bobdrzyzgula/VSM-Base/hardware/mcu-controller-rectified/netlist.txt

<+3V3> A1.L14
<+3V3> C15.1
<+3V3> C16.1
<+3V3> C5.1
<+3V3> J4.1
<+3V3> J5.1
<+3V3> J6.1
<+3V3> R14.1
<+3V3> R24.1
<+3V3> R25.1
<+3V3> R28.1
<+3V3> R9.1
<+3V3> RV2.1
<+3V3> U4.1
<+3V3> U5.1
<+3V3> U6.1
<+5V> C12.1
<+5V> C13.1
<+5V> D1.1
<+5V> D2.2
<+5V> K1.1
<+5V> PS1.3
<GND> A1.L2
<GND> A1.R4
<GND> C10.2
<GND> C11.2
<GND> C12.2
<GND> C13.2
<GND> C14.2
<GND> C15.2
<GND> C16.2
<GND> C17.2
<GND> C18.2
<GND> C19.2
<GND> C20.2
<GND> C3.2
<GND> C4.2
<GND> C5.2
<GND> C6.2
<GND> C7.2
<GND> C8.2
<GND> C9.2
<GND> J4.3
<GND> J5.3
<GND> J6.4 R18.2
<GND> PS1.4
<GND> Q2.2
<GND> R13.2
<GND> R29.2
<GND> RV2.3
<GND> SW1.2
<GND> SW2.2
<GND> U2.4
<GND> U3.2
<GND> U4.3
<GND> U5.3
<GND> U6.3
A1.L10 C8.1 R19.2
A1.L11 C7.1 R17.2
A1.L12 C6.1 R16.2
A1.L4 D2.1
A1.L8 C19.1 R27.2
A1.L9 C9.1 R20.2
A1.R12 C11.1 SW2.1
A1.R13 C14.1 R21.2
A1.R14 C10.1 SW1.1
A1.R3 C17.1 R22.1
A1.R5 C18.1 R23.1
A1.R6 R11.2
A1.R7 R12.1
A1.R8 C3.1 R9.2 U2.5
A1.R9 C4.1 R15.1
BR1.1 J1.2 J2.3 PS1.2 R8.1 RV1.2
BR1.2 T1.1
BR1.3 D3.1 J3.1
BR1.4 D3.2 J3.2
C2.1 R6.2
C2.2 Q1.2 R4.1 T1.2
C20.1 R26.2 R28.2 R29.1 T1.3
D1.2 K1.2 Q2.3
F1.1 J1.1
F1.2 F2.1 J2.2 K1.3 R7.1 RV1.1
F2.2 PS1.1
J1.3 J2.1
J4.2 R16.1
J5.2 R17.1
J5.4 J6.3 R21.1
J6.2 R18.1 R19.1
K1.4 Q1.1 R5.1 R6.1
Q1.3 R5.2 U3.4
Q2.1 R12.2 R13.1
R11.1 U3.1
R14.2 R15.2 U4.2
R20.1 RV2.2
R22.2 R24.2 U5.2
R23.2 R25.2 U6.2
R26.1 R27.1 T1.4
R4.2 U3.6
R7.2 U2.1
R8.2 U2.2
