bobdrzyzgula/VSM-Base/hardware/mcu-controller-dc/netlist.txt

<+3V3> A1.L14
<+3V3> C15.1
<+3V3> C16.1
<+3V3> C5.1
<+3V3> J4.1
<+3V3> J5.1
<+3V3> J6.1
<+3V3> R14.1
<+3V3> R24.1
<+3V3> R25.1
<+3V3> RV2.1
<+3V3> U4.1
<+3V3> U5.1
<+3V3> U6.1
<+5V> C12.1 C13.1 PS1.3
<+5V> D2.2
<GND> A1.L2
<GND> A1.R4
<GND> A2.LGND
<GND> A2.PGND
<GND> C1.2
<GND> C10.2
<GND> C11.2
<GND> C12.2
<GND> C13.2
<GND> C14.2
<GND> C15.2
<GND> C16.2
<GND> C17.2
<GND> C18.2
<GND> C2.2
<GND> C20.2
<GND> C3.2
<GND> C4.2
<GND> C5.2
<GND> C6.2
<GND> C7.2
<GND> C8.2
<GND> C9.2
<GND> D1.2
<GND> J1.2
<GND> J4.3
<GND> J5.3
<GND> J6.4 R18.2
<GND> PS1.2
<GND> Q1.2
<GND> R11.2
<GND> R2.2
<GND> R4.2
<GND> R6.1
<GND> R8.2
<GND> RV2.3
<GND> SW1.2
<GND> SW2.2
<GND> U4.3
<GND> U5.3
<GND> U6.3
A1.L10 C8.1 R19.2
A1.L11 C7.1 R17.2
A1.L12 C6.1 R16.2
A1.L4 D2.1
A1.L5 C20.1 R1.2 R2.1
A1.L6 R7.2 R8.1
A1.L7 R5.1 R6.2
A1.L8 R3.2
A1.L9 C9.1 R20.2
A1.R12 C11.1 SW2.1
A1.R13 C14.1 R21.2
A1.R14 C10.1 SW1.1
A1.R15 A2.FLT
A1.R2 R10.1
A1.R3 C17.1 R22.1
A1.R5 C18.1 R23.1
A1.R6 A2.PWM
A1.R7 A2.DIR
A1.R8 A2.SLP
A1.R9 C4.1 R15.1
A2.CS R3.1
A2.OUTA C19.1 M1.1 R5.2
A2.OUTB C19.2 M1.2 R7.1
A2.VIN C1.1 C2.1 C3.1 D1.1 F1.2 PS1.1 R9.1
A2.VM R1.1
A2.VREF R4.1
F1.1 J1.1
J4.2 R16.1
J5.2 R17.1
J5.4 J6.3 R21.1
J6.2 R18.1 R19.1
Q1.1 R10.2 R11.1
Q1.3 R9.2
R14.2 R15.2 U4.2
R20.1 RV2.2
R22.2 R24.2 U5.2
R23.2 R25.2 U6.2
