bobdrzyzgula/VSM-Base/docs/motor-control/12-sources.md

# Sources

1. [Universal motor](https://en.wikipedia.org/wiki/Universal_motor), Wikipedia.
2. G. V. Fay, [*Direction and Speed Control for Series, Universal and Shunt Motors*](https://ftp.mirrorservice.org/sites/www.bitsavers.org/components/motorola/_appNotes/AN-0443_Direction_And_Speed_Control_For_Series_Universal_And_Shunt_Motors.pdf), Motorola AN-443.
3. [Resistance, carbon stack](https://physicsmuseum.uq.edu.au/resistance-carbon-stack), University of Queensland Physics Museum.
4. K. Hayashi, [*Carbon Pile for Automatic Voltage Regulators, Part 2*](https://www.jstage.jst.go.jp/article/tanso1949/3/2/3_2_56/_article), Tanso 3(2):56–59, 1953.
5. [Old Kenmore sewing machine foot control repair](https://softsolder.com/2009/03/10/old-kenmore-sewing-machine-foot-control-repair/), softsolder.com, March 2009.
6. [Help understanding a sewing machine pedal](https://www.eevblog.com/forum/beginners/help-understanding-a-sewing-machine-pedal/), EEVblog forum.
7. I. Skalka, [*Low-Cost Universal Motor Phase Angle Drive System*](https://nxp.com/docs/en/application-note/AN1662.pdf), Freescale AN1662.
8. [Speed Controller for Universal Motors](https://www.siliconchip.com.au/Issue/2002/October/Speed+Controller+For+Universal+Motors), Silicon Chip, October 2002.
9. [Autotransformer](https://en.wikipedia.org/wiki/Autotransformer), Wikipedia.
10. [TDA1085C universal motor speed controller](https://onsemi.com/download/data-sheet/pdf/tda1085c-d.pdf), onsemi data sheet, Rev. 10, July 2007.
11. [KBIC variable speed DC motor control](https://forums.parallax.com/uploads/attachments/41167/71583.pdf), KB Electronics data sheet D-210, 1998.
12. [KBMM variable speed DC motor control](https://motorsandcontrol.com/media/document/file/datasheets/9449.pdf), KB Electronics data sheet D-215.
13. [KBWC solid-state speed controls](https://moen.nidec.com/drives/-/media/Project/Nidec/KB/documents/triad-fan-controls/data-sheets/kbwc-data-sheet-031919.ashx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), KB Electronics / Nidec data sheet.
14. [KBSI-240D signal isolator](https://motorsandcontrol.com/kb-electronics-9431-kbsi-240d-signal-isolator-stand-alone), Motors & Control product page.

The base's own parts, used in §11: Bourns 91–99 series panel control datasheet;
Omron SS subminiature basic switch, Cat. No. B032-E1-14; Schurter KE IEC inlet
datasheet; WAGO 221-413. Links are in the User's Guide's knee-controller
chapter.
