bobdrzyzgula/VSM-Base/docs/images/photos/99k-front.jpg

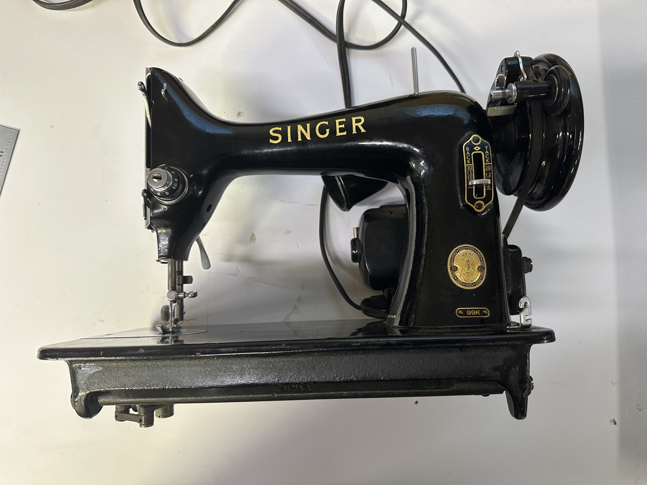
docs/images/photos/99k-front.jpg
