bobdrzyzgula/VSM-Base/docs/images/photos/99k-rear-corner-underside.jpg

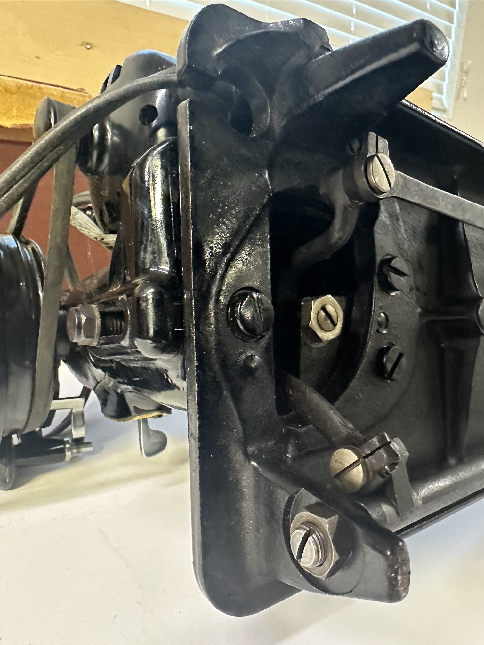
docs/images/photos/99k-rear-corner-underside.jpg
