bobdrzyzgula/VSM-Base/docs/images/renders/base-none.png

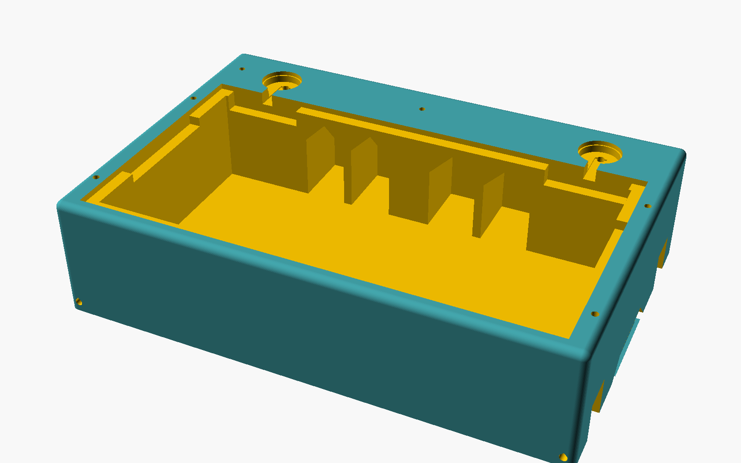
docs/images/renders/base-none.png
