bobdrzyzgula/VSM-Base/docs/images/renders/base-top.png

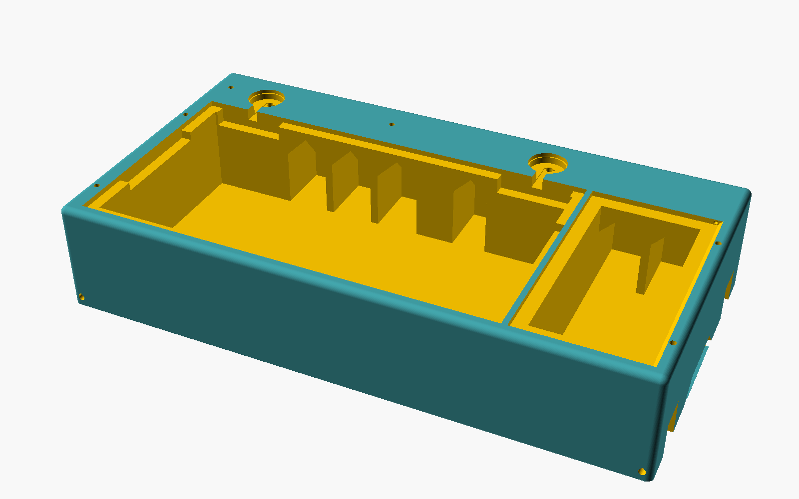
docs/images/renders/base-top.png
