bobdrzyzgula/VSM-Base/docs/images/renders/end-underside.png

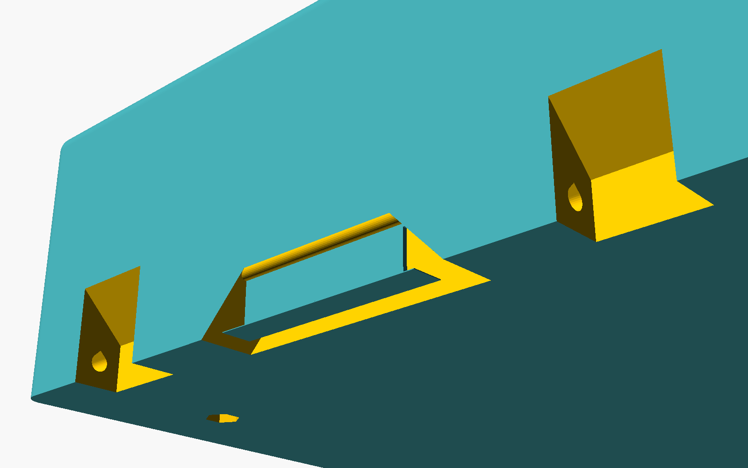
docs/images/renders/end-underside.png
