bobdrzyzgula/VSM-Base/docs/images/renders/exploded.png

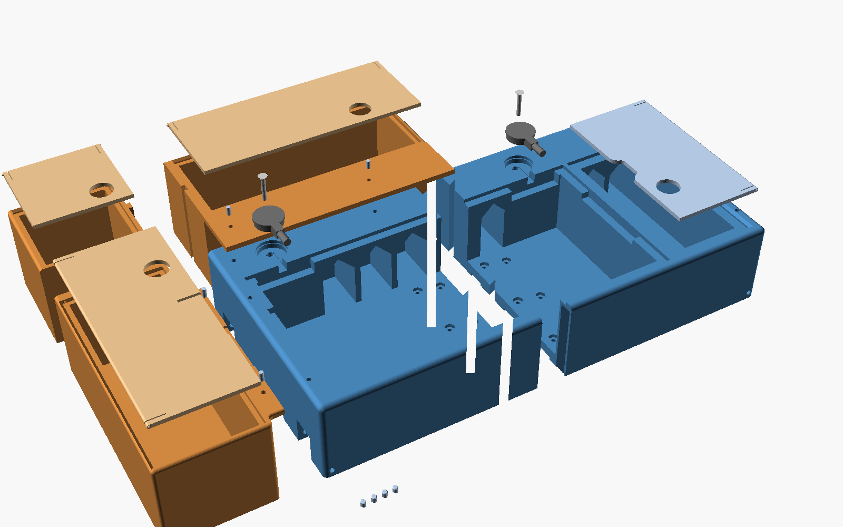
docs/images/renders/exploded.png
