bobdrzyzgula/VSM-Base/docs/images/renders/split.png

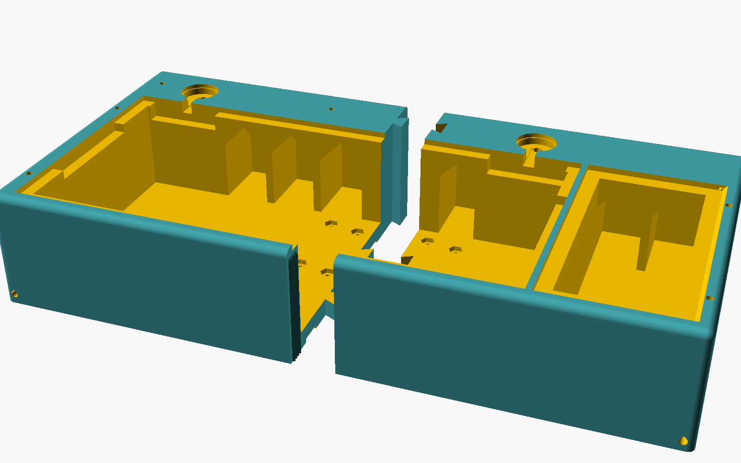
docs/images/renders/split.png
