bobdrzyzgula/VSM-Base/scad/vsm_base.scad

// SPDX-License-Identifier: MIT
// VSM Base, version 74
// Copyright (c) 2026 Robert Drzyzgula
// All dimensions in mm unless noted.
//
// Coordinate system: the base's outer front-left-bottom corner is at the
// origin. +X runs left to right (balance wheel / small compartment at +X),
// +Y runs front to back (hinges at the back), +Z is up.
//
// The bed seat, machine cavity, and hinge positions are derived from the
// measured Singer 99 bed casting rather than from an old wooden base.
//
// v5: flat split with placed dovetail keys, joined by steel mending plates
// (McMaster 1394A34)
// recessed into the underside, with nut traps on the cavity floor;
// nut traps under the hinge screws; gabled lightening tunnels in the
// back wall between the hinges.
//
// v6: tunnel and cord-hole floors flush with the cavity floor; a tunnel
// behind the small compartment; compartment_option "none" (base fitted
// to the bed alone); hinge_type selects the hinge, and the hinge's
// footprint drives the back rim, hinge position and keep-outs.
//
// v7: removable extensions that sit on the table and reach over the base
// rim with a lip whose top is level with the machine bed: a back
// compartment / outfeed support, a left compartment / extension, and a
// left-rear corner compartment that dovetails to both. Each has a lid set
// in a frame, optional bobbin-plate trenches, and pegs that drop into
// holes in the base rim. `part` selects what to render.
//
// v8: hinge moved 2 mm back (pin square no longer enters the seat);
// reliefs cut below the bed ledge where the casting is thickened, from a
// list; back-wall tunnels skip the reliefs.
//
// v9: part "all" (exploded layout, base split); bobbin-plate trenches
// measured from the bed edges, with the 99's left trench on by default;
// snap-in dimple hinges on every lid, including a new lid for the base's
// small compartment.
//
// v10: split dovetails set by flare angle (default 30 degrees) with less
// clearance, cutting pull-apart play from about 1 mm to about 0.3 mm.
//
// v11: left lip starts at the bed's front edge, with a rounded top edge
// and a filleted inside corner where it meets the extension body; the
// body's front-right edge is rounded. Lids are turned over for printing
// by rotation (v9-v10 mirrored them). New part "test_parts".
//
// v12: end walls 7/8" thick with handholds under each end, after the old
// wooden base; notches either side of each handhold with 3/16" steel rods
// across them for a carrying harness; sacrificial membrane over the plate
// screw holes; extension top slices in test_parts print upright.
//
// v13: handholds open to the end face, with a rounded lip and a ceiling
// climbing 45 degrees into the wall, printed over a thin knock-out wall;
// rod-notch ceilings climb 45 degrees toward the face (no support needed);
// the test_parts center slice is floor plus full-height wall stubs at the
// joint.
//
// v14: a small breakaway tab ties each knock-out wall to the end of its
// pocket, so the wall stays with its part when a slicer splits objects.
// Peg holes in the right rim too, for future right-side extensions.
//
// v15: machine profiles. Pick the machine from a list; the casting
// measurements, reliefs and bobbin trenches come from the profile table.
// Choose "Custom" to use the settings in the "Custom machine" section
// instead. A one-layer brim around the foot of each knock-out wall.
//
// v16: vertical V-serrations across the front wall's joint faces, hidden
// inside the wall, so the front faces register flush (the right half is
// lowered onto the left). Harness rods stop short of the face and printed
// plugs close the holes (part "rod_plugs"). The console ends with a
// hardware list for the configuration, with screw lengths rounded up to
// stock sizes.
//
// v17: the "outlet" compartment. The outlet stands on the compartment
// floor against the right end wall, face to the left, held by a #8 screw
// into a heat-set insert in the wall and located by low curbs on the
// floor; the plugs point straight at the cord pass-through. Its lid hinges
// on the left and has two cord slots, each on a chosen edge. Wider
// default pass-through.
//
// v18: lid type per lid (hinged, lift-out or none) and lid style (solid or
// perforated); a `compartments` list giving each accessory bay's usable
// interior, for organizer inserts that include this file; console output
// only when something is rendered (`report`); the outlet can be held by a
// through screw from the end face instead of a heat-set insert; part
// "hinge_coupon", a hinge recess block that doubles as a hinge insert for
// a wooden base.
//
// v19: freestanding extension boxes (parts back_box, left_box, corner_box);
// a wider ledge on a hinged extension lid's hinge side, so an open lid
// stays clear of the bay, with the corner bay kept square; a thumb-tab lid
// grip as an alternative to the finger hole; a notch in the base lid's left
// edge to clear the motor boss, from the machine profile.
//
// v20: lid hinges hold better: less end float at the hinge ends, a closer
// recess, steeper bump flanks, and stiffer flex tabs and deeper engagement
// by default (from print tests in PLA and PETG); part "lid_hinge_test" to
// tune them quickly. ext_top_adjust trims the extensions' top plane to the
// real bed. Extension pegs can be separate, replaceable parts (printed
// lying down, or cut from 3/16" rod) instead of molded into the lip.
//
// v21: optional turn button on the front rim, after the wooden bases: a
// smooth raised pad level with the bed, a printed button on a #8 screw
// with click detents at closed (over the bed edge) and open, and a nut
// slot reached from inside the machine cavity (part turn_button).
//
// v22: part "all" is now every part of the build, flat on the bed in print
// orientation and grouped into printer-sized plates; part "exploded" is
// the old exploded view; print_plate picks one plate. Plates keep parts of
// one kind together, put supported parts together only when their support
// interface is on the same layer, and leave room for a purge tower. A
// printer edge margin; the outlet is held by a through screw by default;
// fractional Customizer steps where they matter.
//
// v23: no mending-plate pockets on an unsplit base; optional knock-out
// walls closing both ends of the cord pass-through (an outlet base can be
// used for storage until they are tapped out), and a removable
// pass-through cover (part passthrough_cover).
//
// v24: organizer inserts: bobbin trays for the corner bay (a second stack
// goes in the freestanding corner box); notion trays for the back or left
// bay in 30-10 mm and custom heights, plain or compartmented; a spool tray.
//
// v25: the back lip runs on past a short back extension to reach the last
// back peg hole, its free end rounded and filleted into the body; LIGHT and
// MOTOR recessed into the outlet compartment floor by their receptacles;
// part split_test, the front of the split joint (serrations and first
// dovetail) for a quick fit test.
//
// v26: knee controller (compartment_option "knee"): a knee bar turns a
// shaft in the right bay; a gear sector turns a pot that replaces the donor
// speed-control board's slide pot, a snap switch cuts the motor at rest,
// and hard stops on the front face take the knee's force. Bulkhead, board
// posts, cover, cord clamp; parts knee_sector, knee_pinion, knee_hub,
// knee_cover, knee_cord_clamp, and a knee_assembly cutaway view. (v29
// reworks the mechanism; see below.)
//
// v27: knee controller power options (knee_power): the standard pedal
// cordset's molded entry with its steel clip, or a fused IEC C14 inlet
// with a Wago lever-connector junction under the bed, or a bare cord and
// clamp. Board posts fixed (handedness) and measured; the board turned end
// for end, with room for its spade connectors; earth contact for the
// shaft; cover vents for motors over 1 A; pot set at the hard stop; part
// knee_entry_test.
//
// v28: knee return spring chosen (McMaster 9271K585 / 9271K651) with its
// torque in the console; the switch's actuating point from Omron's
// drawing (5.3 mm from the lever's free end).
//
// v29: knee controller reworked to a new feel: about 1 lb at rest rising
// 1.5 lb/in, an inch of dead travel before the motor starts, full speed at
// 2" and a hard stop at 2.25". The return spring is now a compression
// spring in a housing on the front face, pushed by a crank on the knee hub,
// with steel screw stops for rest and full travel, so the knee's force never
// reaches the shaft, its set screws or the gears. Two-stage gearing (about
// 11.75:1) through an idler on a stub pin; the switch lies under the shaft,
// worked by a cam on the sector. Parts knee_idler, knee_spring_housing and
// knee_spring_cap; the stop pin is gone.
//
// v30: organizer trays from the first prints: compartment trays default to
// a 2" target cell (2 x 4 in the back or left bay); small gussets at the
// foot of the long walls of every notion tray and the spool tray's curbs,
// where a thin wall meets the floor at a single layer line; the spool
// tray's curb is 14 mm tall (was 10), to stiffen its floor along its length.
//
// v31: the small compartment can be an attached bay (compartment_mount):
// a separate part screwed to the base's right end, for beds too long to
// print with a built-in compartment. Four M5 screws from inside the machine
// cavity into heat-set inserts in the bay's inner wall, and two rod_d
// dowels, hold it; its top is flush with the base, and it has its own
// handhold and harness rods so the whole carries as one. The base keeps a
// handhold, rods and right-rim peg holes of its own. Storage only for now;
// its lid defaults to none. Parts right_bay and attach_test.
//
// v32: part hinge_nut_tool, a rod with a tapered tip that holds a nut in
// its trap from below while the hinge screw is started from above.
//
// v33: hinge_type "none", a base for a machine without hinges: no hinge
// recesses, nut traps, checks or hardware; the back-wall tunnels run the
// whole back wall. The back rim stays as wide as with hinges unless
// back_rim_width is set, so extensions are shared.
//
// v34: hinge_type "printed", a hinge to print for machines without usable
// hinges: a printed arm carries a steel pin into the bed's hinge hole and
// turns on a steel pivot rod held in a printed block, which sits in a
// recess in the back rim on the hinge screw and nut trap. The pin is set at
// the bed hole's height whatever the machine. A stop face on the block
// holds the machine at ph_stop_angle when tilted back. Parts
// printed_hinges (two arms and two blocks) and printed_hinge_test (rod
// fits); the back extension's lip is notched around the hinges.
//
// v35: printed hinge: the stop is a tail on the arm behind the pivot,
// landing in a pocket in the block, and the block is held by a screw from
// below into a nut pressed into its underside; the arm and cheeks are cut
// flush with the rim where ph_min_cover allows. Pin diameter and depth
// come from the profile. Machines set flush (bed_flush) or standing on
// their feet (foot_height_mm, which sets the floor); seat depth no longer
// tied to the lid rabbet. Lips recessed into the rim when the bed stands
// less than lip_min_t above it, with trims (back_trim, left_trim) for use
// without extensions; cord_slot through the back rim, with cord_slot_trim.
// Kenmore 158-14001 profile (measured by Bob Drzyzgula).
//
// v40: Kenmore profile named 158-14001: the Customizer reads a number
// such as 158.14001 in a menu entry as a number and shortens it, so
// profile names use a dash. Profiles are still found by the start of the
// name.
//
// v42: Customizer presets "<profile> (as Custom)" in vsm_base.json, built
// by tools/make_presets.py from the profiles; the console prints profile
// values to 8 decimals for them.
//
// v43: in the "all" view, each plate is as wide as the bed or its widest
// part, so a base printed whole no longer runs into the next plate. The
// header's version number tracks again.
//
// v44: part "tools": the things printed to help build or measure rather
// than parts of the base: the hinge nut tool, the printed hinge's rod-fit
// test and the foot-locating rig's two halves. test_parts stays for pieces
// of the base for trying fits.
//
// v45: no model changes; the guide's title page gives this version number
// for development builds ("Development Build v45").
//
// v46: printed hinge: the block's nut slides into a slot from its front
// face, with plastic under it, so the screw from below clamps the block
// (the nut in an open pocket underneath was drawn out of it, clamping
// nothing); the recess's front wall closes the slot. From Bob's review.
//
// v47: rod-fit test: a plus, not a dash, over the sixth (running-fit) hole,
// and the step between holes is ph_test_step (0.1; finer for a second bar).
//
// v48: an arrow engraved in the printed hinge arm's bottom face, pointing
// to the pin, since the arm isn't symmetrical top to bottom.
//
// v49: printed hinge's stop at 100 degrees, where a lollipop hinge's
// knuckle stops a 99K (measured by Bob), so the machine tips back far
// enough to service; the stop's load is bounded by the base tipping up.
//
// v50: part tilt_prop (also in tools): a stand behind the base whose
// cradle catches the machine's arm tipped back to 90 degrees; profile key
// tilt_prop_mm (99K: arm 6" above the table, 1" cradle radius, from Bob).
//
// v51: the tilt prop's post is opened up into two legs, front and back.
//
// v52: tilt prop with a flat, level top for machines without a round arm:
// a profile cradle radius of 0, or tilt_prop_top = "flat".
//
// v53: outlet compartment: the cords can leave through slots in the walls
// (outlet_cord_exit): the power cord out the back and the controller cord
// out the front, or both out the back, the controller cord round a
// 180-degree bend into a channel in the floor, with retention lips; trims
// (part outlet_trims) fill the slots above the cords, with eased openings.
// The tunnel behind the compartment stops short of the slots.
//
// v54: the outlet's cords leave its ends 4.7 mm in from its back (the
// end-wall side), per Bob; slots beside the end wall sit flush with it.
//
// v55: printed hinge rods from stock: ph_pin_len (the pin goes into the
// bed's hole by what's left past the arm) and ph_pivot_len (the block's
// cheeks follow); the profile's hinge_hole_depth_mm (22 on both) bounds
// the pin, and the console gives the lengths that fit.
//
// v56: part compartment_test: the base's right end, from just left of the
// divider (both ends of the pass-through) to the end wall with its
// handhold and rods, to build and try the compartment by itself.
//
// v57: printed hinge: ph_pin_press, the arm's pin-hole fit, separate from
// ph_press (now the block's pivot holes only); the fit-test bar's pin
// holes step around it. The nut slot's ceiling is raised 0.4 mm and
// chamfered at 45 degrees up to what room the block has, shortening the
// sagging bridge, and its mouth is eased.
//
// v58: printed hinge: the screw's way up from under the base is a round
// counterbore for a pan or socket head (ph_head_d, 9.5 mm for #8), not a
// hex trap, since the nut is now in the block; in the hinge coupon too.
// The lollipop hinge keeps its nut trap.
//
// v59: Singer 99K profile: hinge holes 22 mm deep (measured).
//
// v60: corner piece bins. Extensions are at least 100 mm (left width,
// back depth). The corner's bobbin bin stays the bay a 100 x 100 corner
// gives, in the inner corner; the corner's extra width or depth becomes
// open bins to its left and behind it (corner_layout: 2x2, long left,
// long back), with ext_divider walls under the one lid, and strips under
// ext_bin_min left solid. corner_bay_square is retired: the bobbin bin is
// always square.
//
// v61: bins in all three pieces. The left and back extensions keep the
// bay a 100 mm piece gives, against the base, and their extra width or
// depth becomes an outer bin (1+1) or two (1+2, split along the length;
// left_ext_layout, back_ext_layout). left_ext_double / back_ext_double
// size the width or depth for an outer bin matching the inner one, in the
// corner and its neighbour alike, the larger need winning and the other
// piece's bin walled to the same size. Dividers under a single lid get a
// finger notch at the middle (ext_divider_notch).
//
// v62: per-bay lids (back_lids, left_lids, corner_lids = "per bay"): each
// bay its own rabbet, the bays spaced for a ledge on either side of an
// ext_frame rib, the dividers tapered at 45 degrees under the ledges to
// ext_divider at the floor. The inner bay's lid keeps the piece's lid
// settings; the outer bins' lids share bin_lid_type and bin_lid_hinge. A
// bin under bin_lid_min inside gets no lid; a hinged bin lid too small to
// hinge becomes lift-out. New part bin_lids.
//
// v63: view part extensions_view: the three extension pieces in place,
// with their lids lifted by `explode` (for the documentation).
//
// v64: the exploded view shows the printed hinges taken apart over their
// recesses: block lifted, arm above it, pin drawn out of the arm's front,
// pivot rod drawn out to the side.
//
// v65: standard sizes. base_depth: the base's front-to-back size comes in
// classes of 200, 230 and 250 mm (auto: the smallest that fits), the
// spare going into the back rim, so bases of a class share a left
// extension's length. With no hinges the back rim is back_rim_thin (12 mm)
// before rounding up to the class. Extensions stand at a standard height
// (ext_height, the 99K's bed top, 88.225 mm) with the same bays: a lower
// bed raises the base by thickening its floor (base_raise); a higher one
// stands each extension on a podium (parts back_podium, left_podium,
// corner_podium) at least podium_min thick, raising the base if need be.
// back_ext_length other than 240 mm gets a note.
//
// v66: the console suggests a stock 3/16" dowel pin for the harness rods
// (the longest stock length that fits, 2 5/8" on the 99K) ahead of cut
// rod, and 7/16" pins for the podiums.
//
// v67: the split line moves left by half the dovetail keys' depth
// (split_balance), so the two halves, keys included, are the same length
// and the longer one is 4 mm shorter (the Kenmore's fits a 256 mm bed).
//
// v68: Singer 99K profile: hinge holes 9/32" (7.14 mm), measured on the
// machine (the 1/4" came from cabinet hinges). The printed hinge's pin and
// arm follow.
//
// v69: hinge_type "barrel": the vintage portable-case barrel hinge (a
// 15.2 mm steel barrel standing in a round hole, an arm pivoting in its
// slotted top on a cross pin), measured by Bob Drzyzgula. The barrel is set
// so the arm's pin meets the bed's hole, which on the 99K leaves its top
// 1.7 mm above the rim and 3.8 mm below the bed top; the arm's swing is
// relieved, the back lip notched round it, and the screw comes up from
// under the base into the barrel's tapped bottom.
//
// v70: barrel hinge: tapped depth 6 mm and washer 13.7 mm, measured.
//
// v71: a ruler on the front face (Danielle's idea, after the rulers on many
// machines' beds): one to three scales stacked from near the bottom (inch,
// centimeter or custom; inch below cm by default), each with its own
// divisions and a longer tick every so many, across the whole flat face
// between the corner round-overs, on the base and a built-in compartment
// only. Two SVG logos can go in the face's upper corners. Raised (and
// color-tagged, for a two-color 3MF) or engraved.
//
// v72: the ruler and logos can also be inlaid: engraved and filled flush
// with a separate part. Raised and inlaid marks are color-tagged with
// random colors, the ruler, each logo and the base each its own (as on the
// standalone bobbin box), and kept as separate objects, split with the base,
// so a 3MF export carries each as its own colored part. face_relief_color
// gives way to face_color_seed.
//
// v73: four more places for SVG logos, for a maker's name, model, serial
// number or date: the back face's lower corners and the bottom, centered on
// each half of the base (split or not). The back's follow face_relief; the
// bottom's are engraved or inlaid (bottom_relief). Each is color-tagged when
// raised or inlaid; eight colors in all.
//
// v74: the assembly and exploded views show lollipop hinges, as a simple
// stand-in sized from the recess settings and the profile's pin (the model
// doesn't make them), and the exploded view lifts barrel hinges out too.

include <BOSL2/std.scad>
include <BOSL2/screws.scad>

/* [Part] */
// What to render
part = "assembly"; // [assembly, exploded, all, test_parts, tools, tilt_prop, base, right_bay, base_lid, back_ext, back_lid, left_ext, left_lid, corner_ext, corner_lid, bin_lids, back_podium, left_podium, corner_podium, extensions_view, rod_plugs, outlet_cap, hinge_coupon, compartment_test, outlet_trims, foot_rig, foot_rig_left, foot_rig_right, printed_hinges, printed_hinge_test, printed_hinge_view, back_trim, left_trim, cord_slot_trim, back_box, left_box, corner_box, ext_pegs, lid_hinge_test, turn_button, passthrough_cover, split_test, attach_test, hinge_nut_tool, knee_assembly, knee_sector, knee_idler, knee_pinion, knee_hub, knee_spring_housing, knee_spring_cap, knee_cover, knee_cord_clamp, knee_entry_test, bobbin_assembly, bobbin_trays, bobbin_bottom, bobbin_upper, bobbin_test, notion_assembly, notion_set, notion_30, notion_25, notion_20, notion_15, notion_10, notion_custom, spool_tray, spool_assembly, notion_test]
// Spacing between parts in the "exploded" layout
explode = 40;
// Test parts: height of the top slices
test_top_h = 12.7;
// Test parts: height of the base bottom slice above the cavity floor
test_floor_extra = 3;
// Test parts: width of the dovetail coupon (X)
test_coupon_w = 40;
// Test parts: width of the center slice (X); covers the plates at 112
test_slice_w = 112;
// Test parts: full-height wall stubs either side of the joint in the center slice
test_stub_w = 20;
// Test parts: size of the hinge block (X), centered on the left hinge
test_hinge_w = 40;
// Gap between the two halves of split test parts
test_split_gap = 10;
// Split test (part split_test): height of the front-wall stubs; 0 = full height
split_test_h = 30; // [0 : 1 : 100]
// Split test: width either side of the split line
split_test_w = 25; // [10 : 1 : 60]
// Printer build volume, for the size check and the print plates
printer_size = [256, 256, 256];
// Keep parts this far inside the bed's edges (room for supports, brims and skirts)
printer_margin = 8; // [0 : 1 : 30]
// Print plates (part all): 0 = every plate, laid out side by side; N = plate N only
print_plate = 0; // [0 : 1 : 30]
// Purge tower kept clear on plates with supported parts (square, mm); 0 = none
purge_tower_size = 40; // [0 : 5 : 80]
// Space between parts on a plate
plate_gap = 8; // [2 : 1 : 30]

/* [Options] */
// Small-compartment option ("none" = base fitted to the bed alone)
compartment_option = "storage"; // [none, storage, outlet, knee, jack]
// How the small compartment joins the base: built-in (one body with the base), or attached (a separate bay screwed to the base's right end, for beds too long to print with a built-in compartment; storage only, for now)
compartment_mount = "built-in"; // [built-in, attached]
// Hinge type
hinge_type = "lollipop"; // [lollipop, printed, barrel, none]
// Split into two dovetailed halves for printing
split = true;

/* [Machine] */
// Your machine. A listed machine supplies every setting in the "Custom machine" section; choose Custom to use those settings instead.
machine = "Singer 99K"; // [Singer 99K, Kenmore 158-14001, Custom]
// Bed cushion thickness, compressed, in inches (1/16"); for a machine standing on its feet, the pads under the feet
bed_cushion_in = 0.0625;

/* [Custom machine: IGNORED unless machine = Custom] */
// IGNORED unless machine = Custom. Bed length, inches (99K: 12 3/16")
custom_bed_length_in = 12.1875;
// IGNORED unless machine = Custom. Bed width, inches (99K: 6 9/16")
custom_bed_width_in = 6.5625;
// IGNORED unless machine = Custom. Thickness of the flat bed plate, inches (99K: 5/16")
custom_bed_plate_thickness_in = 0.3125;
// IGNORED unless machine = Custom. Hinge hole center from each end of the bed, inches (99K: 1 7/16")
custom_hinge_hole_inset_in = 1.4375;
// IGNORED unless machine = Custom. Hinge hole center below the bed top surface, inches (99K: 3/8")
custom_hinge_hole_drop_in = 0.375;
// IGNORED unless machine = Custom. Hinge hole diameter, mm: the printed hinge's pin (99K: 9/32")
custom_hinge_pin_d_mm = 7.14375;
// IGNORED unless machine = Custom. How far the printed hinge's pin goes into the hinge hole, mm (no more than the hole's depth)
custom_hinge_pin_engage_mm = 12;
// IGNORED unless machine = Custom. Depth of the shallower hinge hole, mm (0 = not measured): it limits how long a printed hinge's pin may be
custom_hinge_hole_depth_mm = 22;
// IGNORED unless machine = Custom. Bed top flush with the base's rim (true) or standing above it by the plate less rabbit_depth (false, as for the 99K)
custom_bed_flush = false;
// IGNORED unless machine = Custom. A machine that stands on its own feet: from the plate's underside to the feet's bottoms, mm (0 = the bed rests on the ledge instead)
custom_foot_height_mm = 0;
// IGNORED unless machine = Custom. Slot through the back rim for cords leaving the casting, mm: [center from the bed's left end, width, slot bottom below the bed's top, height of the cords' channel left under the slot's trim]; all zeros = none
custom_cord_slot = [0, 0, 0, 0];
// IGNORED unless machine = Custom. Tilt prop, mm: [height above the table of what rests on it (the arm's underside) with the machine tipped back to 90 degrees, cradle radius for a round arm (0 = a flat, level top)]; height 0 = not measured
custom_tilt_prop_mm = [152.4, 25.4];
// IGNORED unless machine = Custom. Back bobbin trench, mm: [center from the bed's left end, width, length back from the bed edge, depth]; all zeros = none
custom_back_trench = [0, 0, 0, 0];
// IGNORED unless machine = Custom. Left bobbin trench, mm: [center from the bed's front edge, width, length left from the bed edge, depth]; all zeros = none
custom_left_trench = [83.34, 57.6, 40, 2.5];
// IGNORED unless machine = Custom. Notch in the base lid's left edge clearing the motor boss as the lid opens, mm: [depth, width]; [0, 0] = none
custom_base_lid_notch = [8, 23];
// IGNORED unless machine = Custom. Casting relief 1: which edge of the bed the thickened area is on (none = not used)
custom_relief_1_edge = "left"; // [none, left, right, back, front]
// IGNORED unless machine = Custom. Casting relief 1, mm: [center, length, thickness]. Center is along the edge from the bed's left end (back/front edges) or front edge (left/right edges); thickness is measured down from the bed top
custom_relief_1 = [83.34, 76.2, 15];
// IGNORED unless machine = Custom. Casting relief 2: edge
custom_relief_2_edge = "right"; // [none, left, right, back, front]
// IGNORED unless machine = Custom. Casting relief 2, mm: [center, length, thickness]
custom_relief_2 = [83.34, 76.2, 15];
// IGNORED unless machine = Custom. Casting relief 3: edge
custom_relief_3_edge = "back"; // [none, left, right, back, front]
// IGNORED unless machine = Custom. Casting relief 3, mm: [center, length, thickness]
custom_relief_3 = [36.51, 50.8, 20];
// IGNORED unless machine = Custom. Casting relief 4: edge
custom_relief_4_edge = "back"; // [none, left, right, back, front]
// IGNORED unless machine = Custom. Casting relief 4, mm: [center, length, thickness]
custom_relief_4 = [273.05, 50.8, 20];
// IGNORED unless machine = Custom. Casting relief 5: edge
custom_relief_5_edge = "none"; // [none, left, right, back, front]
// IGNORED unless machine = Custom. Casting relief 5, mm: [center, length, thickness]
custom_relief_5 = [0, 0, 0];
// IGNORED unless machine = Custom. Casting relief 6: edge
custom_relief_6_edge = "none"; // [none, left, right, back, front]
// IGNORED unless machine = Custom. Casting relief 6, mm: [center, length, thickness]
custom_relief_6 = [0, 0, 0];

/* [Bed seat] */
// Clearance between bed and seat wall, per side
bed_clearance = 0.75;
// How far the bed rests on the ledge around the machine cavity
bed_ledge = 8; // [3 : 0.5 : 15]
// Depth of the bed seat and lid rabbet below the top surface
rabbit_depth = 4; // [2 : 0.1 : 8]
/* [Body] */
// Top rim: outer face to seat/rabbet edge, front, left and right
rim_width = 9; // [5 : 0.5 : 20]
// End wall thickness at the bottom, left and right (7/8" = 22.225)
end_wall = 22.225;
// Base depth front to back: a standard class, so bases of a class share extensions; auto = the smallest that fits
base_depth = 0; // [0:Auto, 200:200 mm, 230:230 mm, 250:250 mm]
// Top rim: back of the bed seat to outer back face (0 = from the hinge and base_depth; set it to override the class)
back_rim_width = 0;
// With no hinges: the back rim before rounding up to the depth class
back_rim_thin = 12; // [8 : 0.5 : 40]
// With automatic back rim: solid behind the hinge's rear edge
hinge_back_skin = 5; // [2 : 0.5 : 15]
// Bottom thickness (the base may be raised above this to bring the bed to ext_height)
bottom_thickness = 12.7;
// Cavity depth below the top surface
inner_depth = 70;
// Solid web at the top between the bed seat and the lid rabbet
divider_web = 4; // [2 : 0.5 : 10]
// Outer edge rounding (top and vertical edges)
outer_rounding = 5; // [0 : 0.5 : 10]
/* [Small compartment] */
// Inner length of the small compartment (X)
storage_inner_length = 70;
// Lid ledge width around the small compartment
lid_ledge = 10; // [5 : 0.5 : 20]
/* [Attached bay] */
// Attached bay's lid: none (the default, since cords from the machine may lie over the bay's edge), hinged (on the edge set by base_lid_hinge), or lift-out
attached_lid_type = "none"; // [none, hinged, lift-out]
// Joint screws: socket-head cap screws through the base's right end wall, from inside the machine cavity, into heat-set inserts in the bay's inner wall
attach_screw_spec = "M5";
// Joint screw clearance hole
attach_screw_hole = 5.5; // [3 : 0.1 : 8]
// Joint screw head counterbore, in the base's end wall from the cavity side
attach_head_d = 9.5; // [5 : 0.1 : 14]
// Wall left under each screw head
attach_head_seat = 8; // [4 : 0.5 : 15]
// Heat-set insert hole in the bay's inner wall (M5)
attach_insert_d = 6.4; // [3 : 0.05 : 9]
// Heat-set insert hole depth
attach_insert_depth = 10; // [5 : 0.5 : 14]
// Joint screws: distance in from the machine cavity's front and back walls
attach_screw_inset = 12; // [6 : 0.5 : 40]
// Dowels (rod_d rod, two): depth into each part
attach_dowel_depth = 10; // [5 : 0.5 : 13]
// Dowel hole in the base: press fit (diameter under rod_d)
attach_dowel_press = 0.1; // [0 : 0.05 : 0.5]
// Dowel hole in the bay: slip fit (diameter over rod_d)
attach_dowel_slip = 0.2; // [0 : 0.05 : 0.6]
// Bay's top web between the joint and its lid rabbet
attach_web = 4; // [2 : 0.5 : 10]

/* [Cord pass-through] */
// Cord pass-through width (wide enough for both plugs' cords side by side)
cord_hole_width = 46;
// Cord pass-through height (without gable)
cord_hole_height = 36;
// Close both ends of the pass-through with knock-out walls (tap them out with a punch when you fit the outlet)
passthrough_knockouts = false;
// Knock-out wall thickness
passthrough_knockout_t = 1.6; // [0.8 : 0.1 : 3]
// Score groove around each knock-out wall's edge, on its tunnel side: depth (deeper = easier to knock out)
passthrough_score_depth = 0.6; // [0.2 : 0.1 : 1.5]
// Score groove width
passthrough_score_w = 0.8; // [0.4 : 0.1 : 2]
// Make a removable cover for the pass-through (part passthrough_cover), pushed into its compartment end
passthrough_cover = false;
// Cover: depth of the plug into the tunnel
passthrough_cover_depth = 6; // [3 : 0.5 : 15]

/* [Outlet compartment] */
// Outlet body, mm: [length, width, thickness]. Modern: 76 x 40 x 22; early Bakelite: 83 x 45 x 22
outlet_size = [76, 40, 22];
// Receptacle spacing, center to center (modern 34, Bakelite 38)
outlet_receptacle_spacing = 34; // [20 : 0.5 : 60]
// Clearance around the outlet inside its curbs, per side
outlet_clearance = 1.5;
// Outlet center, front-to-back offset from the middle of the compartment
outlet_y_offset = 0; // [-50 : 0.5 : 50]
// Height of the curbs on the floor around the outlet
outlet_curb_h = 3; // [1 : 0.5 : 8]
// Width of the curbs
outlet_curb_w = 3; // [1 : 0.5 : 8]
// How the outlet is held: a heat-set insert in the end wall (needs a soldering iron), or a flat-head screw through the end wall from outside, with a nut on the outlet's face
outlet_mount = "through"; // [through, insert]
// Screw through the outlet's center hole (drill out the membrane)
outlet_screw_spec = "#8-32";
// Through mount: clearance hole for the screw
outlet_screw_hole_d = 4.6;
// Through mount: flat-head diameter (#8: 8.4)
outlet_screw_head_d = 8.4;
// Through mount: recess the head under a printed cap (part outlet_cap)
outlet_screw_cap = true;
// Through mount: cap diameter
outlet_cap_d = 12; // [9 : 0.5 : 20]
// Through mount: cap thickness
outlet_cap_t = 2; // [1 : 0.1 : 4]
// Hole for the heat-set insert in the right end wall (use the insert maker's recommended diameter)
outlet_insert_d = 5.6;
// Depth of the insert hole into the wall
outlet_insert_depth = 12; // [4 : 0.5 : 20]
// Recess the receptacle names into the floor in front of the outlet
outlet_labels = true;
// Receptacle wired always on (the light); the other is the controlled motor output
outlet_light_side = "back"; // [back, front]
// Name for the always-on receptacle
outlet_light_label = "LIGHT";
// Name for the controlled receptacle
outlet_motor_label = "MOTOR";
// Letter height
outlet_label_size = 7; // [3 : 0.5 : 12]
// Recess depth
outlet_label_depth = 0.6; // [0.2 : 0.1 : 2]
// Edge the outlet-compartment lid hinges on
outlet_lid_hinge = "left"; // [left, right, front, back]
// Cord slot 1: lid edge it opens from
outlet_slot_1_side = "front"; // [none, front, right, back]
// Cord slot 2: lid edge it opens from
outlet_slot_2_side = "back"; // [none, front, right, back]
// Slot 1 position along its edge, mm from the lid's left end (front/back edges) or front end (right edge); 0 = automatic
outlet_slot_1_pos = 0;
// Slot 2 position along its edge; 0 = automatic
outlet_slot_2_pos = 0;
// Cord slot width
outlet_slot_w = 9; // [4 : 0.5 : 20]
// Cord slot depth in from the lid edge
outlet_slot_depth = 25;
// Chamfer on the slot's top edges, easing a cord pulled over them
outlet_slot_chamfer = 1.5;
// Where the outlet's two cords leave the compartment: through the lid's slots (lid); through slots in the walls, the power cord (from the outlet's back end) out the back and the controller cord (from its front end) out the front (front_rear); or both out the back, the controller cord running back in a channel in the floor (rear). The wall slots take trims (part outlet_trims) that leave an eased opening for the cord
outlet_cord_exit = "lid"; // [lid, front_rear, rear]
// Where the cords leave the outlet's ends: height above the floor (0 = half the outlet's height), and the cord's centre from the outlet's back, against the end wall (0 = 4.7: a cordset outlet's cords leave its ends at the center, 1/8" up from its back)
outlet_cord_z = 0; // [0 : 0.5 : 60]
outlet_cord_x = 0; // [0 : 0.1 : 40]
// Wall slots: width, and the opening left under the trim for the cord
outlet_wall_slot_w = 9; // [5 : 0.5 : 16]
outlet_cord_gap = 7; // [4 : 0.5 : 14]
// Floor channel for the controller cord (rear): width and depth, for two-wire lamp cord standing on edge (about 3 x 6 mm)
outlet_channel_w = 3.8; // [2.5 : 0.1 : 8]
outlet_channel_depth = 7; // [4 : 0.5 : 10]
// Retention lips along the channel, alternate sides: overhang, and spacing along the path
outlet_clip = 0.7; // [0.3 : 0.1 : 1.5]
outlet_clip_pitch = 25; // [10 : 1 : 60]

/* [Knee controller] */
// The knee controller (compartment_option = "knee"): a knee bar turns a shaft running front to back in the right bay. A crank on the bar's hub, outside the front face, pushes a compression spring in a housing beside it; steel screws in the housing set the rest and the hard stop, so the knee's force stays out of the shaft and gears. Inside, two gear stages turn a pot standing in for the donor board's slide pot, and a cam on the sector works a switch that cuts the motor for the first part of the travel. See the User's Guide before building: the board is live at mains voltage.
// Which way the knee pushes the bar
knee_push = "right"; // [right, left]
// Bar: drop from the shaft to where the knee meets it (12.5" = 317.5 mm)
knee_bar_drop = 317.5; // [150 : 0.5 : 450]
// Knee travel at that point where the switch closes and the motor starts; the travel before it is dead (1" = 25.4 mm)
knee_travel_on = 25.4; // [0 : 0.5 : 60]
// Knee travel at that point for full speed (2" = 50.8 mm)
knee_travel = 50.8; // [20 : 0.5 : 100]
// Knee travel at the hard stop (2.25" = 57.15 mm)
knee_travel_max = 57.15; // [20 : 0.5 : 120]
// Knee force at rest (the spring's preload), N (1 lb = 4.45 N)
knee_force_rest = 4.45; // [0.5 : 0.05 : 20]
// Knee force rise, N per mm of knee travel (1.5 lb/in = 0.263)
knee_force_rate = 0.263; // [0.05 : 0.001 : 1]
// Bar's square end (3/8" = 9.525 mm)
knee_bar_square = 9.525; // [5 : 0.025 : 16]
// Clearance on the bar's square end, per side
knee_bar_clearance = 0.15; // [0 : 0.05 : 0.5]
// Shaft diameter
knee_shaft_d = 8; // [6 : 0.5 : 12]
// Shaft axis: distance from the divider
knee_shaft_x = 17; // [10 : 0.5 : 40]
// Shaft axis: height above the bay floor; 0 = middle of the bay
knee_shaft_z = 0; // [0 : 0.5 : 60]
// Flanged bushings (2, front wall and bulkhead): [bore, outside diameter, length]
knee_bushing = [8, 12, 10];
// Bushing flange: [diameter, thickness]
knee_bushing_flange = [16, 2];
// Hole for a bushing's sleeve (press fit; FDM holes print a little small)
knee_bushing_hole = 12.1; // [8 : 0.05 : 20]
// Bulkhead (carries the rear bushing, the idler pin, the pot and the switch): distance behind the front wall's inside face
knee_bulkhead_pos = 36; // [25 : 0.5 : 80]
// Bulkhead thickness where the pot mounts (the pot's bushing must reach through it and take the nut)
knee_bulkhead_t = 3; // [2 : 0.1 : 5]
// Bulkhead height above the shaft axis
knee_bulkhead_above = 15; // [5 : 0.5 : 30]
// Gears: module (mm per tooth)
knee_gear_module = 1; // [0.5 : 0.05 : 2]
// First stage: idler pinion teeth (driven by the sector on the knee shaft)
knee_pinion_teeth = 16; // [12 : 1 : 30]
// First stage ratio, sector to idler pinion (the sector is cut from a gear with ratio x pinion teeth)
knee_ratio = 4; // [2 : 1 : 8]
// Second stage: idler gear teeth (a sector on the idler, driving the pot's pinion)
knee_gear2_teeth = 47; // [20 : 1 : 80]
// Second stage: pot pinion teeth
knee_pinion2_teeth = 16; // [12 : 1 : 30]
// Gear face width
knee_gear_face = 5; // [3 : 0.5 : 10]
// Tooth thinning per gear for backlash, at the pitch circle
knee_gear_backlash = 0.15; // [0 : 0.05 : 0.5]
// Extra center distance between the gears
knee_gear_cd_extra = 0.1; // [0 : 0.05 : 0.5]
// Direction from the shaft to the idler, degrees (0 = straight right, negative = down)
knee_idler_angle = 10; // [-60 : 1 : 60]
// Direction from the idler to the pot, degrees (-90 = straight down)
knee_pot_angle = -120; // [-180 : 1 : 0]
// Pot (Bourns 91, 5/8" square): body size
knee_pot_body = 15.88; // [10 : 0.01 : 25]
// Pot body depth behind the panel, with room for the pins and wires
knee_pot_depth = 22; // [10 : 0.5 : 40]
// Pot bushing (3/8-32 UNEF): panel hole
knee_pot_hole = 9.9; // [6 : 0.05 : 14]
// Pot bushing length
knee_pot_bushing_len = 9.53; // [5 : 0.01 : 15]
// Pot shaft diameter (1/4")
knee_pot_shaft_d = 6.35; // [3 : 0.05 : 8]
// Pot shaft length from the mounting face (B28: 7/8")
knee_pot_shaft_len = 22.23; // [12 : 0.01 : 30]
// Pot anti-rotation lug: radius from the shaft (0.305")
knee_pot_lug_r = 7.75; // [5 : 0.05 : 12]
// Pot anti-rotation lug: direction from the shaft, degrees (90 = up); turn the pot to suit
knee_pot_lug_angle = 90; // [-180 : 1 : 180]
// Pot anti-rotation lug: hole diameter
knee_pot_lug_hole = 2.6; // [1.5 : 0.1 : 4]
// Pot: total resistance, kOhm
knee_pot_r = 1000; // [10 : 10 : 5000]
// Pot: electrical travel, degrees
knee_pot_travel = 240; // [180 : 1 : 300]
// Pot: mechanical rotation, degrees (the end zones beyond the electrical travel take the overtravel to the stop)
knee_pot_mech = 300; // [180 : 1 : 330]
// Resistance span the board wants over the speed range (knee_travel_on to knee_travel), kOhm; a linear placeholder until the board is measured
knee_r_span = 220; // [10 : 5 : 2000]
// Off switch (Omron SS-5GL), lying under the shaft, lever up: body [length, height, thickness]
knee_switch_body = [19.8, 10.2, 6.4];
// Switch mounting holes: pitch, and height above the bottom (terminal) edge
knee_switch_holes = [9.5, 2.9];
// Switch operating position, from the mounting-hole line (8.8 +/- 0.8)
knee_switch_op = 8.8; // [5 : 0.1 : 15]
// Switch movement differential (release beyond the operating position)
knee_switch_md = 0.8; // [0.1 : 0.05 : 2]
// How far past the operating position the cam holds the lever at rest
knee_switch_press = 0.3; // [0 : 0.05 : 1.5]
// Actuating point: distance from the lever's free end (Omron's drawing: 14.5 mm from the lever's pivot end, so 5.3 from its free end)
knee_switch_act = 5.3; // [0 : 0.1 : 19]
// Switch body's bottom (terminal) edge above the bay floor, with room for the terminals and wires
knee_switch_floor = 5; // [2 : 0.5 : 15]
// Adjusting slots for the switch: travel up and down
knee_switch_adjust = 1.5; // [0 : 0.1 : 4]
// Switch screw clearance (M2 or #2-56)
knee_switch_screw = 2.4; // [1.8 : 0.05 : 3]
// Return spring (compression, standing in the housing beside the hub): [outside diameter, wire diameter, free length] (McMaster 9001T46: 0.6" OD, 0.072" wire, 1.25" long)
knee_spring = [15.24, 1.83, 31.75];
// Return spring: rate, N per mm (9001T46: 45 lb/in = 7.88)
knee_spring_rate = 7.88; // [1 : 0.01 : 50]
// Return spring: its maximum deflection, mm (9001T46: 26 lb at 0.668" long, 14.8 mm down)
knee_spring_max = 14.78; // [3 : 0.01 : 40]
// Crank radius, shaft to the crank pin; 0 = set from the spring rate to give knee_force_rate
knee_crank_r = 0; // [0 : 0.5 : 90]
// Board (75 x 35 mm donor board): [length, width]
knee_board = [75, 35];
// Board screw: [along from the board's notched end, across from the long edge nearer the screw]; the peg and rest post follow from it
knee_board_screw = [49.6, 12.5];
// Board orientation: 180 = notched end toward the back of the bay, spade tabs on the right; 0 = notched end forward, tabs on the left
knee_board_turn = 180; // [0, 180]
// Spade tabs, on the long edge away from the screw: positions along from the notched end
knee_board_tabs = [58, 70];
// Room beside the board for the spade connectors and their wires
knee_board_tab_room = 16; // [8 : 0.5 : 30]
// Mirror the board's posts across the board (for a board laid out the other way round)
knee_board_mirror = false;
// Board underside above the floor
knee_board_h = 8; // [4 : 0.5 : 20]
// Tallest part above the board underside
knee_board_parts_h = 13.6; // [5 : 0.1 : 40]
// Heat-set insert hole, M3
knee_insert_d = 4.6; // [3 : 0.05 : 6]
// How the controller is wired in: cordset = the standard pedal cordset's molded entry and clip (the control loop out to the cordset's junction); iec = fused IEC C14 inlet, with the motor and light wired at a junction under the bed; bare = a bare cord through a slot, held by a printed clamp
knee_power = "cordset"; // [cordset, iec, bare]
// Motor current (for the triac heating note and the cover vents)
knee_motor_amps = 1.0; // [0.2 : 0.1 : 3]
// Earth contact for the shaft: a post behind the shaft's end for a spring strip and the earth lead (iec)
knee_earth = true;
// Cordset entry: hole [width, height] (long side horizontal)
knee_entry_hole = [13.9, 8.5];
// Cordset entry: wall thickness at the hole
knee_entry_wall = 4.4; // [3 : 0.05 : 6]
// Cordset entry: dimple for the clip's bump, at the top of the hole [width, height, depth from the inside]
knee_entry_dimple = [3.4, 2.4, 2.8];
// Cordset entry: steel clip [width, height]
knee_entry_clip = [21.4, 9.5];
// Cordset entry: hole center above the bay floor (its pocket must clear the right handhold's ceiling)
knee_entry_z = 20; // [6 : 0.5 : 45]
// Cordset entry or IEC inlet: position from the bay's back wall; 0 = beside the board's spade tabs
knee_entry_pos = 0; // [0 : 0.5 : 140]
// Cordset: lead length inside, from the molded face to the connector tips
knee_entry_lead = 78; // [30 : 1 : 200]
// IEC inlet (Schurter KE snap-in, mounted on its side): panel cutout [along the wall, height]
knee_iec_cutout = [52.5, 27.5];
// IEC inlet: cutout corner radius
knee_iec_radius = 3; // [0 : 0.5 : 5]
// IEC inlet: panel thickness (KE: 1.5, 2 or 2.5 mm versions)
knee_iec_panel = 2; // [1.5 : 0.5 : 2.5]
// IEC inlet: depth behind the panel, with its connectors (check your inlet)
knee_iec_depth = 40; // [20 : 0.5 : 70]
// Junction: Wago 221-413 lever connector [width, depth, height]
knee_wago = [18.8, 18.8, 8.6];
// Junction: number of connectors (line, neutral, switched motor)
knee_wago_n = 3; // [1 : 1 : 6]
// Bare cord: [width, thickness] (flat SPT-2 about 7.5 x 4.5)
knee_cord = [7.5, 4.5];
// Bare cord: position along the right end wall, from the bay's back wall
knee_cord_pos = 14; // [8 : 0.5 : 120]
// Part knee_assembly: how far the knee is pushed, 0 (rest) to 1 (hard stop)
knee_view = 0; // [0 : 0.05 : 1]

/* [Lollipop hinge] */
// Hinge flange diameter
hinge_flange_diameter = 29; // [15 : 0.1 : 50]
// Hinge flange thickness
hinge_flange_thickness = 3; // [1 : 0.1 : 8]
// Hinge body depth below the top surface
hinge_thickness = 8; // [3 : 0.1 : 20]
// Hinge body diameter
hinge_inner_diameter = 27; // [10 : 0.1 : 50]
// Hinge pin thickness (X)
hinge_pin_thickness = 8; // [3 : 0.1 : 15]
// Hinge pin height (Z)
hinge_pin_height = 8; // [3 : 0.1 : 15]
// Hinge pin extension
hinge_pin_extension = 25; // [5 : 0.5 : 60]
// Hinge pin square projection
hinge_pin_square_projection = 10; // [2 : 0.5 : 30]
// Hinge pin allowed square projection into the bed seat
hinge_pin_allowed_projection = 2; // [0 : 0.1 : 6]
// Hinge pin internal length
hinge_pin_internal_length = 15; // [5 : 0.5 : 40]
// Extra depth below the pin for its corner to sweep through
hinge_pin_sweep_depth = 1; // [0 : 0.1 : 4]
// Hinge mounting hole diameter
hinge_mounting_hole_diameter = 5; // [2 : 0.1 : 10]
// Mounting hole center, inward from the flange's back edge
hinge_mounting_hole_offset = 9.5;

/* [Printed hinge] */
// Steel pin into the bed's hinge hole: diameter, just under the hole's; 0 = from the machine profile (9/32" for the 99K, 6 mm for the Kenmore 158-14001)
ph_pin_d = 0; // [0 : 0.01 : 12]
// How far the pin enters the bed's hole; 0 = from the machine profile. Ignored when ph_pin_len is set
ph_pin_engage = 0; // [0 : 0.5 : 30]
// Stock length of the pins, for a bought dowel pin (0 = cut to the length the console gives): the pin goes into the bed's hole by whatever is left past the arm; the console gives the lengths that fit the hole's depth
ph_pin_len = 0; // [0 : 0.5 : 80]
// Stock length of the pivot rods, for a bought dowel pin (0 = the block's width, set by ph_cheek): the block's cheeks are widened or narrowed to suit
ph_pivot_len = 0; // [0 : 0.025 : 60]
// Length of the pin pressed into the arm
ph_pin_embed = 16; // [8 : 0.5 : 30]
// Steel pivot rod, running along the back through the block and the arm: diameter
ph_pivot_d = 6.35; // [3 : 0.01 : 12]
// Pivot rod's press fit in the block: printed hole diameter minus rod diameter (try part printed_hinge_test)
ph_press = 0; // [-0.4 : 0.05 : 0.4]
// Pin's press fit in the arm: printed hole diameter minus pin diameter (try part printed_hinge_test)
ph_pin_press = 0; // [-0.4 : 0.05 : 0.4]
// Running fit: the arm's pivot hole is this much larger than the rod
ph_slip = 0.3; // [0 : 0.05 : 1]
// Plastic around the rods in the arm
ph_wall = 4; // [2.5 : 0.5 : 8]
// Arm width (X)
ph_arm_w = 14; // [8 : 0.5 : 30]
// Block cheeks either side of the arm (X)
ph_cheek = 6; // [3 : 0.5 : 15]
// Clearance between the moving arm and the block
ph_clear = 0.4; // [0.2 : 0.05 : 1.5]
// Base web left between the bed seat and the hinge recess
ph_web = 4; // [2 : 0.5 : 10]
// Screw head counterbore from under the base, for a pan or socket head (#8 pan: 8.2 mm)
ph_head_d = 9.5; // [5 : 0.1 : 16]
// Block floor under the arm
ph_floor = 3; // [2 : 0.5 : 8]
// Fit of the block in its recess, each side
ph_recess_clear = 0.2; // [0 : 0.05 : 0.6]
// Tilt-back stop: a tail on the arm, behind the pivot, comes to rest in the block at about this angle (0 = no stop, 45 to 110). 100 matches a Singer lollipop hinge's knuckle; the machine passes its balance point (about 55 degrees on a 99K) well before, and past about 75 degrees the base itself starts to tip up unless the machine is held or braced
ph_stop_angle = 100; // [0 : 1 : 110]
// Tail length behind the pivot (longer: less force on the stop, deeper block)
ph_tail = 12; // [6 : 0.5 : 25]
// Least plastic over the rods where the arm and cheeks are cut down to the rim
ph_min_cover = 2.5; // [1.5 : 0.25 : 5]
// Rod-fit test (part printed_hinge_test): the step between its five holes, around ph_pin_press and ph_press (0.05 for a finer second bar)
ph_test_step = 0.1; // [0.02 : 0.01 : 0.2]

/* [Foot-locating rig] */
// Parts foot_rig_left and foot_rig_right: a thin box that fits round the bed, to stand the machine on paper and print its inked feet. Wall height
rig_height = 80; // [30 : 1 : 150]
// Wall thickness
rig_wall = 2.4; // [1.2 : 0.2 : 5]
// Floor rim, inward from the wall (it lies under the bed's edge)
rig_rim = 10; // [5 : 0.5 : 25]
// Floor rim thickness
rig_floor = 2; // [1 : 0.2 : 5]
// Overlap of the splice tabs past the split, each way
rig_lap = 15; // [8 : 1 : 30]
// Splice bolt holes (M3)
rig_bolt_d = 3.4; // [2 : 0.1 : 5]
// Screw holes through the floor rim, to fix the rig to a board
rig_screw_d = 3.5; // [2 : 0.1 : 6]
// Marking holes in the floor rim, this far in from the bed's edges at each corner and at the split, for a pencil or awl
rig_mark_in = 5; // [3 : 0.5 : 9]
rig_mark_d = 1.6; // [0.8 : 0.1 : 3]
// Floor bars across the rig, this far in from each end of the bed (mm), to keep each half square; set them where no foot can land (0 = none)
rig_bar_in = 100; // [0 : 1 : 250]
// Floor bar width, and the height of the stiffening rib along it
rig_bar_w = 10; // [5 : 0.5 : 20]
rig_bar_rib = 5; // [0 : 0.5 : 15]
// A floor bar across the split as well (it covers the paper there)
rig_crossbar = false;
// Breakaway tie across each half's open end at the split, holding the walls while printing; snap it off at its thin necks before bolting the halves together
rig_tie = true;
rig_tie_w = 6; // [3 : 0.5 : 12]
// Mouse ears: thin discs at each half's corners, to hold them down while printing; cut off after. Off by default: a slicer's own mouse-ear brim (Bambu Studio's brim type "Mouse ear") does the same without brims round the discs
rig_ears = false;
rig_ear_d = 16; // [8 : 1 : 30]
rig_ear_h = 0.4; // [0.2 : 0.1 : 1]

/* [Tilt prop] */
// Part tilt_prop: a stand on the table behind the base that catches the machine's arm when it is tipped back to about 90 degrees, for hands-free servicing. Height of the arm's underside above the table there, mm; 0 = from the machine profile (99K: 6")
tilt_prop_h = 0; // [0 : 1 : 300]
// Top: from the profile, a cradle (for a round arm), or flat and level (for anything else)
tilt_prop_top = "profile"; // [profile, cradle, flat]
// Cradle radius (the arm's radius plus a little), mm; 0 = from the profile (99K: 1")
tilt_prop_r = 0; // [0 : 0.5 : 60]
// Flat top: depth front to back, mm
tilt_prop_flat = 50; // [20 : 1 : 120]
// Cradle width, along the arm (1.5")
tilt_prop_w = 38.1; // [20 : 0.5 : 80]
// Foot: width along the arm, and depth front to back
tilt_prop_foot = [80, 110]; // [40 : 1 : 200]

/* [Barrel hinge] */
// Barrel hinge (hinge_type = "barrel", from vintage portable cases): barrel diameter
barrel_d = 15.2; // [8 : 0.05 : 30]
// Barrel height (its top was flush with the case)
barrel_h = 17.5; // [8 : 0.05 : 40]
// Arm's pin axis above the barrel's bottom, arm level
barrel_pin_z = 11.8; // [3 : 0.05 : 30]
// Cross pin (the arm's pivot) above the barrel's bottom
barrel_pivot_z = 14.3; // [3 : 0.05 : 30]
// Cross pin in front of the barrel's axis, toward the bed
barrel_pivot_dy = 4.5; // [0 : 0.05 : 10]
// Barrel axis to the pin's tip, arm level
barrel_reach = 30; // [15 : 0.1 : 60]
// Arm's block: length (along the arm), height, width
barrel_block = [16.4, 9.3, 7.1];
// Arm's pin: diameter, and length from the block to the tip
barrel_pin = [6.85, 18.8];
// How far the arm tips back
barrel_tilt = 65; // [30 : 1 : 110]
// Clearance round the barrel and the arm's swing
barrel_clear = 0.3; // [0.1 : 0.05 : 1]
// Screw: length overall, head height, head diameter, thread diameter
barrel_screw = [35.4, 4.78, 11, 7];
// Washer under the screw head: thickness and outside diameter
barrel_washer = [1.5, 13.7];
// Depth of the barrel's tapped hole the screw may use
barrel_tap_depth = 6; // [3 : 0.5 : 12]

/* [Hinge coupon] */
// Solid margin around the hinge flange (room for the corner screws)
hinge_coupon_margin = 12;
// Floor left under the deepest hinge cut
hinge_coupon_floor = 4; // [2 : 0.5 : 10]
// Corner holes for #8 flat-head wood screws: clearance hole
hinge_coupon_screw_d = 4.6;
// Corner holes: countersink diameter at the top face
hinge_coupon_head_d = 8.4;

/* [Hinge nut traps] */
// Nut for the hinge screws (BOSL2 spec, e.g. "#8-32", "M4")
hinge_nut_spec = "#8-32";
// Nut width across flats; 0 = from the spec
hinge_nut_width = 0; // [0 : 0.05 : 20]
// Depth of the nut's upper face below the top surface
hinge_nut_depth = 21; // [8 : 0.5 : 60]
// Sacrificial bridge over the nut trap (0 = none; drill through after printing)
hinge_nut_bridge = 0.2;
// Nut tool (part hinge_nut_tool): tip diameter, to fit the nut's bore (a nylon-insert locknut's insert: 1/8")
hinge_nut_tool_tip = 3.0; // [1.5 : 0.05 : 6]

/* [Mending plates] */
// Number of plates across the split (0 = none)
plate_count = 3;
// Plate length (McMaster 1394A34: 4")
plate_length = 101.6;
// Plate width (5/8")
plate_width = 15.875;
// Plate thickness (0.070")
plate_thickness = 1.778;
// Hole centers [along, across] from the plate center (0.889" pitch, staggered 0.094")
plate_holes = [[-33.866, 2.375], [-11.289, -2.375],
               [11.289, 2.375], [33.866, -2.375]];
// Sacrificial layer over each screw hole at the pocket ceiling (0 = none); drill through
plate_hole_bridge = 0.3;
// Clearance around the plate in its pocket, per side
plate_pocket_clearance = 0.5;
// How far the plate sits up inside its pocket, so screw heads stay off the table
plate_standoff = 1.0;
// Screw clearance hole diameter (#8)
plate_screw_clearance = 4.6;
// Nut for the plate screws (BOSL2 spec)
plate_nut_spec = "#8-32";
// Nut width across flats; 0 = from the spec
plate_nut_width = 0; // [0 : 0.05 : 20]
// Nut trap depth into the cavity floor
plate_nut_trap_depth = 3.5;
// Minimum distance from the cavity walls to the plate edge
plate_wall_margin = 8; // [2 : 0.5 : 20]
/* [Nut fit] */
// Extra clearance added to nut width (applied to each side)
nut_clearance = 0.15;

/* [Casting reliefs] */
// Clearance below the casting in a relief (the reliefs themselves come from the machine profile)
relief_clearance = 1; // [0 : 0.1 : 4]
// Extra length added at each end of a relief
relief_margin = 2; // [0 : 0.5 : 10]
/* [Back wall lightening] */
// Hollow the back wall between the hinges
lighten_back_wall = true;
// Back wall thickness left behind the tunnels
back_skin = 17; // [6 : 0.5 : 40]
// Solid material above the tunnel peaks
back_top_skin = 6; // [2 : 0.5 : 20]
// Target tunnel width
tunnel_width = 30;
// Web between tunnels
tunnel_web = 6;
// Extra solid kept beyond each side of the hinge footprint
hinge_tunnel_margin = 7.5;
// Solid zone kept on either side of the split, from the cut line
split_keepout = 15;

/* [Split] */
// Which part to render when split
split_part = "both"; // [both, left, right]
// Separation between the two halves when both are shown
split_spread = 30;
// Put the split where the two halves, the left one's dovetail keys included, come out the same length (else at the middle)
split_balance = true;
// Clearance in the joint, per face
split_clearance = 0.1;
// Dovetail key width at the cut line (neck)
key_neck = 8; // [4 : 0.5 : 16]
// Dovetail flare, per side, in degrees; steeper = less pull-apart play
key_flare_angle = 30;
// Dovetail key length, past the cut line into the right half
key_depth = 8; // [4 : 0.5 : 16]
// Key positions in Y; empty = automatic (floor keys between plate rows,
// one centered in the back wall)
key_ys = [];
// Vertical V-serrations across the front wall's joint faces
serrations = true;
// Serration pitch (ridge to ridge)
serration_pitch = 3; // [2 : 0.1 : 6]
// Serration height (ridge tip beyond the cut line); pitch / 2 gives a 90-degree V
serration_height = 1.5;
// Solid wall kept between the serrations and each face of the front wall (outer skin and cavity side)
serration_setback = 2.5;
// Serrations stop this far below the bed ledge
serration_top_gap = 3; // [1 : 0.5 : 10]
// Extra clearance at the top of each groove, so the ridges never bottom out
serration_top_clear = 0.5;

/* [Extensions] */
// Include the back extension (outfeed support / compartment)
back_ext = true;
// Include the left extension
left_ext = true;
// Include the left-rear corner piece (needs both of the above)
corner_ext = true;
// Back extension length (X), from the base's left face
back_ext_length = 240;
// Back extension body depth (Y), behind the base
back_ext_depth = 100; // [100 : 0.5 : 300]
// Left extension body width (X), left of the base
left_ext_width = 100; // [100 : 0.5 : 300]
// Left extension and corner: make the width for an outer bin matching the inner one (overrides left_ext_width)
left_ext_double = false;
// Back extension and corner: make the depth for an outer bin matching the inner one (overrides back_ext_depth)
back_ext_double = false;
// Left extension past 100 mm: its outer bin whole (1+1), or split in two along its length (1+2)
left_ext_layout = "1+1"; // [1+1, 1+2]
// Back extension past 100 mm: its outer bin whole (1+1), or split in two along its length (1+2)
back_ext_layout = "1+1"; // [1+1, 1+2]
// Corner piece past 100 mm: the bobbin bin stays in the inner corner, and the rest becomes open bins left of it and behind it; with both, the far corner gets its own bin (2x2), or the left or back bin runs the full length
corner_layout = "2x2"; // [2x2, long left, long back]
// Divider wall between bins
ext_divider = 2.5; // [1.2 : 0.1 : 6]
// Least bin width inside; a narrower strip is left solid
ext_bin_min = 10; // [5 : 0.5 : 30]
// Lids: one over each piece, or one per bay (on rabbets in the dividers' tops)
back_lids = "one"; // [one, per bay]
left_lids = "one"; // [one, per bay]
corner_lids = "one"; // [one, per bay]
// Per-bay lids on the outer bins: type (the inner bay's lid keeps its piece's settings)
bin_lid_type = "lift-out"; // [lift-out, hinged, none]
// Per-bay lids on the outer bins: hinge edge
bin_lid_hinge = "back"; // [left, right, front, back]
// Least lid: a bin narrower than this inside gets no lid of its own
bin_lid_min = 15; // [10 : 1 : 40]
// Finger notch at the middle of each divider, for reaching into narrow bins (one lid only)
ext_divider_notch = true;
// Finger notch width and depth
ext_notch_w = 30; // [10 : 1 : 60]
ext_notch_d = 20; // [5 : 1 : 60]
// Gap between an extension body and the base or another extension
ext_gap = 0.3;
// Clearance between the lip and the base top
lip_clearance = 0.2;
// Least lip thickness: where the bed stands less than this above the rim (a bed set flush, say), the rim is cut down under the lips so they keep it, and trim strips (parts back_trim, left_trim) fill the cuts when the extensions are off
lip_min_t = 5.4; // [3 : 0.1 : 10]
// Clearance around the recessed lips and the trims, per side
lip_cut_clearance = 0.25; // [0.1 : 0.05 : 0.6]
// Trim to the extensions' top plane (lids, lips, trenches) against the real bed, mm; negative lowers it
ext_top_adjust = 0; // [-3 : 0.1 : 3]
// Extension floor thickness
ext_floor = 3; // [1.5 : 0.1 : 8]
// Standard extension height: every extension's top at ext_height above the table, with the same bays (the base is raised, or the extensions stand on podiums, to match the bed)
ext_standard = true;
// Standard extension height: the 99K's bed top
ext_height = 88.225; // [60 : 0.005 : 140]
// Least podium under an extension, when the bed stands above ext_height
podium_min = 5; // [3 : 0.5 : 20]
// Podium wall (it is a frame, open below)
podium_wall = 6; // [3 : 0.5 : 15]
// Frame width around each lid, at the top
ext_frame = 4; // [2 : 0.1 : 10]
// Ledge the lid rests on, inside the frame
ext_ledge = 4; // [2 : 0.1 : 10]
// Lid thickness (= depth of the lid rabbet)
ext_lid_thickness = 4; // [2 : 0.1 : 8]
// Clearance around the lid in its rabbet, per side
ext_lid_clearance = 0.3;
// Hinged lids: the ledge on the hinge side is widened so the open lid stays this far clear of the bay
ext_hinge_margin = 0.5;
// Finger hole in each lid
ext_finger_hole = 22;
// Rounding of the extensions' exposed edges
ext_rounding = 3; // [0 : 0.5 : 8]
/* [Turn button] */
// Turn button on the front rim that holds the bed's front edge down (off by default)
turn_button = false;
// Position along the front rim (X); 0 = automatic, between the split and the compartment
turn_button_x = 0;
// How far the button reaches over the bed's front edge
turn_button_overlap = 4; // [1 : 0.5 : 10]
// Button width
turn_button_w = 9; // [6 : 0.5 : 16]
// Button thickness
turn_button_t = 4; // [2 : 0.5 : 8]
// Gap between the button and the bed top
turn_button_gap = 0.3;
// Easing: how far the pad's smooth slopes run out along the rim, each side
turn_button_ease = 10;
// How far the pad swells out of the front face, enclosing the nut
turn_button_swell = 3; // [0 : 0.5 : 8]
// Below the nut, the swelling blends back into the front face over this height
turn_button_swell_taper = 10;
// Nut for the button screw (BOSL2 spec)
turn_button_nut_spec = "#8-32";

/* [Freestanding boxes] */
// Also make a freestanding version of the back extension (part back_box): same bay and lid, no lip, pegs or dovetails
make_back_box = false;
// Also make a freestanding left box (part left_box)
make_left_box = false;
// Also make a freestanding corner box (part corner_box)
make_corner_box = false;

/* [Extension pegs] */
// Holes in the base rim for the extension pegs
ext_peg_holes = true;
// Pegs: insert (separate printed pegs, part ext_pegs, printed lying down), pin (cut from rod_d rod), or molded into the lip (as before v20)
ext_peg_style = "insert"; // [insert, pin, molded]
// Peg diameter (printed pegs)
peg_d = 4; // [3 : 0.1 : 8]
// Peg length below the lip
peg_len = 3; // [1.5 : 0.1 : 6]
// Hole diameter in the base (for printed pegs; pins use rod_d + 0.2)
peg_hole_d = 4.4;
// Peg hole in the lip, over the peg diameter (the peg's crush ribs make the press fit)
peg_lip_clearance = 0.2;
// Metal pins: press fit in the lip, hole under the rod diameter
pin_lip_interference = 0.1;
// Hole depth in the base
peg_hole_depth = 3.5;
// Back-rim peg positions (X), from the base's left face: standard for every machine, so back extensions fit any base of their class; keep clear of the hinges and the split
back_peg_xs = [16, 160];
// Left-rim peg positions (Y)
left_peg_ys = [35, 150];
// Right-rim peg positions (Y), for future right-side extensions; [] for none
right_peg_ys = [35, 150];

/* [Corner dovetails] */
// Dovetail width at the mating face
ext_dt_neck = 6; // [3 : 0.5 : 12]
// Dovetail width at its head
ext_dt_head = 9; // [4 : 0.5 : 16]
// Dovetail depth into the mating wall
ext_dt_depth = 4; // [2 : 0.5 : 10]
// Dovetail clearance per face
ext_dt_clearance = 0.2;

/* [Handholds] */
// Handholds under each end
handholds = true;
// Handhold length along the end, at the bottom face (3")
handhold_bottom_len = 76.2;
// Handhold length at its top (2")
handhold_top_len = 50.8;
// Handhold height above the bottom face (1/2")
handhold_height = 12.7;
// Handhold depth into the end wall (5/8")
handhold_depth = 15.875;
// Flat underside of the lip at the face, before the ceiling climbs
handhold_lip_flat = 4; // [0 : 0.5 : 10]
// Radius rounding the lip's outer edge
handhold_lip_round = 2; // [0 : 0.5 : 6]
// Knock-out wall under the lip, removed after printing
handhold_knockout = true;
// Knock-out wall thickness
knockout_t = 1.2;
// Gap between the knock-out wall and the lip
knockout_gap = 0.2;
// Breakaway tab tying one end of the knock-out wall to the pocket end
knockout_tab = true;
// Tab height (the tab sits just under the lip gap)
knockout_tab_h = 0.8;
// Brim around the foot of each knock-out wall, so it stands until the tab joins it
knockout_brim = true;
// Brim width each side of the wall
knockout_brim_w = 5;
// Brim height (about one first layer)
knockout_brim_h = 0.2;

/* [Harness rods] */
// Rod notches and rods either side of each handhold
harness_rods = true;
// Rod diameter (3/16")
rod_d = 4.7625;
// Rod hole diameter (printed as a teardrop, point up)
rod_hole_d = 4.95;
// Rod center in from the end face
rod_x = 7; // [3 : 0.1 : 15]
// Rod center above the bottom face
rod_z = 7; // [3 : 0.1 : 15]
// Notch length along the rod
notch_len = 25;
// Clear space around the rod in the notch, behind and above it
notch_clear = 4; // [1 : 0.5 : 10]
// Distance from each outer face (front, back) to its notch
notch_inset = 25;
// Material left between a rod's blind end and the handhold
rod_stop = 5;
// Printed plug closing the open end of each rod hole (0 = no plugs; rods run to the face)
rod_plug_len = 5; // [0 : 0.5 : 10]
// Plug clearance in the hole, per side (the crush ribs make the press fit)
rod_plug_clearance = 0.1;
// Crush rib interference, beyond the hole wall
rod_plug_rib = 0.15;

/* [Left lip] */
// Radius of the rounded top edge along the lip front (also the free edges of an extended back lip)
lip_edge_round = 2; // [0 : 0.5 : 5]
// Radius of the inside corner where the lip front meets the body (also an extended back lip's corners)
lip_fillet = 5; // [0 : 0.5 : 15]

/* [Back lip] */
// Run the back lip on past a short back extension, over the base's back rim, to reach the last back peg hole
back_lip_extend = true;
// How far the lip runs past the last peg's center
back_lip_peg_margin = 10; // [6 : 0.5 : 30]
/* [Lid hinges] */
// Lid edge each lid hinges on
base_lid_hinge = "right"; // [left, right, front, back]
back_lid_hinge = "back"; // [left, right, front, back]
left_lid_hinge = "left"; // [left, right, front, back]
corner_lid_hinge = "back"; // [left, right, front, back]
// Base compartment lid: hinged (snap-in dimple hinge), lift-out (plain lid resting on the ledge), or none (rabbet left for a lid later)
base_lid_type = "hinged"; // [hinged, lift-out, none]
// Back extension lid type
back_lid_type = "hinged"; // [hinged, lift-out, none]
// Left extension lid type
left_lid_type = "hinged"; // [hinged, lift-out, none]
// Corner piece lid type
corner_lid_type = "hinged"; // [hinged, lift-out, none]
// Base compartment lid style: solid, or perforated for ventilation
base_lid_style = "solid"; // [solid, perforated]
// Back extension lid style
back_lid_style = "solid"; // [solid, perforated]
// Left extension lid style
left_lid_style = "solid"; // [solid, perforated]
// Corner piece lid style
corner_lid_style = "solid"; // [solid, perforated]
// Base compartment lid grip: finger hole, or a thumb tab reaching over a notch in the wall
base_lid_grip = "finger hole"; // [finger hole, tab]
// Base lid tab edge (front only is practical, on a lift-out lid)
base_lid_tab_edge = "front"; // [front, back, left, right]
// Back extension lid grip
back_lid_grip = "finger hole"; // [finger hole, tab]
// Back lid tab edge (back or right)
back_lid_tab_edge = "right"; // [front, back, left, right]
// Left extension lid grip
left_lid_grip = "finger hole"; // [finger hole, tab]
// Left lid tab edge (front or left)
left_lid_tab_edge = "front"; // [front, back, left, right]
// Corner piece lid grip
corner_lid_grip = "finger hole"; // [finger hole, tab]
// Corner lid tab edge (left or back)
corner_lid_tab_edge = "left"; // [front, back, left, right]
// Thumb tab width
grip_tab_w = 25;
// Thumb tab overhang past the outer face
grip_tab_over = 1.5;
// Thumb tab corner radius
grip_tab_r = 2; // [0 : 0.5 : 5]
// Thumb scoop below the tab: depth into the outer face
grip_scoop_d = 2.5;
// Thumb scoop height below the lid
grip_scoop_h = 6; // [2 : 0.5 : 12]
// Base lid motor-boss notch (size from the machine profile): inner corner radius
base_lid_notch_r = 4; // [0 : 0.5 : 10]
// Notch: radius blending it into the lid edge
base_lid_notch_flare = 10;
// Notch: front-to-back offset from the middle of the lid
base_lid_notch_offset = 0; // [-50 : 0.5 : 50]
// Perforation hole diameter
lid_perf_d = 5; // [2 : 0.5 : 12]
// Perforation pitch (hex grid)
lid_perf_pitch = 8; // [4 : 0.5 : 20]
// Solid margin kept around the lid's edges, finger hole and hinge
lid_perf_margin = 6; // [2 : 0.5 : 20]
// Hinge bump diameter at its base
lid_bump_d = 3; // [1.5 : 0.1 : 6]
// How far each bump engages the wall
lid_bump_engage = 1.0;
// Flex tab carrying each bump: length along the end
lid_tab_len = 15;
// Flex tab width
lid_tab_w = 4; // [1.5 : 0.1 : 8]
// Slot that frees the flex tab
lid_slot_w = 1; // [0.5 : 0.1 : 3]
// Bump flank angle from its axis: smaller is steeper and holds better (45 = the v19 cone)
lid_bump_angle = 35; // [15 : 1 : 60]
// Clearance at the lid's two hinge ends (less end float keeps both bumps engaged)
lid_hinge_end_clearance = 0.15;
// Clearance between bump and recess, per side
lid_recess_clearance = 0.075;
// Cut a chamfer behind the hinge so an open lid leans back and stays up
lid_open_stop = true;

/* [Inserts] */
// Spacing between parts in the insert print layouts
ins_spacing = 10; // [0 : 1 : 50]
// Bobbin diameter (class 15 and 66: 13/16"), for the bobbin trays and the spool tray
bobbin_d = 20.6375;
// Bobbin thickness (class 15 and 66: 7/16")
bobbin_t = 11.1125;

/* [Bobbin trays (corner bay)] */
// Number of trays, bottom included; 0 = as many as fit under the lid
bb_trays = 0; // [0 : 1 : 10]
// Post diameter (class 15 and 66 bores are a little over 6 mm)
bb_post_d = 5; // [3 : 0.1 : 10]
// Post grid [columns (X), rows (Y)]; cells that would crowd the center column are left empty
bb_grid = [3, 3];
// Tray floor thickness
bb_floor = 3; // [1.2 : 0.1 : 6]
// Clearance between a bobbin's top and the tray above
bb_bobbin_clear = 1; // [0 : 0.1 : 4]
// Clearance between the trays and the bay walls, per side
bb_wall_clear = 0.75; // [0.2 : 0.05 : 3]
// Tray corner radius
bb_corner_r = 2; // [0 : 0.5 : 10]
// Clearance between the top of the knob and the lid
bb_top_clear = 1; // [0 : 0.1 : 5]
// Lightening holes where four cells meet
bb_lighten = true;
// Lightening hole diameter
bb_lighten_d = 12; // [4 : 0.5 : 20]
// Pin on each post tip: diameter
bb_pin_d = 3; // [1.5 : 0.1 : 6]
// Pin height above the post shoulder
bb_pin_h = 2; // [0.5 : 0.1 : 5]
// Socket clearance around the pin, per side
bb_socket_clear = 0.2; // [0 : 0.05 : 1]
// Socket depth beyond the pin
bb_socket_extra = 0.4; // [0 : 0.1 : 2]
// Chamfer at the socket mouth (also absorbs elephant's foot)
bb_socket_chamfer = 0.6; // [0 : 0.1 : 2]
// Handle column diameter
bb_column_d = 12; // [6 : 0.5 : 20]
// Flare radius at the column's foot
bb_column_flare = 2; // [0 : 0.5 : 5]
// Knob diameter
bb_knob_d = 18; // [8 : 0.5 : 30]
// Knob height
bb_knob_h = 8; // [3 : 0.5 : 20]
// Clearance between the knob and the upper trays' center holes, per side
bb_hole_clear = 0.5; // [0.1 : 0.05 : 2]

/* [Notion trays (back or left bay)] */
// Bay the notion and spool trays go in
ot_bay = "back"; // [back, left]
// Custom tray height
ot_custom_h = 12; // [5 : 0.5 : 80]
// Tray heights shown stacked in part notion_assembly
ot_show = [25, 20, 15, 10];
// Clearance between the trays and the bay walls, per side
ot_wall_clear = 1; // [0.2 : 0.05 : 3]
// Wall thickness
ot_wall = 1.2; // [0.8 : 0.1 : 4]
// Floor thickness
ot_floor = 1.6; // [0.8 : 0.1 : 4]
// Outer corner radius
ot_corner_r = 2; // [0 : 0.5 : 10]
// Corner boss size (square, from the outer corner)
ot_boss = 9; // [5 : 0.5 : 20]
// Pin diameter
ot_pin_d = 3; // [1.5 : 0.1 : 6]
// Pin height above the wall tops
ot_pin_h = 2; // [0.5 : 0.1 : 5]
// Socket clearance around the pin, per side
ot_socket_clear = 0.2; // [0 : 0.05 : 1]
// Socket depth beyond the pin
ot_socket_extra = 0.4; // [0 : 0.1 : 2]
// Chamfer at the socket mouth (also absorbs elephant's foot)
ot_socket_chamfer = 0.5; // [0 : 0.1 : 2]
// Finger-hold lip length along each end wall
ot_grip_w = 40; // [10 : 1 : 120]
// How far the lip reaches in from the wall
ot_grip_reach = 5; // [0 : 0.5 : 15]
// Thickness of the lip at its top, above the 45-degree underside
ot_grip_t = 1.5; // [0.8 : 0.1 : 4]
// Clearance between the top tray's pins and the lid
ot_top_clear = 1; // [0 : 0.1 : 5]

/* [Notion tray compartments] */
// Divide the plain notion trays (not the spool tray) into compartments
ot_compartments = false;
// Target compartment size; the grid divides the tray evenly to come closest to it (2" gives 2 x 4 in the back or left bay; 1" gives 3 x 8)
ot_cell = 50.8; // [10 : 0.1 : 100]
// Compartments along the tray's length (0 = from ot_cell)
ot_cols = 0; // [0 : 1 : 20]
// Compartments across the tray's width (0 = from ot_cell)
ot_rows = 0; // [0 : 1 : 20]
// Divider height, as a fraction of the tray height
ot_divider_frac = 0.8; // [0.2 : 0.05 : 1]
// Divider thickness
ot_divider_t = 1.2; // [0.8 : 0.1 : 4]

/* [Spool tray] */
// Spool diameter
ot_spool_d = 38; // [20 : 0.5 : 80]
// Spool height
ot_spool_h = 44; // [20 : 0.5 : 100]
// Post diameter at the top, through the bobbin
ot_spool_post_d = 5; // [3 : 0.1 : 15]
// Post diameter at the floor; the post tapers to the top diameter at the spool top
ot_spool_post_base_d = 7; // [3 : 0.1 : 20]
// Smallest spool bore you expect (for the console check)
ot_spool_bore = 7.5; // [3 : 0.1 : 20]
// Space between neighboring spools
ot_spool_gap = 1.5; // [0 : 0.1 : 10]
// Space between the spools and the tray walls and corner bosses
ot_spool_wall_gap = 0.5; // [0 : 0.1 : 5]
// Clearance between the bobbin tops and the tray above
ot_spool_top_clear = 1; // [0 : 0.1 : 5]
// Cut the long side walls down to a curb between the corner bosses, so the spools can be grasped from the side
ot_spool_open_sides = true;
// Curb height left along the long sides (it stiffens the floor when the tray is lifted by its ends)
ot_spool_curb = 14; // [3 : 0.5 : 40]
// Radius at the bottom corners of the cutaway
ot_spool_cut_r = 5; // [0 : 0.5 : 20]

/* [Tray gussets] */
// Small triangular ribs at the foot of the trays' long walls, where a thin wall meets the floor at one layer line
ot_gussets = true;
// Gusset thickness (on the spool tray it must fit between neighboring spools)
ot_gusset_t = 1; // [0.6 : 0.1 : 3]
// Gusset reach along the floor, from the wall
ot_gusset_d = 5; // [1 : 0.5 : 15]
// Gusset height up the wall (less on low trays)
ot_gusset_h = 8; // [1 : 0.5 : 20]
// Spacing to aim for between gussets on plain trays
ot_gusset_pitch = 40; // [15 : 1 : 120]

/* [Ruler and logos (front, back and bottom)] */
// A ruler across the base's front face, from where the left corner's round-over ends to where the right one's begins (on the base and a built-in compartment; not on an attached bay or the extensions)
ruler = false;
// Scales, from the bottom up: inch, centimeter, custom, or none
ruler_scale_1 = "inch"; // [inch, cm, custom, none]
ruler_scale_2 = "cm"; // [inch, cm, custom, none]
ruler_scale_3 = "none"; // [inch, cm, custom, none]
// The ruler's bottom edge above the bottom of the base
ruler_bottom = 5; // [0 : 0.5 : 40]
// Height of each scale
ruler_scale_h = 8; // [5 : 0.5 : 15]
// Inch scale: divisions per inch, and a longer tick every so many (8 and 2: eighths, longer at the quarters; 10 and 5: tenths, longer at the half)
ruler_inch_div = 8; // [1 : 1 : 32]
ruler_inch_mid = 2; // [1 : 1 : 16]
// Centimeter scale: divisions per cm, and a longer tick every so many
ruler_cm_div = 10; // [1 : 1 : 20]
ruler_cm_mid = 5; // [1 : 1 : 10]
// Custom scale: the numbered unit in mm, its divisions, a longer tick every so many, and its name (blank for none)
ruler_custom_unit = 10; // [1 : 0.01 : 100]
ruler_custom_div = 10; // [1 : 1 : 32]
ruler_custom_mid = 5; // [1 : 1 : 16]
ruler_custom_name = "";
// Number every this many units (1 = every inch, every cm)
ruler_number_every = 1; // [1 : 1 : 10]
// Lettering size
ruler_text_size = 3.5; // [2 : 0.1 : 6]
// Narrowest line in the ruler, ticks and lettering alike (keep it at or over your nozzle's width)
ruler_line_w = 0.6; // [0.3 : 0.05 : 1.2]
// Logo files (SVG: clean outlines, no self-crossing paths) for the face's upper left and upper right corners, relative to this file's folder or a full path; blank for none
logo_left = "";
logo_right = "";
// Each logo is stretched to this box, width and height (set it to the logo's own proportions)
logo_size = [25, 15];
// Logos' distance in from the face's flat ends and down from where the top's round-over ends
logo_inset = 6; // [0 : 0.5 : 40]
// Back face: SVGs near its lower left and lower right corners, as you look at the back (so the left one is at the base's right end); for a maker's name, model, serial number, date. Blank for none
back_logo_left = "";
back_logo_right = "";
// Each back logo is stretched to this box, width and height
back_logo_size = [40, 15];
// Back logos' distance in from the face's flat ends (clear of the harness rods' holes) and up from the bottom
back_logo_inset = 6; // [0 : 0.5 : 40]
// Bottom: SVGs centered on the left and right halves of the base (where it splits, whether or not it is split), as you look at the bottom with the base tipped back onto its back edge. Blank for none
bottom_logo_left = "";
bottom_logo_right = "";
// Each bottom logo is stretched to this box, width and height
bottom_logo_size = [80, 40];
// Ruler and logos on the front and back: raised from the face, engraved into it, or inlaid (engraved and filled flush). Raised and inlaid marks are color-tagged for another filament: each mark and the base its own random color (export 3MF to keep them; needs an OpenSCAD with the Manifold backend)
face_relief = "raised"; // [raised, engraved, inlaid]
// The bottom's logos: engraved, or inlaid (color-tagged). Not raised: the base prints standing on its bottom
bottom_relief = "engraved"; // [engraved, inlaid]
// How far they stand out or cut in
face_relief_depth = 0.6; // [0.3 : 0.1 : 2]
// Change it for another set of random colors
face_color_seed = 7; // [0 : 1 : 999]

/* [Hidden] */
// Overlap so cutters break cleanly through faces
overlap = 0.5;
$fa = 2;
$fs = 0.4;

in = 25.4;

// Console report (dimensions, checks, hardware) only when something is
// rendered; a file that includes this one with part = "none" stays quiet.
report = part != "none";
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
