bobdrzyzgula/VSM-Base/(list of files, cad)

Other CAD files:
standalone/shaft-fit-collars/shaft_fit_collars.scad
