bobdrzyzgula/VSM-Base/docs/guide/90-parameters.md

# Parameter reference

This chapter is generated from the comments in `scad/vsm_base.scad` by `tools/extract_params.py`. Do not edit it by hand; change the comment in the model and rebuild.

There are 553 parameters; 551 of them appear in the Customizer. The rest are lists the Customizer cannot show, and are marked *edit in the file*.

## Part

| Parameter | Default | Description |
|---|----|---|
| `part` | `"assembly"` | What to render *Choices: assembly, exploded, all, test_parts, tools, tilt_prop, base, right_bay, base_lid, back_ext, back_lid, left_ext, left_lid, corner_ext, corner_lid, bin_lids, back_podium, left_podium, corner_podium, extensions_view, rod_plugs, outlet_cap, hinge_coupon, compartment_test, outlet_trims, foot_rig, foot_rig_left, foot_rig_right, printed_hinges, printed_hinge_test, printed_hinge_view, back_trim, left_trim, cord_slot_trim, back_box, left_box, corner_box, ext_pegs, lid_hinge_test, turn_button, passthrough_cover, split_test, attach_test, hinge_nut_tool, knee_assembly, knee_sector, knee_idler, knee_pinion, knee_hub, knee_spring_housing, knee_spring_cap, knee_cover, knee_cord_clamp, knee_entry_test, bobbin_assembly, bobbin_trays, bobbin_bottom, bobbin_upper, bobbin_test, notion_assembly, notion_set, notion_30, notion_25, notion_20, notion_15, notion_10, notion_custom, spool_tray, spool_assembly, notion_test.* |
| `explode` | `40` | Spacing between parts in the "exploded" layout |
| `test_top_h` | `12.7` | Test parts: height of the top slices |
| `test_floor_extra` | `3` | Test parts: height of the base bottom slice above the cavity floor |
| `test_coupon_w` | `40` | Test parts: width of the dovetail coupon (X) |
| `test_slice_w` | `112` | Test parts: width of the center slice (X); covers the plates at 112 |
| `test_stub_w` | `20` | Test parts: full-height wall stubs either side of the joint in the center slice |
| `test_hinge_w` | `40` | Test parts: size of the hinge block (X), centered on the left hinge |
| `test_split_gap` | `10` | Gap between the two halves of split test parts |
| `split_test_h` | `30` | Split test (part split_test): height of the front-wall stubs; 0 = full height *Range 0 to 100, step 1.* |
| `split_test_w` | `25` | Split test: width either side of the split line *Range 10 to 60, step 1.* |
| `printer_size` | `[256, 256, 256]` | Printer build volume, for the size check and the print plates |
| `printer_margin` | `8` | Keep parts this far inside the bed's edges (room for supports, brims and skirts) *Range 0 to 30, step 1.* |
| `print_plate` | `0` | Print plates (part all): 0 = every plate, laid out side by side; N = plate N only *Range 0 to 30, step 1.* |
| `purge_tower_size` | `40` | Purge tower kept clear on plates with supported parts (square, mm); 0 = none *Range 0 to 80, step 5.* |
| `plate_gap` | `8` | Space between parts on a plate *Range 2 to 30, step 1.* |

## Options

| Parameter | Default | Description |
|---|----|---|
| `compartment_option` | `"storage"` | Small-compartment option ("none" = base fitted to the bed alone) *Choices: none, storage, outlet, knee, jack.* |
| `compartment_mount` | `"built-in"` | How the small compartment joins the base: built-in (one body with the base), or attached (a separate bay screwed to the base's right end, for beds too long to print with a built-in compartment; storage only, for now) *Choices: built-in, attached.* |
| `hinge_type` | `"lollipop"` | Hinge type *Choices: lollipop, printed, barrel, none.* |
| `split` | `true` | Split into two dovetailed halves for printing |

## Machine

| Parameter | Default | Description |
|---|----|---|
| `machine` | `"Singer 99K"` | Your machine. A listed machine supplies every setting in the "Custom machine" section; choose Custom to use those settings instead. *Choices: Singer 99K, Kenmore 158-14001, Custom.* |
| `bed_cushion_in` | `0.0625` | Bed cushion thickness, compressed, in inches (1/16"); for a machine standing on its feet, the pads under the feet |

## Custom machine: IGNORED unless machine = Custom

| Parameter | Default | Description |
|---|----|---|
| `custom_bed_length_in` | `12.1875` | IGNORED unless machine = Custom. Bed length, inches (99K: 12 3/16") |
| `custom_bed_width_in` | `6.5625` | IGNORED unless machine = Custom. Bed width, inches (99K: 6 9/16") |
| `custom_bed_plate_thickness_in` | `0.3125` | IGNORED unless machine = Custom. Thickness of the flat bed plate, inches (99K: 5/16") |
| `custom_hinge_hole_inset_in` | `1.4375` | IGNORED unless machine = Custom. Hinge hole center from each end of the bed, inches (99K: 1 7/16") |
| `custom_hinge_hole_drop_in` | `0.375` | IGNORED unless machine = Custom. Hinge hole center below the bed top surface, inches (99K: 3/8") |
| `custom_hinge_pin_d_mm` | `7.14375` | IGNORED unless machine = Custom. Hinge hole diameter, mm: the printed hinge's pin (99K: 9/32") |
| `custom_hinge_pin_engage_mm` | `12` | IGNORED unless machine = Custom. How far the printed hinge's pin goes into the hinge hole, mm (no more than the hole's depth) |
| `custom_hinge_hole_depth_mm` | `22` | IGNORED unless machine = Custom. Depth of the shallower hinge hole, mm (0 = not measured): it limits how long a printed hinge's pin may be |
| `custom_bed_flush` | `false` | IGNORED unless machine = Custom. Bed top flush with the base's rim (true) or standing above it by the plate less rabbit_depth (false, as for the 99K) |
| `custom_foot_height_mm` | `0` | IGNORED unless machine = Custom. A machine that stands on its own feet: from the plate's underside to the feet's bottoms, mm (0 = the bed rests on the ledge instead) |
| `custom_cord_slot` | `[0, 0, 0, 0]` | IGNORED unless machine = Custom. Slot through the back rim for cords leaving the casting, mm: [center from the bed's left end, width, slot bottom below the bed's top, height of the cords' channel left under the slot's trim]; all zeros = none |
| `custom_tilt_prop_mm` | `[152.4, 25.4]` | IGNORED unless machine = Custom. Tilt prop, mm: [height above the table of what rests on it (the arm's underside) with the machine tipped back to 90 degrees, cradle radius for a round arm (0 = a flat, level top)]; height 0 = not measured |
| `custom_back_trench` | `[0, 0, 0, 0]` | IGNORED unless machine = Custom. Back bobbin trench, mm: [center from the bed's left end, width, length back from the bed edge, depth]; all zeros = none |
| `custom_left_trench` | `[83.34, 57.6, 40, 2.5]` | IGNORED unless machine = Custom. Left bobbin trench, mm: [center from the bed's front edge, width, length left from the bed edge, depth]; all zeros = none |
| `custom_base_lid_notch` | `[8, 23]` | IGNORED unless machine = Custom. Notch in the base lid's left edge clearing the motor boss as the lid opens, mm: [depth, width]; [0, 0] = none |
| `custom_relief_1_edge` | `"left"` | IGNORED unless machine = Custom. Casting relief 1: which edge of the bed the thickened area is on (none = not used) *Choices: none, left, right, back, front.* |
| `custom_relief_1` | `[83.34, 76.2, 15]` | IGNORED unless machine = Custom. Casting relief 1, mm: [center, length, thickness]. Center is along the edge from the bed's left end (back/front edges) or front edge (left/right edges); thickness is measured down from the bed top |
| `custom_relief_2_edge` | `"right"` | IGNORED unless machine = Custom. Casting relief 2: edge *Choices: none, left, right, back, front.* |
| `custom_relief_2` | `[83.34, 76.2, 15]` | IGNORED unless machine = Custom. Casting relief 2, mm: [center, length, thickness] |
| `custom_relief_3_edge` | `"back"` | IGNORED unless machine = Custom. Casting relief 3: edge *Choices: none, left, right, back, front.* |
| `custom_relief_3` | `[36.51, 50.8, 20]` | IGNORED unless machine = Custom. Casting relief 3, mm: [center, length, thickness] |
| `custom_relief_4_edge` | `"back"` | IGNORED unless machine = Custom. Casting relief 4: edge *Choices: none, left, right, back, front.* |
| `custom_relief_4` | `[273.05, 50.8, 20]` | IGNORED unless machine = Custom. Casting relief 4, mm: [center, length, thickness] |
| `custom_relief_5_edge` | `"none"` | IGNORED unless machine = Custom. Casting relief 5: edge *Choices: none, left, right, back, front.* |
| `custom_relief_5` | `[0, 0, 0]` | IGNORED unless machine = Custom. Casting relief 5, mm: [center, length, thickness] |
| `custom_relief_6_edge` | `"none"` | IGNORED unless machine = Custom. Casting relief 6: edge *Choices: none, left, right, back, front.* |
| `custom_relief_6` | `[0, 0, 0]` | IGNORED unless machine = Custom. Casting relief 6, mm: [center, length, thickness] |

## Bed seat

| Parameter | Default | Description |
|---|----|---|
| `bed_clearance` | `0.75` | Clearance between bed and seat wall, per side |
| `bed_ledge` | `8` | How far the bed rests on the ledge around the machine cavity *Range 3 to 15, step 0.5.* |
| `rabbit_depth` | `4` | Depth of the bed seat and lid rabbet below the top surface *Range 2 to 8, step 0.1.* |

## Body

| Parameter | Default | Description |
|---|----|---|
| `rim_width` | `9` | Top rim: outer face to seat/rabbet edge, front, left and right *Range 5 to 20, step 0.5.* |
| `end_wall` | `22.225` | End wall thickness at the bottom, left and right (7/8" = 22.225) |
| `base_depth` | `0` | Base depth front to back: a standard class, so bases of a class share extensions; auto = the smallest that fits *Choices: 0:Auto, 200:200 mm, 230:230 mm, 250:250 mm.* |
| `back_rim_width` | `0` | Top rim: back of the bed seat to outer back face (0 = from the hinge and base_depth; set it to override the class) |
| `back_rim_thin` | `12` | With no hinges: the back rim before rounding up to the depth class *Range 8 to 40, step 0.5.* |
| `hinge_back_skin` | `5` | With automatic back rim: solid behind the hinge's rear edge *Range 2 to 15, step 0.5.* |
| `bottom_thickness` | `12.7` | Bottom thickness (the base may be raised above this to bring the bed to ext_height) |
| `inner_depth` | `70` | Cavity depth below the top surface |
| `divider_web` | `4` | Solid web at the top between the bed seat and the lid rabbet *Range 2 to 10, step 0.5.* |
| `outer_rounding` | `5` | Outer edge rounding (top and vertical edges) *Range 0 to 10, step 0.5.* |

## Small compartment

| Parameter | Default | Description |
|---|----|---|
| `storage_inner_length` | `70` | Inner length of the small compartment (X) |
| `lid_ledge` | `10` | Lid ledge width around the small compartment *Range 5 to 20, step 0.5.* |

## Attached bay

| Parameter | Default | Description |
|---|----|---|
| `attached_lid_type` | `"none"` | Attached bay's lid: none (the default, since cords from the machine may lie over the bay's edge), hinged (on the edge set by base_lid_hinge), or lift-out *Choices: none, hinged, lift-out.* |
| `attach_screw_spec` | `"M5"` | Joint screws: socket-head cap screws through the base's right end wall, from inside the machine cavity, into heat-set inserts in the bay's inner wall |
| `attach_screw_hole` | `5.5` | Joint screw clearance hole *Range 3 to 8, step 0.1.* |
| `attach_head_d` | `9.5` | Joint screw head counterbore, in the base's end wall from the cavity side *Range 5 to 14, step 0.1.* |
| `attach_head_seat` | `8` | Wall left under each screw head *Range 4 to 15, step 0.5.* |
| `attach_insert_d` | `6.4` | Heat-set insert hole in the bay's inner wall (M5) *Range 3 to 9, step 0.05.* |
| `attach_insert_depth` | `10` | Heat-set insert hole depth *Range 5 to 14, step 0.5.* |
| `attach_screw_inset` | `12` | Joint screws: distance in from the machine cavity's front and back walls *Range 6 to 40, step 0.5.* |
| `attach_dowel_depth` | `10` | Dowels (rod_d rod, two): depth into each part *Range 5 to 13, step 0.5.* |
| `attach_dowel_press` | `0.1` | Dowel hole in the base: press fit (diameter under rod_d) *Range 0 to 0.5, step 0.05.* |
| `attach_dowel_slip` | `0.2` | Dowel hole in the bay: slip fit (diameter over rod_d) *Range 0 to 0.6, step 0.05.* |
| `attach_web` | `4` | Bay's top web between the joint and its lid rabbet *Range 2 to 10, step 0.5.* |

## Cord pass-through

| Parameter | Default | Description |
|---|----|---|
| `cord_hole_width` | `46` | Cord pass-through width (wide enough for both plugs' cords side by side) |
| `cord_hole_height` | `36` | Cord pass-through height (without gable) |
| `passthrough_knockouts` | `false` | Close both ends of the pass-through with knock-out walls (tap them out with a punch when you fit the outlet) |
| `passthrough_knockout_t` | `1.6` | Knock-out wall thickness *Range 0.8 to 3, step 0.1.* |
| `passthrough_score_depth` | `0.6` | Score groove around each knock-out wall's edge, on its tunnel side: depth (deeper = easier to knock out) *Range 0.2 to 1.5, step 0.1.* |
| `passthrough_score_w` | `0.8` | Score groove width *Range 0.4 to 2, step 0.1.* |
| `passthrough_cover` | `false` | Make a removable cover for the pass-through (part passthrough_cover), pushed into its compartment end |
| `passthrough_cover_depth` | `6` | Cover: depth of the plug into the tunnel *Range 3 to 15, step 0.5.* |

## Outlet compartment

| Parameter | Default | Description |
|---|----|---|
| `outlet_size` | `[76, 40, 22]` | Outlet body, mm: [length, width, thickness]. Modern: 76 x 40 x 22; early Bakelite: 83 x 45 x 22 |
| `outlet_receptacle_spacing` | `34` | Receptacle spacing, center to center (modern 34, Bakelite 38) *Range 20 to 60, step 0.5.* |
| `outlet_clearance` | `1.5` | Clearance around the outlet inside its curbs, per side |
| `outlet_y_offset` | `0` | Outlet center, front-to-back offset from the middle of the compartment *Range -50 to 50, step 0.5.* |
| `outlet_curb_h` | `3` | Height of the curbs on the floor around the outlet *Range 1 to 8, step 0.5.* |
| `outlet_curb_w` | `3` | Width of the curbs *Range 1 to 8, step 0.5.* |
| `outlet_mount` | `"through"` | How the outlet is held: a heat-set insert in the end wall (needs a soldering iron), or a flat-head screw through the end wall from outside, with a nut on the outlet's face *Choices: through, insert.* |
| `outlet_screw_spec` | `"#8-32"` | Screw through the outlet's center hole (drill out the membrane) |
| `outlet_screw_hole_d` | `4.6` | Through mount: clearance hole for the screw |
| `outlet_screw_head_d` | `8.4` | Through mount: flat-head diameter (#8: 8.4) |
| `outlet_screw_cap` | `true` | Through mount: recess the head under a printed cap (part outlet_cap) |
| `outlet_cap_d` | `12` | Through mount: cap diameter *Range 9 to 20, step 0.5.* |
| `outlet_cap_t` | `2` | Through mount: cap thickness *Range 1 to 4, step 0.1.* |
| `outlet_insert_d` | `5.6` | Hole for the heat-set insert in the right end wall (use the insert maker's recommended diameter) |
| `outlet_insert_depth` | `12` | Depth of the insert hole into the wall *Range 4 to 20, step 0.5.* |
| `outlet_labels` | `true` | Recess the receptacle names into the floor in front of the outlet |
| `outlet_light_side` | `"back"` | Receptacle wired always on (the light); the other is the controlled motor output *Choices: back, front.* |
| `outlet_light_label` | `"LIGHT"` | Name for the always-on receptacle |
| `outlet_motor_label` | `"MOTOR"` | Name for the controlled receptacle |
| `outlet_label_size` | `7` | Letter height *Range 3 to 12, step 0.5.* |
| `outlet_label_depth` | `0.6` | Recess depth *Range 0.2 to 2, step 0.1.* |
| `outlet_lid_hinge` | `"left"` | Edge the outlet-compartment lid hinges on *Choices: left, right, front, back.* |
| `outlet_slot_1_side` | `"front"` | Cord slot 1: lid edge it opens from *Choices: none, front, right, back.* |
| `outlet_slot_2_side` | `"back"` | Cord slot 2: lid edge it opens from *Choices: none, front, right, back.* |
| `outlet_slot_1_pos` | `0` | Slot 1 position along its edge, mm from the lid's left end (front/back edges) or front end (right edge); 0 = automatic |
| `outlet_slot_2_pos` | `0` | Slot 2 position along its edge; 0 = automatic |
| `outlet_slot_w` | `9` | Cord slot width *Range 4 to 20, step 0.5.* |
| `outlet_slot_depth` | `25` | Cord slot depth in from the lid edge |
| `outlet_slot_chamfer` | `1.5` | Chamfer on the slot's top edges, easing a cord pulled over them |
| `outlet_cord_exit` | `"lid"` | Where the outlet's two cords leave the compartment: through the lid's slots (lid); through slots in the walls, the power cord (from the outlet's back end) out the back and the controller cord (from its front end) out the front (front_rear); or both out the back, the controller cord running back in a channel in the floor (rear). The wall slots take trims (part outlet_trims) that leave an eased opening for the cord *Choices: lid, front_rear, rear.* |
| `outlet_cord_z` | `0` | Where the cords leave the outlet's ends: height above the floor (0 = half the outlet's height), and the cord's centre from the outlet's back, against the end wall (0 = 4.7: a cordset outlet's cords leave its ends at the center, 1/8" up from its back) *Range 0 to 60, step 0.5.* |
| `outlet_cord_x` | `0` |  *Range 0 to 40, step 0.1.* |
| `outlet_wall_slot_w` | `9` | Wall slots: width, and the opening left under the trim for the cord *Range 5 to 16, step 0.5.* |
| `outlet_cord_gap` | `7` |  *Range 4 to 14, step 0.5.* |
| `outlet_channel_w` | `3.8` | Floor channel for the controller cord (rear): width and depth, for two-wire lamp cord standing on edge (about 3 x 6 mm) *Range 2.5 to 8, step 0.1.* |
| `outlet_channel_depth` | `7` |  *Range 4 to 10, step 0.5.* |
| `outlet_clip` | `0.7` | Retention lips along the channel, alternate sides: overhang, and spacing along the path *Range 0.3 to 1.5, step 0.1.* |
| `outlet_clip_pitch` | `25` |  *Range 10 to 60, step 1.* |

## Knee controller

| Parameter | Default | Description |
|---|----|---|
| `knee_push` | `"right"` | The knee controller (compartment_option = "knee"): a knee bar turns a shaft running front to back in the right bay. A crank on the bar's hub, outside the front face, pushes a compression spring in a housing beside it; steel screws in the housing set the rest and the hard stop, so the knee's force stays out of the shaft and gears. Inside, two gear stages turn a pot standing in for the donor board's slide pot, and a cam on the sector works a switch that cuts the motor for the first part of the travel. See the User's Guide before building: the board is live at mains voltage. Which way the knee pushes the bar *Choices: right, left.* |
| `knee_bar_drop` | `317.5` | Bar: drop from the shaft to where the knee meets it (12.5" = 317.5 mm) *Range 150 to 450, step 0.5.* |
| `knee_travel_on` | `25.4` | Knee travel at that point where the switch closes and the motor starts; the travel before it is dead (1" = 25.4 mm) *Range 0 to 60, step 0.5.* |
| `knee_travel` | `50.8` | Knee travel at that point for full speed (2" = 50.8 mm) *Range 20 to 100, step 0.5.* |
| `knee_travel_max` | `57.15` | Knee travel at the hard stop (2.25" = 57.15 mm) *Range 20 to 120, step 0.5.* |
| `knee_force_rest` | `4.45` | Knee force at rest (the spring's preload), N (1 lb = 4.45 N) *Range 0.5 to 20, step 0.05.* |
| `knee_force_rate` | `0.263` | Knee force rise, N per mm of knee travel (1.5 lb/in = 0.263) *Range 0.05 to 1, step 0.001.* |
| `knee_bar_square` | `9.525` | Bar's square end (3/8" = 9.525 mm) *Range 5 to 16, step 0.025.* |
| `knee_bar_clearance` | `0.15` | Clearance on the bar's square end, per side *Range 0 to 0.5, step 0.05.* |
| `knee_shaft_d` | `8` | Shaft diameter *Range 6 to 12, step 0.5.* |
| `knee_shaft_x` | `17` | Shaft axis: distance from the divider *Range 10 to 40, step 0.5.* |
| `knee_shaft_z` | `0` | Shaft axis: height above the bay floor; 0 = middle of the bay *Range 0 to 60, step 0.5.* |
| `knee_bushing` | `[8, 12, 10]` | Flanged bushings (2, front wall and bulkhead): [bore, outside diameter, length] |
| `knee_bushing_flange` | `[16, 2]` | Bushing flange: [diameter, thickness] |
| `knee_bushing_hole` | `12.1` | Hole for a bushing's sleeve (press fit; FDM holes print a little small) *Range 8 to 20, step 0.05.* |
| `knee_bulkhead_pos` | `36` | Bulkhead (carries the rear bushing, the idler pin, the pot and the switch): distance behind the front wall's inside face *Range 25 to 80, step 0.5.* |
| `knee_bulkhead_t` | `3` | Bulkhead thickness where the pot mounts (the pot's bushing must reach through it and take the nut) *Range 2 to 5, step 0.1.* |
| `knee_bulkhead_above` | `15` | Bulkhead height above the shaft axis *Range 5 to 30, step 0.5.* |
| `knee_gear_module` | `1` | Gears: module (mm per tooth) *Range 0.5 to 2, step 0.05.* |
| `knee_pinion_teeth` | `16` | First stage: idler pinion teeth (driven by the sector on the knee shaft) *Range 12 to 30, step 1.* |
| `knee_ratio` | `4` | First stage ratio, sector to idler pinion (the sector is cut from a gear with ratio x pinion teeth) *Range 2 to 8, step 1.* |
| `knee_gear2_teeth` | `47` | Second stage: idler gear teeth (a sector on the idler, driving the pot's pinion) *Range 20 to 80, step 1.* |
| `knee_pinion2_teeth` | `16` | Second stage: pot pinion teeth *Range 12 to 30, step 1.* |
| `knee_gear_face` | `5` | Gear face width *Range 3 to 10, step 0.5.* |
| `knee_gear_backlash` | `0.15` | Tooth thinning per gear for backlash, at the pitch circle *Range 0 to 0.5, step 0.05.* |
| `knee_gear_cd_extra` | `0.1` | Extra center distance between the gears *Range 0 to 0.5, step 0.05.* |
| `knee_idler_angle` | `10` | Direction from the shaft to the idler, degrees (0 = straight right, negative = down) *Range -60 to 60, step 1.* |
| `knee_pot_angle` | `-120` | Direction from the idler to the pot, degrees (-90 = straight down) *Range -180 to 0, step 1.* |
| `knee_pot_body` | `15.88` | Pot (Bourns 91, 5/8" square): body size *Range 10 to 25, step 0.01.* |
| `knee_pot_depth` | `22` | Pot body depth behind the panel, with room for the pins and wires *Range 10 to 40, step 0.5.* |
| `knee_pot_hole` | `9.9` | Pot bushing (3/8-32 UNEF): panel hole *Range 6 to 14, step 0.05.* |
| `knee_pot_bushing_len` | `9.53` | Pot bushing length *Range 5 to 15, step 0.01.* |
| `knee_pot_shaft_d` | `6.35` | Pot shaft diameter (1/4") *Range 3 to 8, step 0.05.* |
| `knee_pot_shaft_len` | `22.23` | Pot shaft length from the mounting face (B28: 7/8") *Range 12 to 30, step 0.01.* |
| `knee_pot_lug_r` | `7.75` | Pot anti-rotation lug: radius from the shaft (0.305") *Range 5 to 12, step 0.05.* |
| `knee_pot_lug_angle` | `90` | Pot anti-rotation lug: direction from the shaft, degrees (90 = up); turn the pot to suit *Range -180 to 180, step 1.* |
| `knee_pot_lug_hole` | `2.6` | Pot anti-rotation lug: hole diameter *Range 1.5 to 4, step 0.1.* |
| `knee_pot_r` | `1000` | Pot: total resistance, kOhm *Range 10 to 5000, step 10.* |
| `knee_pot_travel` | `240` | Pot: electrical travel, degrees *Range 180 to 300, step 1.* |
| `knee_pot_mech` | `300` | Pot: mechanical rotation, degrees (the end zones beyond the electrical travel take the overtravel to the stop) *Range 180 to 330, step 1.* |
| `knee_r_span` | `220` | Resistance span the board wants over the speed range (knee_travel_on to knee_travel), kOhm; a linear placeholder until the board is measured *Range 10 to 2000, step 5.* |
| `knee_switch_body` | `[19.8, 10.2, 6.4]` | Off switch (Omron SS-5GL), lying under the shaft, lever up: body [length, height, thickness] |
| `knee_switch_holes` | `[9.5, 2.9]` | Switch mounting holes: pitch, and height above the bottom (terminal) edge |
| `knee_switch_op` | `8.8` | Switch operating position, from the mounting-hole line (8.8 +/- 0.8) *Range 5 to 15, step 0.1.* |
| `knee_switch_md` | `0.8` | Switch movement differential (release beyond the operating position) *Range 0.1 to 2, step 0.05.* |
| `knee_switch_press` | `0.3` | How far past the operating position the cam holds the lever at rest *Range 0 to 1.5, step 0.05.* |
| `knee_switch_act` | `5.3` | Actuating point: distance from the lever's free end (Omron's drawing: 14.5 mm from the lever's pivot end, so 5.3 from its free end) *Range 0 to 19, step 0.1.* |
| `knee_switch_floor` | `5` | Switch body's bottom (terminal) edge above the bay floor, with room for the terminals and wires *Range 2 to 15, step 0.5.* |
| `knee_switch_adjust` | `1.5` | Adjusting slots for the switch: travel up and down *Range 0 to 4, step 0.1.* |
| `knee_switch_screw` | `2.4` | Switch screw clearance (M2 or #2-56) *Range 1.8 to 3, step 0.05.* |
| `knee_spring` | `[15.24, 1.83, 31.75]` | Return spring (compression, standing in the housing beside the hub): [outside diameter, wire diameter, free length] (McMaster 9001T46: 0.6" OD, 0.072" wire, 1.25" long) |
| `knee_spring_rate` | `7.88` | Return spring: rate, N per mm (9001T46: 45 lb/in = 7.88) *Range 1 to 50, step 0.01.* |
| `knee_spring_max` | `14.78` | Return spring: its maximum deflection, mm (9001T46: 26 lb at 0.668" long, 14.8 mm down) *Range 3 to 40, step 0.01.* |
| `knee_crank_r` | `0` | Crank radius, shaft to the crank pin; 0 = set from the spring rate to give knee_force_rate *Range 0 to 90, step 0.5.* |
| `knee_board` | `[75, 35]` | Board (75 x 35 mm donor board): [length, width] |
| `knee_board_screw` | `[49.6, 12.5]` | Board screw: [along from the board's notched end, across from the long edge nearer the screw]; the peg and rest post follow from it |
| `knee_board_turn` | `180` | Board orientation: 180 = notched end toward the back of the bay, spade tabs on the right; 0 = notched end forward, tabs on the left *Choices: 0, 180.* |
| `knee_board_tabs` | `[58, 70]` | Spade tabs, on the long edge away from the screw: positions along from the notched end |
| `knee_board_tab_room` | `16` | Room beside the board for the spade connectors and their wires *Range 8 to 30, step 0.5.* |
| `knee_board_mirror` | `false` | Mirror the board's posts across the board (for a board laid out the other way round) |
| `knee_board_h` | `8` | Board underside above the floor *Range 4 to 20, step 0.5.* |
| `knee_board_parts_h` | `13.6` | Tallest part above the board underside *Range 5 to 40, step 0.1.* |
| `knee_insert_d` | `4.6` | Heat-set insert hole, M3 *Range 3 to 6, step 0.05.* |
| `knee_power` | `"cordset"` | How the controller is wired in: cordset = the standard pedal cordset's molded entry and clip (the control loop out to the cordset's junction); iec = fused IEC C14 inlet, with the motor and light wired at a junction under the bed; bare = a bare cord through a slot, held by a printed clamp *Choices: cordset, iec, bare.* |
| `knee_motor_amps` | `1.0` | Motor current (for the triac heating note and the cover vents) *Range 0.2 to 3, step 0.1.* |
| `knee_earth` | `true` | Earth contact for the shaft: a post behind the shaft's end for a spring strip and the earth lead (iec) |
| `knee_entry_hole` | `[13.9, 8.5]` | Cordset entry: hole [width, height] (long side horizontal) |
| `knee_entry_wall` | `4.4` | Cordset entry: wall thickness at the hole *Range 3 to 6, step 0.05.* |
| `knee_entry_dimple` | `[3.4, 2.4, 2.8]` | Cordset entry: dimple for the clip's bump, at the top of the hole [width, height, depth from the inside] |
| `knee_entry_clip` | `[21.4, 9.5]` | Cordset entry: steel clip [width, height] |
| `knee_entry_z` | `20` | Cordset entry: hole center above the bay floor (its pocket must clear the right handhold's ceiling) *Range 6 to 45, step 0.5.* |
| `knee_entry_pos` | `0` | Cordset entry or IEC inlet: position from the bay's back wall; 0 = beside the board's spade tabs *Range 0 to 140, step 0.5.* |
| `knee_entry_lead` | `78` | Cordset: lead length inside, from the molded face to the connector tips *Range 30 to 200, step 1.* |
| `knee_iec_cutout` | `[52.5, 27.5]` | IEC inlet (Schurter KE snap-in, mounted on its side): panel cutout [along the wall, height] |
| `knee_iec_radius` | `3` | IEC inlet: cutout corner radius *Range 0 to 5, step 0.5.* |
| `knee_iec_panel` | `2` | IEC inlet: panel thickness (KE: 1.5, 2 or 2.5 mm versions) *Range 1.5 to 2.5, step 0.5.* |
| `knee_iec_depth` | `40` | IEC inlet: depth behind the panel, with its connectors (check your inlet) *Range 20 to 70, step 0.5.* |
| `knee_wago` | `[18.8, 18.8, 8.6]` | Junction: Wago 221-413 lever connector [width, depth, height] |
| `knee_wago_n` | `3` | Junction: number of connectors (line, neutral, switched motor) *Range 1 to 6, step 1.* |
| `knee_cord` | `[7.5, 4.5]` | Bare cord: [width, thickness] (flat SPT-2 about 7.5 x 4.5) |
| `knee_cord_pos` | `14` | Bare cord: position along the right end wall, from the bay's back wall *Range 8 to 120, step 0.5.* |
| `knee_view` | `0` | Part knee_assembly: how far the knee is pushed, 0 (rest) to 1 (hard stop) *Range 0 to 1, step 0.05.* |

## Lollipop hinge

| Parameter | Default | Description |
|---|----|---|
| `hinge_flange_diameter` | `29` | Hinge flange diameter *Range 15 to 50, step 0.1.* |
| `hinge_flange_thickness` | `3` | Hinge flange thickness *Range 1 to 8, step 0.1.* |
| `hinge_thickness` | `8` | Hinge body depth below the top surface *Range 3 to 20, step 0.1.* |
| `hinge_inner_diameter` | `27` | Hinge body diameter *Range 10 to 50, step 0.1.* |
| `hinge_pin_thickness` | `8` | Hinge pin thickness (X) *Range 3 to 15, step 0.1.* |
| `hinge_pin_height` | `8` | Hinge pin height (Z) *Range 3 to 15, step 0.1.* |
| `hinge_pin_extension` | `25` | Hinge pin extension *Range 5 to 60, step 0.5.* |
| `hinge_pin_square_projection` | `10` | Hinge pin square projection *Range 2 to 30, step 0.5.* |
| `hinge_pin_allowed_projection` | `2` | Hinge pin allowed square projection into the bed seat *Range 0 to 6, step 0.1.* |
| `hinge_pin_internal_length` | `15` | Hinge pin internal length *Range 5 to 40, step 0.5.* |
| `hinge_pin_sweep_depth` | `1` | Extra depth below the pin for its corner to sweep through *Range 0 to 4, step 0.1.* |
| `hinge_mounting_hole_diameter` | `5` | Hinge mounting hole diameter *Range 2 to 10, step 0.1.* |
| `hinge_mounting_hole_offset` | `9.5` | Mounting hole center, inward from the flange's back edge |

## Printed hinge

| Parameter | Default | Description |
|---|----|---|
| `ph_pin_d` | `0` | Steel pin into the bed's hinge hole: diameter, just under the hole's; 0 = from the machine profile (9/32" for the 99K, 6 mm for the Kenmore 158-14001) *Range 0 to 12, step 0.01.* |
| `ph_pin_engage` | `0` | How far the pin enters the bed's hole; 0 = from the machine profile. Ignored when ph_pin_len is set *Range 0 to 30, step 0.5.* |
| `ph_pin_len` | `0` | Stock length of the pins, for a bought dowel pin (0 = cut to the length the console gives): the pin goes into the bed's hole by whatever is left past the arm; the console gives the lengths that fit the hole's depth *Range 0 to 80, step 0.5.* |
| `ph_pivot_len` | `0` | Stock length of the pivot rods, for a bought dowel pin (0 = the block's width, set by ph_cheek): the block's cheeks are widened or narrowed to suit *Range 0 to 60, step 0.025.* |
| `ph_pin_embed` | `16` | Length of the pin pressed into the arm *Range 8 to 30, step 0.5.* |
| `ph_pivot_d` | `6.35` | Steel pivot rod, running along the back through the block and the arm: diameter *Range 3 to 12, step 0.01.* |
| `ph_press` | `0` | Pivot rod's press fit in the block: printed hole diameter minus rod diameter (try part printed_hinge_test) *Range -0.4 to 0.4, step 0.05.* |
| `ph_pin_press` | `0` | Pin's press fit in the arm: printed hole diameter minus pin diameter (try part printed_hinge_test) *Range -0.4 to 0.4, step 0.05.* |
| `ph_slip` | `0.3` | Running fit: the arm's pivot hole is this much larger than the rod *Range 0 to 1, step 0.05.* |
| `ph_wall` | `4` | Plastic around the rods in the arm *Range 2.5 to 8, step 0.5.* |
| `ph_arm_w` | `14` | Arm width (X) *Range 8 to 30, step 0.5.* |
| `ph_cheek` | `6` | Block cheeks either side of the arm (X) *Range 3 to 15, step 0.5.* |
| `ph_clear` | `0.4` | Clearance between the moving arm and the block *Range 0.2 to 1.5, step 0.05.* |
| `ph_web` | `4` | Base web left between the bed seat and the hinge recess *Range 2 to 10, step 0.5.* |
| `ph_head_d` | `9.5` | Screw head counterbore from under the base, for a pan or socket head (#8 pan: 8.2 mm) *Range 5 to 16, step 0.1.* |
| `ph_floor` | `3` | Block floor under the arm *Range 2 to 8, step 0.5.* |
| `ph_recess_clear` | `0.2` | Fit of the block in its recess, each side *Range 0 to 0.6, step 0.05.* |
| `ph_stop_angle` | `100` | Tilt-back stop: a tail on the arm, behind the pivot, comes to rest in the block at about this angle (0 = no stop, 45 to 110). 100 matches a Singer lollipop hinge's knuckle; the machine passes its balance point (about 55 degrees on a 99K) well before, and past about 75 degrees the base itself starts to tip up unless the machine is held or braced *Range 0 to 110, step 1.* |
| `ph_tail` | `12` | Tail length behind the pivot (longer: less force on the stop, deeper block) *Range 6 to 25, step 0.5.* |
| `ph_min_cover` | `2.5` | Least plastic over the rods where the arm and cheeks are cut down to the rim *Range 1.5 to 5, step 0.25.* |
| `ph_test_step` | `0.1` | Rod-fit test (part printed_hinge_test): the step between its five holes, around ph_pin_press and ph_press (0.05 for a finer second bar) *Range 0.02 to 0.2, step 0.01.* |

## Foot-locating rig

| Parameter | Default | Description |
|---|----|---|
| `rig_height` | `80` | Parts foot_rig_left and foot_rig_right: a thin box that fits round the bed, to stand the machine on paper and print its inked feet. Wall height *Range 30 to 150, step 1.* |
| `rig_wall` | `2.4` | Wall thickness *Range 1.2 to 5, step 0.2.* |
| `rig_rim` | `10` | Floor rim, inward from the wall (it lies under the bed's edge) *Range 5 to 25, step 0.5.* |
| `rig_floor` | `2` | Floor rim thickness *Range 1 to 5, step 0.2.* |
| `rig_lap` | `15` | Overlap of the splice tabs past the split, each way *Range 8 to 30, step 1.* |
| `rig_bolt_d` | `3.4` | Splice bolt holes (M3) *Range 2 to 5, step 0.1.* |
| `rig_screw_d` | `3.5` | Screw holes through the floor rim, to fix the rig to a board *Range 2 to 6, step 0.1.* |
| `rig_mark_in` | `5` | Marking holes in the floor rim, this far in from the bed's edges at each corner and at the split, for a pencil or awl *Range 3 to 9, step 0.5.* |
| `rig_mark_d` | `1.6` |  *Range 0.8 to 3, step 0.1.* |
| `rig_bar_in` | `100` | Floor bars across the rig, this far in from each end of the bed (mm), to keep each half square; set them where no foot can land (0 = none) *Range 0 to 250, step 1.* |
| `rig_bar_w` | `10` | Floor bar width, and the height of the stiffening rib along it *Range 5 to 20, step 0.5.* |
| `rig_bar_rib` | `5` |  *Range 0 to 15, step 0.5.* |
| `rig_crossbar` | `false` | A floor bar across the split as well (it covers the paper there) |
| `rig_tie` | `true` | Breakaway tie across each half's open end at the split, holding the walls while printing; snap it off at its thin necks before bolting the halves together |
| `rig_tie_w` | `6` |  *Range 3 to 12, step 0.5.* |
| `rig_ears` | `false` | Mouse ears: thin discs at each half's corners, to hold them down while printing; cut off after. Off by default: a slicer's own mouse-ear brim (Bambu Studio's brim type "Mouse ear") does the same without brims round the discs |
| `rig_ear_d` | `16` |  *Range 8 to 30, step 1.* |
| `rig_ear_h` | `0.4` |  *Range 0.2 to 1, step 0.1.* |

## Tilt prop

| Parameter | Default | Description |
|---|----|---|
| `tilt_prop_h` | `0` | Part tilt_prop: a stand on the table behind the base that catches the machine's arm when it is tipped back to about 90 degrees, for hands-free servicing. Height of the arm's underside above the table there, mm; 0 = from the machine profile (99K: 6") *Range 0 to 300, step 1.* |
| `tilt_prop_top` | `"profile"` | Top: from the profile, a cradle (for a round arm), or flat and level (for anything else) *Choices: profile, cradle, flat.* |
| `tilt_prop_r` | `0` | Cradle radius (the arm's radius plus a little), mm; 0 = from the profile (99K: 1") *Range 0 to 60, step 0.5.* |
| `tilt_prop_flat` | `50` | Flat top: depth front to back, mm *Range 20 to 120, step 1.* |
| `tilt_prop_w` | `38.1` | Cradle width, along the arm (1.5") *Range 20 to 80, step 0.5.* |
| `tilt_prop_foot` | `[80, 110]` | Foot: width along the arm, and depth front to back *Range 40 to 200, step 1.* |

## Barrel hinge

| Parameter | Default | Description |
|---|----|---|
| `barrel_d` | `15.2` | Barrel hinge (hinge_type = "barrel", from vintage portable cases): barrel diameter *Range 8 to 30, step 0.05.* |
| `barrel_h` | `17.5` | Barrel height (its top was flush with the case) *Range 8 to 40, step 0.05.* |
| `barrel_pin_z` | `11.8` | Arm's pin axis above the barrel's bottom, arm level *Range 3 to 30, step 0.05.* |
| `barrel_pivot_z` | `14.3` | Cross pin (the arm's pivot) above the barrel's bottom *Range 3 to 30, step 0.05.* |
| `barrel_pivot_dy` | `4.5` | Cross pin in front of the barrel's axis, toward the bed *Range 0 to 10, step 0.05.* |
| `barrel_reach` | `30` | Barrel axis to the pin's tip, arm level *Range 15 to 60, step 0.1.* |
| `barrel_block` | `[16.4, 9.3, 7.1]` | Arm's block: length (along the arm), height, width |
| `barrel_pin` | `[6.85, 18.8]` | Arm's pin: diameter, and length from the block to the tip |
| `barrel_tilt` | `65` | How far the arm tips back *Range 30 to 110, step 1.* |
| `barrel_clear` | `0.3` | Clearance round the barrel and the arm's swing *Range 0.1 to 1, step 0.05.* |
| `barrel_screw` | `[35.4, 4.78, 11, 7]` | Screw: length overall, head height, head diameter, thread diameter |
| `barrel_washer` | `[1.5, 13.7]` | Washer under the screw head: thickness and outside diameter |
| `barrel_tap_depth` | `6` | Depth of the barrel's tapped hole the screw may use *Range 3 to 12, step 0.5.* |

## Hinge coupon

| Parameter | Default | Description |
|---|----|---|
| `hinge_coupon_margin` | `12` | Solid margin around the hinge flange (room for the corner screws) |
| `hinge_coupon_floor` | `4` | Floor left under the deepest hinge cut *Range 2 to 10, step 0.5.* |
| `hinge_coupon_screw_d` | `4.6` | Corner holes for #8 flat-head wood screws: clearance hole |
| `hinge_coupon_head_d` | `8.4` | Corner holes: countersink diameter at the top face |

## Hinge nut traps

| Parameter | Default | Description |
|---|----|---|
| `hinge_nut_spec` | `"#8-32"` | Nut for the hinge screws (BOSL2 spec, e.g. "#8-32", "M4") |
| `hinge_nut_width` | `0` | Nut width across flats; 0 = from the spec *Range 0 to 20, step 0.05.* |
| `hinge_nut_depth` | `21` | Depth of the nut's upper face below the top surface *Range 8 to 60, step 0.5.* |
| `hinge_nut_bridge` | `0.2` | Sacrificial bridge over the nut trap (0 = none; drill through after printing) |
| `hinge_nut_tool_tip` | `3.0` | Nut tool (part hinge_nut_tool): tip diameter, to fit the nut's bore (a nylon-insert locknut's insert: 1/8") *Range 1.5 to 6, step 0.05.* |

## Mending plates

| Parameter | Default | Description |
|---|----|---|
| `plate_count` | `3` | Number of plates across the split (0 = none) |
| `plate_length` | `101.6` | Plate length (McMaster 1394A34: 4") |
| `plate_width` | `15.875` | Plate width (5/8") |
| `plate_thickness` | `1.778` | Plate thickness (0.070") |
| `plate_holes` | `[[-33.866, 2.375], [-11.289, -2.375], [11.289, 2.375], [33.866, -2.375]]` | Hole centers [along, across] from the plate center (0.889" pitch, staggered 0.094") *Edit in the file; not shown in the Customizer.* |
| `plate_hole_bridge` | `0.3` | Sacrificial layer over each screw hole at the pocket ceiling (0 = none); drill through |
| `plate_pocket_clearance` | `0.5` | Clearance around the plate in its pocket, per side |
| `plate_standoff` | `1.0` | How far the plate sits up inside its pocket, so screw heads stay off the table |
| `plate_screw_clearance` | `4.6` | Screw clearance hole diameter (#8) |
| `plate_nut_spec` | `"#8-32"` | Nut for the plate screws (BOSL2 spec) |
| `plate_nut_width` | `0` | Nut width across flats; 0 = from the spec *Range 0 to 20, step 0.05.* |
| `plate_nut_trap_depth` | `3.5` | Nut trap depth into the cavity floor |
| `plate_wall_margin` | `8` | Minimum distance from the cavity walls to the plate edge *Range 2 to 20, step 0.5.* |

## Nut fit

| Parameter | Default | Description |
|---|----|---|
| `nut_clearance` | `0.15` | Extra clearance added to nut width (applied to each side) |

## Casting reliefs

| Parameter | Default | Description |
|---|----|---|
| `relief_clearance` | `1` | Clearance below the casting in a relief (the reliefs themselves come from the machine profile) *Range 0 to 4, step 0.1.* |
| `relief_margin` | `2` | Extra length added at each end of a relief *Range 0 to 10, step 0.5.* |

## Back wall lightening

| Parameter | Default | Description |
|---|----|---|
| `lighten_back_wall` | `true` | Hollow the back wall between the hinges |
| `back_skin` | `17` | Back wall thickness left behind the tunnels *Range 6 to 40, step 0.5.* |
| `back_top_skin` | `6` | Solid material above the tunnel peaks *Range 2 to 20, step 0.5.* |
| `tunnel_width` | `30` | Target tunnel width |
| `tunnel_web` | `6` | Web between tunnels |
| `hinge_tunnel_margin` | `7.5` | Extra solid kept beyond each side of the hinge footprint |
| `split_keepout` | `15` | Solid zone kept on either side of the split, from the cut line |

## Split

| Parameter | Default | Description |
|---|----|---|
| `split_part` | `"both"` | Which part to render when split *Choices: both, left, right.* |
| `split_spread` | `30` | Separation between the two halves when both are shown |
| `split_balance` | `true` | Put the split where the two halves, the left one's dovetail keys included, come out the same length (else at the middle) |
| `split_clearance` | `0.1` | Clearance in the joint, per face |
| `key_neck` | `8` | Dovetail key width at the cut line (neck) *Range 4 to 16, step 0.5.* |
| `key_flare_angle` | `30` | Dovetail flare, per side, in degrees; steeper = less pull-apart play |
| `key_depth` | `8` | Dovetail key length, past the cut line into the right half *Range 4 to 16, step 0.5.* |
| `key_ys` | `[]` | Key positions in Y; empty = automatic (floor keys between plate rows, one centered in the back wall) *Edit in the file; not shown in the Customizer.* |
| `serrations` | `true` | Vertical V-serrations across the front wall's joint faces |
| `serration_pitch` | `3` | Serration pitch (ridge to ridge) *Range 2 to 6, step 0.1.* |
| `serration_height` | `1.5` | Serration height (ridge tip beyond the cut line); pitch / 2 gives a 90-degree V |
| `serration_setback` | `2.5` | Solid wall kept between the serrations and each face of the front wall (outer skin and cavity side) |
| `serration_top_gap` | `3` | Serrations stop this far below the bed ledge *Range 1 to 10, step 0.5.* |
| `serration_top_clear` | `0.5` | Extra clearance at the top of each groove, so the ridges never bottom out |

## Extensions

| Parameter | Default | Description |
|---|----|---|
| `back_ext` | `true` | Include the back extension (outfeed support / compartment) |
| `left_ext` | `true` | Include the left extension |
| `corner_ext` | `true` | Include the left-rear corner piece (needs both of the above) |
| `back_ext_length` | `240` | Back extension length (X), from the base's left face |
| `back_ext_depth` | `100` | Back extension body depth (Y), behind the base *Range 100 to 300, step 0.5.* |
| `left_ext_width` | `100` | Left extension body width (X), left of the base *Range 100 to 300, step 0.5.* |
| `left_ext_double` | `false` | Left extension and corner: make the width for an outer bin matching the inner one (overrides left_ext_width) |
| `back_ext_double` | `false` | Back extension and corner: make the depth for an outer bin matching the inner one (overrides back_ext_depth) |
| `left_ext_layout` | `"1+1"` | Left extension past 100 mm: its outer bin whole (1+1), or split in two along its length (1+2) *Choices: 1+1, 1+2.* |
| `back_ext_layout` | `"1+1"` | Back extension past 100 mm: its outer bin whole (1+1), or split in two along its length (1+2) *Choices: 1+1, 1+2.* |
| `corner_layout` | `"2x2"` | Corner piece past 100 mm: the bobbin bin stays in the inner corner, and the rest becomes open bins left of it and behind it; with both, the far corner gets its own bin (2x2), or the left or back bin runs the full length *Choices: 2x2, long left, long back.* |
| `ext_divider` | `2.5` | Divider wall between bins *Range 1.2 to 6, step 0.1.* |
| `ext_bin_min` | `10` | Least bin width inside; a narrower strip is left solid *Range 5 to 30, step 0.5.* |
| `back_lids` | `"one"` | Lids: one over each piece, or one per bay (on rabbets in the dividers' tops) *Choices: one, per bay.* |
| `left_lids` | `"one"` |  *Choices: one, per bay.* |
| `corner_lids` | `"one"` |  *Choices: one, per bay.* |
| `bin_lid_type` | `"lift-out"` | Per-bay lids on the outer bins: type (the inner bay's lid keeps its piece's settings) *Choices: lift-out, hinged, none.* |
| `bin_lid_hinge` | `"back"` | Per-bay lids on the outer bins: hinge edge *Choices: left, right, front, back.* |
| `bin_lid_min` | `15` | Least lid: a bin narrower than this inside gets no lid of its own *Range 10 to 40, step 1.* |
| `ext_divider_notch` | `true` | Finger notch at the middle of each divider, for reaching into narrow bins (one lid only) |
| `ext_notch_w` | `30` | Finger notch width and depth *Range 10 to 60, step 1.* |
| `ext_notch_d` | `20` |  *Range 5 to 60, step 1.* |
| `ext_gap` | `0.3` | Gap between an extension body and the base or another extension |
| `lip_clearance` | `0.2` | Clearance between the lip and the base top |
| `lip_min_t` | `5.4` | Least lip thickness: where the bed stands less than this above the rim (a bed set flush, say), the rim is cut down under the lips so they keep it, and trim strips (parts back_trim, left_trim) fill the cuts when the extensions are off *Range 3 to 10, step 0.1.* |
| `lip_cut_clearance` | `0.25` | Clearance around the recessed lips and the trims, per side *Range 0.1 to 0.6, step 0.05.* |
| `ext_top_adjust` | `0` | Trim to the extensions' top plane (lids, lips, trenches) against the real bed, mm; negative lowers it *Range -3 to 3, step 0.1.* |
| `ext_floor` | `3` | Extension floor thickness *Range 1.5 to 8, step 0.1.* |
| `ext_standard` | `true` | Standard extension height: every extension's top at ext_height above the table, with the same bays (the base is raised, or the extensions stand on podiums, to match the bed) |
| `ext_height` | `88.225` | Standard extension height: the 99K's bed top *Range 60 to 140, step 0.005.* |
| `podium_min` | `5` | Least podium under an extension, when the bed stands above ext_height *Range 3 to 20, step 0.5.* |
| `podium_wall` | `6` | Podium wall (it is a frame, open below) *Range 3 to 15, step 0.5.* |
| `ext_frame` | `4` | Frame width around each lid, at the top *Range 2 to 10, step 0.1.* |
| `ext_ledge` | `4` | Ledge the lid rests on, inside the frame *Range 2 to 10, step 0.1.* |
| `ext_lid_thickness` | `4` | Lid thickness (= depth of the lid rabbet) *Range 2 to 8, step 0.1.* |
| `ext_lid_clearance` | `0.3` | Clearance around the lid in its rabbet, per side |
| `ext_hinge_margin` | `0.5` | Hinged lids: the ledge on the hinge side is widened so the open lid stays this far clear of the bay |
| `ext_finger_hole` | `22` | Finger hole in each lid |
| `ext_rounding` | `3` | Rounding of the extensions' exposed edges *Range 0 to 8, step 0.5.* |

## Turn button

| Parameter | Default | Description |
|---|----|---|
| `turn_button` | `false` | Turn button on the front rim that holds the bed's front edge down (off by default) |
| `turn_button_x` | `0` | Position along the front rim (X); 0 = automatic, between the split and the compartment |
| `turn_button_overlap` | `4` | How far the button reaches over the bed's front edge *Range 1 to 10, step 0.5.* |
| `turn_button_w` | `9` | Button width *Range 6 to 16, step 0.5.* |
| `turn_button_t` | `4` | Button thickness *Range 2 to 8, step 0.5.* |
| `turn_button_gap` | `0.3` | Gap between the button and the bed top |
| `turn_button_ease` | `10` | Easing: how far the pad's smooth slopes run out along the rim, each side |
| `turn_button_swell` | `3` | How far the pad swells out of the front face, enclosing the nut *Range 0 to 8, step 0.5.* |
| `turn_button_swell_taper` | `10` | Below the nut, the swelling blends back into the front face over this height |
| `turn_button_nut_spec` | `"#8-32"` | Nut for the button screw (BOSL2 spec) |

## Freestanding boxes

| Parameter | Default | Description |
|---|----|---|
| `make_back_box` | `false` | Also make a freestanding version of the back extension (part back_box): same bay and lid, no lip, pegs or dovetails |
| `make_left_box` | `false` | Also make a freestanding left box (part left_box) |
| `make_corner_box` | `false` | Also make a freestanding corner box (part corner_box) |

## Extension pegs

| Parameter | Default | Description |
|---|----|---|
| `ext_peg_holes` | `true` | Holes in the base rim for the extension pegs |
| `ext_peg_style` | `"insert"` | Pegs: insert (separate printed pegs, part ext_pegs, printed lying down), pin (cut from rod_d rod), or molded into the lip (as before v20) *Choices: insert, pin, molded.* |
| `peg_d` | `4` | Peg diameter (printed pegs) *Range 3 to 8, step 0.1.* |
| `peg_len` | `3` | Peg length below the lip *Range 1.5 to 6, step 0.1.* |
| `peg_hole_d` | `4.4` | Hole diameter in the base (for printed pegs; pins use rod_d + 0.2) |
| `peg_lip_clearance` | `0.2` | Peg hole in the lip, over the peg diameter (the peg's crush ribs make the press fit) |
| `pin_lip_interference` | `0.1` | Metal pins: press fit in the lip, hole under the rod diameter |
| `peg_hole_depth` | `3.5` | Hole depth in the base |
| `back_peg_xs` | `[16, 160]` | Back-rim peg positions (X), from the base's left face: standard for every machine, so back extensions fit any base of their class; keep clear of the hinges and the split |
| `left_peg_ys` | `[35, 150]` | Left-rim peg positions (Y) |
| `right_peg_ys` | `[35, 150]` | Right-rim peg positions (Y), for future right-side extensions; [] for none |

## Corner dovetails

| Parameter | Default | Description |
|---|----|---|
| `ext_dt_neck` | `6` | Dovetail width at the mating face *Range 3 to 12, step 0.5.* |
| `ext_dt_head` | `9` | Dovetail width at its head *Range 4 to 16, step 0.5.* |
| `ext_dt_depth` | `4` | Dovetail depth into the mating wall *Range 2 to 10, step 0.5.* |
| `ext_dt_clearance` | `0.2` | Dovetail clearance per face |

## Handholds

| Parameter | Default | Description |
|---|----|---|
| `handholds` | `true` | Handholds under each end |
| `handhold_bottom_len` | `76.2` | Handhold length along the end, at the bottom face (3") |
| `handhold_top_len` | `50.8` | Handhold length at its top (2") |
| `handhold_height` | `12.7` | Handhold height above the bottom face (1/2") |
| `handhold_depth` | `15.875` | Handhold depth into the end wall (5/8") |
| `handhold_lip_flat` | `4` | Flat underside of the lip at the face, before the ceiling climbs *Range 0 to 10, step 0.5.* |
| `handhold_lip_round` | `2` | Radius rounding the lip's outer edge *Range 0 to 6, step 0.5.* |
| `handhold_knockout` | `true` | Knock-out wall under the lip, removed after printing |
| `knockout_t` | `1.2` | Knock-out wall thickness |
| `knockout_gap` | `0.2` | Gap between the knock-out wall and the lip |
| `knockout_tab` | `true` | Breakaway tab tying one end of the knock-out wall to the pocket end |
| `knockout_tab_h` | `0.8` | Tab height (the tab sits just under the lip gap) |
| `knockout_brim` | `true` | Brim around the foot of each knock-out wall, so it stands until the tab joins it |
| `knockout_brim_w` | `5` | Brim width each side of the wall |
| `knockout_brim_h` | `0.2` | Brim height (about one first layer) |

## Harness rods

| Parameter | Default | Description |
|---|----|---|
| `harness_rods` | `true` | Rod notches and rods either side of each handhold |
| `rod_d` | `4.7625` | Rod diameter (3/16") |
| `rod_hole_d` | `4.95` | Rod hole diameter (printed as a teardrop, point up) |
| `rod_x` | `7` | Rod center in from the end face *Range 3 to 15, step 0.1.* |
| `rod_z` | `7` | Rod center above the bottom face *Range 3 to 15, step 0.1.* |
| `notch_len` | `25` | Notch length along the rod |
| `notch_clear` | `4` | Clear space around the rod in the notch, behind and above it *Range 1 to 10, step 0.5.* |
| `notch_inset` | `25` | Distance from each outer face (front, back) to its notch |
| `rod_stop` | `5` | Material left between a rod's blind end and the handhold |
| `rod_plug_len` | `5` | Printed plug closing the open end of each rod hole (0 = no plugs; rods run to the face) *Range 0 to 10, step 0.5.* |
| `rod_plug_clearance` | `0.1` | Plug clearance in the hole, per side (the crush ribs make the press fit) |
| `rod_plug_rib` | `0.15` | Crush rib interference, beyond the hole wall |

## Left lip

| Parameter | Default | Description |
|---|----|---|
| `lip_edge_round` | `2` | Radius of the rounded top edge along the lip front (also the free edges of an extended back lip) *Range 0 to 5, step 0.5.* |
| `lip_fillet` | `5` | Radius of the inside corner where the lip front meets the body (also an extended back lip's corners) *Range 0 to 15, step 0.5.* |

## Back lip

| Parameter | Default | Description |
|---|----|---|
| `back_lip_extend` | `true` | Run the back lip on past a short back extension, over the base's back rim, to reach the last back peg hole |
| `back_lip_peg_margin` | `10` | How far the lip runs past the last peg's center *Range 6 to 30, step 0.5.* |

## Lid hinges

| Parameter | Default | Description |
|---|----|---|
| `base_lid_hinge` | `"right"` | Lid edge each lid hinges on *Choices: left, right, front, back.* |
| `back_lid_hinge` | `"back"` |  *Choices: left, right, front, back.* |
| `left_lid_hinge` | `"left"` |  *Choices: left, right, front, back.* |
| `corner_lid_hinge` | `"back"` |  *Choices: left, right, front, back.* |
| `base_lid_type` | `"hinged"` | Base compartment lid: hinged (snap-in dimple hinge), lift-out (plain lid resting on the ledge), or none (rabbet left for a lid later) *Choices: hinged, lift-out, none.* |
| `back_lid_type` | `"hinged"` | Back extension lid type *Choices: hinged, lift-out, none.* |
| `left_lid_type` | `"hinged"` | Left extension lid type *Choices: hinged, lift-out, none.* |
| `corner_lid_type` | `"hinged"` | Corner piece lid type *Choices: hinged, lift-out, none.* |
| `base_lid_style` | `"solid"` | Base compartment lid style: solid, or perforated for ventilation *Choices: solid, perforated.* |
| `back_lid_style` | `"solid"` | Back extension lid style *Choices: solid, perforated.* |
| `left_lid_style` | `"solid"` | Left extension lid style *Choices: solid, perforated.* |
| `corner_lid_style` | `"solid"` | Corner piece lid style *Choices: solid, perforated.* |
| `base_lid_grip` | `"finger hole"` | Base compartment lid grip: finger hole, or a thumb tab reaching over a notch in the wall *Choices: finger hole, tab.* |
| `base_lid_tab_edge` | `"front"` | Base lid tab edge (front only is practical, on a lift-out lid) *Choices: front, back, left, right.* |
| `back_lid_grip` | `"finger hole"` | Back extension lid grip *Choices: finger hole, tab.* |
| `back_lid_tab_edge` | `"right"` | Back lid tab edge (back or right) *Choices: front, back, left, right.* |
| `left_lid_grip` | `"finger hole"` | Left extension lid grip *Choices: finger hole, tab.* |
| `left_lid_tab_edge` | `"front"` | Left lid tab edge (front or left) *Choices: front, back, left, right.* |
| `corner_lid_grip` | `"finger hole"` | Corner piece lid grip *Choices: finger hole, tab.* |
| `corner_lid_tab_edge` | `"left"` | Corner lid tab edge (left or back) *Choices: front, back, left, right.* |
| `grip_tab_w` | `25` | Thumb tab width |
| `grip_tab_over` | `1.5` | Thumb tab overhang past the outer face |
| `grip_tab_r` | `2` | Thumb tab corner radius *Range 0 to 5, step 0.5.* |
| `grip_scoop_d` | `2.5` | Thumb scoop below the tab: depth into the outer face |
| `grip_scoop_h` | `6` | Thumb scoop height below the lid *Range 2 to 12, step 0.5.* |
| `base_lid_notch_r` | `4` | Base lid motor-boss notch (size from the machine profile): inner corner radius *Range 0 to 10, step 0.5.* |
| `base_lid_notch_flare` | `10` | Notch: radius blending it into the lid edge |
| `base_lid_notch_offset` | `0` | Notch: front-to-back offset from the middle of the lid *Range -50 to 50, step 0.5.* |
| `lid_perf_d` | `5` | Perforation hole diameter *Range 2 to 12, step 0.5.* |
| `lid_perf_pitch` | `8` | Perforation pitch (hex grid) *Range 4 to 20, step 0.5.* |
| `lid_perf_margin` | `6` | Solid margin kept around the lid's edges, finger hole and hinge *Range 2 to 20, step 0.5.* |
| `lid_bump_d` | `3` | Hinge bump diameter at its base *Range 1.5 to 6, step 0.1.* |
| `lid_bump_engage` | `1.0` | How far each bump engages the wall |
| `lid_tab_len` | `15` | Flex tab carrying each bump: length along the end |
| `lid_tab_w` | `4` | Flex tab width *Range 1.5 to 8, step 0.1.* |
| `lid_slot_w` | `1` | Slot that frees the flex tab *Range 0.5 to 3, step 0.1.* |
| `lid_bump_angle` | `35` | Bump flank angle from its axis: smaller is steeper and holds better (45 = the v19 cone) *Range 15 to 60, step 1.* |
| `lid_hinge_end_clearance` | `0.15` | Clearance at the lid's two hinge ends (less end float keeps both bumps engaged) |
| `lid_recess_clearance` | `0.075` | Clearance between bump and recess, per side |
| `lid_open_stop` | `true` | Cut a chamfer behind the hinge so an open lid leans back and stays up |

## Inserts

| Parameter | Default | Description |
|---|----|---|
| `ins_spacing` | `10` | Spacing between parts in the insert print layouts *Range 0 to 50, step 1.* |
| `bobbin_d` | `20.6375` | Bobbin diameter (class 15 and 66: 13/16"), for the bobbin trays and the spool tray |
| `bobbin_t` | `11.1125` | Bobbin thickness (class 15 and 66: 7/16") |

## Bobbin trays (corner bay)

| Parameter | Default | Description |
|---|----|---|
| `bb_trays` | `0` | Number of trays, bottom included; 0 = as many as fit under the lid *Range 0 to 10, step 1.* |
| `bb_post_d` | `5` | Post diameter (class 15 and 66 bores are a little over 6 mm) *Range 3 to 10, step 0.1.* |
| `bb_grid` | `[3, 3]` | Post grid [columns (X), rows (Y)]; cells that would crowd the center column are left empty |
| `bb_floor` | `3` | Tray floor thickness *Range 1.2 to 6, step 0.1.* |
| `bb_bobbin_clear` | `1` | Clearance between a bobbin's top and the tray above *Range 0 to 4, step 0.1.* |
| `bb_wall_clear` | `0.75` | Clearance between the trays and the bay walls, per side *Range 0.2 to 3, step 0.05.* |
| `bb_corner_r` | `2` | Tray corner radius *Range 0 to 10, step 0.5.* |
| `bb_top_clear` | `1` | Clearance between the top of the knob and the lid *Range 0 to 5, step 0.1.* |
| `bb_lighten` | `true` | Lightening holes where four cells meet |
| `bb_lighten_d` | `12` | Lightening hole diameter *Range 4 to 20, step 0.5.* |
| `bb_pin_d` | `3` | Pin on each post tip: diameter *Range 1.5 to 6, step 0.1.* |
| `bb_pin_h` | `2` | Pin height above the post shoulder *Range 0.5 to 5, step 0.1.* |
| `bb_socket_clear` | `0.2` | Socket clearance around the pin, per side *Range 0 to 1, step 0.05.* |
| `bb_socket_extra` | `0.4` | Socket depth beyond the pin *Range 0 to 2, step 0.1.* |
| `bb_socket_chamfer` | `0.6` | Chamfer at the socket mouth (also absorbs elephant's foot) *Range 0 to 2, step 0.1.* |
| `bb_column_d` | `12` | Handle column diameter *Range 6 to 20, step 0.5.* |
| `bb_column_flare` | `2` | Flare radius at the column's foot *Range 0 to 5, step 0.5.* |
| `bb_knob_d` | `18` | Knob diameter *Range 8 to 30, step 0.5.* |
| `bb_knob_h` | `8` | Knob height *Range 3 to 20, step 0.5.* |
| `bb_hole_clear` | `0.5` | Clearance between the knob and the upper trays' center holes, per side *Range 0.1 to 2, step 0.05.* |

## Notion trays (back or left bay)

| Parameter | Default | Description |
|---|----|---|
| `ot_bay` | `"back"` | Bay the notion and spool trays go in *Choices: back, left.* |
| `ot_custom_h` | `12` | Custom tray height *Range 5 to 80, step 0.5.* |
| `ot_show` | `[25, 20, 15, 10]` | Tray heights shown stacked in part notion_assembly |
| `ot_wall_clear` | `1` | Clearance between the trays and the bay walls, per side *Range 0.2 to 3, step 0.05.* |
| `ot_wall` | `1.2` | Wall thickness *Range 0.8 to 4, step 0.1.* |
| `ot_floor` | `1.6` | Floor thickness *Range 0.8 to 4, step 0.1.* |
| `ot_corner_r` | `2` | Outer corner radius *Range 0 to 10, step 0.5.* |
| `ot_boss` | `9` | Corner boss size (square, from the outer corner) *Range 5 to 20, step 0.5.* |
| `ot_pin_d` | `3` | Pin diameter *Range 1.5 to 6, step 0.1.* |
| `ot_pin_h` | `2` | Pin height above the wall tops *Range 0.5 to 5, step 0.1.* |
| `ot_socket_clear` | `0.2` | Socket clearance around the pin, per side *Range 0 to 1, step 0.05.* |
| `ot_socket_extra` | `0.4` | Socket depth beyond the pin *Range 0 to 2, step 0.1.* |
| `ot_socket_chamfer` | `0.5` | Chamfer at the socket mouth (also absorbs elephant's foot) *Range 0 to 2, step 0.1.* |
| `ot_grip_w` | `40` | Finger-hold lip length along each end wall *Range 10 to 120, step 1.* |
| `ot_grip_reach` | `5` | How far the lip reaches in from the wall *Range 0 to 15, step 0.5.* |
| `ot_grip_t` | `1.5` | Thickness of the lip at its top, above the 45-degree underside *Range 0.8 to 4, step 0.1.* |
| `ot_top_clear` | `1` | Clearance between the top tray's pins and the lid *Range 0 to 5, step 0.1.* |

## Notion tray compartments

| Parameter | Default | Description |
|---|----|---|
| `ot_compartments` | `false` | Divide the plain notion trays (not the spool tray) into compartments |
| `ot_cell` | `50.8` | Target compartment size; the grid divides the tray evenly to come closest to it (2" gives 2 x 4 in the back or left bay; 1" gives 3 x 8) *Range 10 to 100, step 0.1.* |
| `ot_cols` | `0` | Compartments along the tray's length (0 = from ot_cell) *Range 0 to 20, step 1.* |
| `ot_rows` | `0` | Compartments across the tray's width (0 = from ot_cell) *Range 0 to 20, step 1.* |
| `ot_divider_frac` | `0.8` | Divider height, as a fraction of the tray height *Range 0.2 to 1, step 0.05.* |
| `ot_divider_t` | `1.2` | Divider thickness *Range 0.8 to 4, step 0.1.* |

## Spool tray

| Parameter | Default | Description |
|---|----|---|
| `ot_spool_d` | `38` | Spool diameter *Range 20 to 80, step 0.5.* |
| `ot_spool_h` | `44` | Spool height *Range 20 to 100, step 0.5.* |
| `ot_spool_post_d` | `5` | Post diameter at the top, through the bobbin *Range 3 to 15, step 0.1.* |
| `ot_spool_post_base_d` | `7` | Post diameter at the floor; the post tapers to the top diameter at the spool top *Range 3 to 20, step 0.1.* |
| `ot_spool_bore` | `7.5` | Smallest spool bore you expect (for the console check) *Range 3 to 20, step 0.1.* |
| `ot_spool_gap` | `1.5` | Space between neighboring spools *Range 0 to 10, step 0.1.* |
| `ot_spool_wall_gap` | `0.5` | Space between the spools and the tray walls and corner bosses *Range 0 to 5, step 0.1.* |
| `ot_spool_top_clear` | `1` | Clearance between the bobbin tops and the tray above *Range 0 to 5, step 0.1.* |
| `ot_spool_open_sides` | `true` | Cut the long side walls down to a curb between the corner bosses, so the spools can be grasped from the side |
| `ot_spool_curb` | `14` | Curb height left along the long sides (it stiffens the floor when the tray is lifted by its ends) *Range 3 to 40, step 0.5.* |
| `ot_spool_cut_r` | `5` | Radius at the bottom corners of the cutaway *Range 0 to 20, step 0.5.* |

## Tray gussets

| Parameter | Default | Description |
|---|----|---|
| `ot_gussets` | `true` | Small triangular ribs at the foot of the trays' long walls, where a thin wall meets the floor at one layer line |
| `ot_gusset_t` | `1` | Gusset thickness (on the spool tray it must fit between neighboring spools) *Range 0.6 to 3, step 0.1.* |
| `ot_gusset_d` | `5` | Gusset reach along the floor, from the wall *Range 1 to 15, step 0.5.* |
| `ot_gusset_h` | `8` | Gusset height up the wall (less on low trays) *Range 1 to 20, step 0.5.* |
| `ot_gusset_pitch` | `40` | Spacing to aim for between gussets on plain trays *Range 15 to 120, step 1.* |

## Ruler and logos (front, back and bottom)

| Parameter | Default | Description |
|---|----|---|
| `ruler` | `false` | A ruler across the base's front face, from where the left corner's round-over ends to where the right one's begins (on the base and a built-in compartment; not on an attached bay or the extensions) |
| `ruler_scale_1` | `"inch"` | Scales, from the bottom up: inch, centimeter, custom, or none *Choices: inch, cm, custom, none.* |
| `ruler_scale_2` | `"cm"` |  *Choices: inch, cm, custom, none.* |
| `ruler_scale_3` | `"none"` |  *Choices: inch, cm, custom, none.* |
| `ruler_bottom` | `5` | The ruler's bottom edge above the bottom of the base *Range 0 to 40, step 0.5.* |
| `ruler_scale_h` | `8` | Height of each scale *Range 5 to 15, step 0.5.* |
| `ruler_inch_div` | `8` | Inch scale: divisions per inch, and a longer tick every so many (8 and 2: eighths, longer at the quarters; 10 and 5: tenths, longer at the half) *Range 1 to 32, step 1.* |
| `ruler_inch_mid` | `2` |  *Range 1 to 16, step 1.* |
| `ruler_cm_div` | `10` | Centimeter scale: divisions per cm, and a longer tick every so many *Range 1 to 20, step 1.* |
| `ruler_cm_mid` | `5` |  *Range 1 to 10, step 1.* |
| `ruler_custom_unit` | `10` | Custom scale: the numbered unit in mm, its divisions, a longer tick every so many, and its name (blank for none) *Range 1 to 100, step 0.01.* |
| `ruler_custom_div` | `10` |  *Range 1 to 32, step 1.* |
| `ruler_custom_mid` | `5` |  *Range 1 to 16, step 1.* |
| `ruler_custom_name` | `""` |  |
| `ruler_number_every` | `1` | Number every this many units (1 = every inch, every cm) *Range 1 to 10, step 1.* |
| `ruler_text_size` | `3.5` | Lettering size *Range 2 to 6, step 0.1.* |
| `ruler_line_w` | `0.6` | Narrowest line in the ruler, ticks and lettering alike (keep it at or over your nozzle's width) *Range 0.3 to 1.2, step 0.05.* |
| `logo_left` | `""` | Logo files (SVG: clean outlines, no self-crossing paths) for the face's upper left and upper right corners, relative to this file's folder or a full path; blank for none |
| `logo_right` | `""` |  |
| `logo_size` | `[25, 15]` | Each logo is stretched to this box, width and height (set it to the logo's own proportions) |
| `logo_inset` | `6` | Logos' distance in from the face's flat ends and down from where the top's round-over ends *Range 0 to 40, step 0.5.* |
| `back_logo_left` | `""` | Back face: SVGs near its lower left and lower right corners, as you look at the back (so the left one is at the base's right end); for a maker's name, model, serial number, date. Blank for none |
| `back_logo_right` | `""` |  |
| `back_logo_size` | `[40, 15]` | Each back logo is stretched to this box, width and height |
| `back_logo_inset` | `6` | Back logos' distance in from the face's flat ends (clear of the harness rods' holes) and up from the bottom *Range 0 to 40, step 0.5.* |
| `bottom_logo_left` | `""` | Bottom: SVGs centered on the left and right halves of the base (where it splits, whether or not it is split), as you look at the bottom with the base tipped back onto its back edge. Blank for none |
| `bottom_logo_right` | `""` |  |
| `bottom_logo_size` | `[80, 40]` | Each bottom logo is stretched to this box, width and height |
| `face_relief` | `"raised"` | Ruler and logos on the front and back: raised from the face, engraved into it, or inlaid (engraved and filled flush). Raised and inlaid marks are color-tagged for another filament: each mark and the base its own random color (export 3MF to keep them; needs an OpenSCAD with the Manifold backend) *Choices: raised, engraved, inlaid.* |
| `bottom_relief` | `"engraved"` | The bottom's logos: engraved, or inlaid (color-tagged). Not raised: the base prints standing on its bottom *Choices: engraved, inlaid.* |
| `face_relief_depth` | `0.6` | How far they stand out or cut in *Range 0.3 to 2, step 0.1.* |
| `face_color_seed` | `7` | Change it for another set of random colors *Range 0 to 999, step 1.* |
