bobdrzyzgula/VSM-Base/docs/motor-construction/10-sources.md

# Sources

1. [Universal Motor: construction, working and characteristics](https://www.electricaleasy.com/2014/02/universal-motor-construction-working.html), Electrical Easy.
2. [Power of a motor](https://vintagesewingmachinesblog.wordpress.com/2020/02/01/power-of-a-motor/), Vintage Sewing Machines blog, February 2020.
3. [Singer sewing machine motors, foot controllers and drive belts](https://www.singersewinginfo.co.uk/technical/parts/motors/), singersewinginfo.co.uk.
4. R. Scheibe, [Janome 415 with DC motor](https://robert-scheibe.de/repair_janome.html).
5. [Motor drive for sewing machines](https://community.simplefoc.com/t/motor-drive-for-sewing-machines/4621), SimpleFOC Community forum.
6. [775 DC Motor, 24 V 8300 RPM](https://robotshop.com/products/e-s-motor-775-dc-motor-high-speed-big-torque-24v-8300-rpm), RobotShop product page.
7. [50SRZ 12 V/24 V DC motor](https://www.ebay.de/itm/226397386344), eBay listing.
8. [42BLS02 24 V 4000 RPM brushless motor](https://st.robu.in/product/42bls02-24v-rpm4000-0-125-n-cm-61mm), Robu product page.
9. [57 mm Brushless DC Motor with Driver Kit, 24 V 103 W](https://www.robotshop.com/products/e-s-motor-57mm-brushless-dc-motor-w-driver-kits-24v-103w), RobotShop product page.
10. [Brushless Digital D.C. Servo Motor](https://leathermachineco.com/product/brushless-digital-d-c-servo-motor/), Leather Machine Co. product page.
11. I. Skalka, [*Low-Cost Universal Motor Phase Angle Drive System*](https://nxp.com/docs/en/application-note/AN1662.pdf), Freescale AN1662.
12. [New brushes for the DCF885](https://proxy.ifixit.com/Answers/View/829312/new+brushes+for+the+DCF885), iFixit Answers.
13. [vhbw carbon brushes for the DeWalt DCD780 and DCD785](https://www.manomano.co.uk/p/vhbw-2x-carbon-brush-45-x-35-x-11-mm-compatible-with-dewalt-dcd785l-dcd780-dcd780c2-dcd780l2-dcd785-dcd785c2-dcd785l2-drill-driver-63022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), ManoMano product page.
14. A. Hughes and B. Drury, *Electric Motors and Drives: Fundamentals, Types and Applications*, 5th ed., Newnes, 2019.
15. A. E. Fitzgerald, C. Kingsley and S. D. Umans, *Electric Machinery*, 7th ed., McGraw-Hill, 2014.

The motor model, its equations and the speed-control methods are those of
the companion paper, *Speed Control of Universal Motors in Sewing Machines*,
and its sources. The simulations and drawings are generated by
`tools/make_motor_waveforms.py` and `tools/make_motor_drawings.py` in the
project repository. The cordless-tool spectra in §5 are Robert Drzyzgula's
measurements, phone screenshots kept in `docs/images/motors/measured/`, read
back and replotted by `tools/make_tool_spectra.py`.

The construction and theory of the motors themselves, §2 and §4–§7, are
standard textbook material, given here without citation line by line.
Hughes and Drury is the readable practitioner's account, drives included;
Fitzgerald, Kingsley and Umans is the standard engineering text.
