bobdrzyzgula/VSM-Base/docs/guide/08-other-machines.md

# Other machines and hinges

*This chapter is an outline, still to be written. It will cover:*

- The profiles so far: the Singer 99K, and the Kenmore 158-14001 (a
  425 × 185 mm bed set flush and carried on its three feet, 6 mm hinge
  holes, a cord slot at the back), measured by Bob Drzyzgula. The Kenmore's
  bed is too long for halves with the side compartment built in: use
  `compartment_mount = "attached"`, and `hinge_type = "printed"`, since
  its own hinges went with its molded base. Its base is in the 250 mm depth
  class with the printed hinge, so lower `printer_margin` to 3 mm to fit a
  256 mm printer, or set `back_rim_width` (outside the standard classes).
  Its bed sits 3.9 mm lower than the 99K's, so the base is raised to the
  standard extension height.
- What changes between machines, and what to measure.
- Machines without a side compartment, and bases for larger beds.
- Adding a hinge type: the footprint functions and the cutter module.
- Contributing a machine profile.
