bobdrzyzgula/VSM-Base/docs/guide/07-assembly.md

# Assembly

*This chapter is an outline, still to be written. It will cover:*

- Clearing the membranes and knock-out walls.
- Nuts into the plate and hinge nut traps.
- Joining the halves: dovetails, then the mending plates from below.
- Tip: once the nuts are in their traps in the cavity floor, put a strip of
  masking tape over them. Then they stay put when you turn the base over to
  drive the plate screws in from below; peel the tape off afterward.

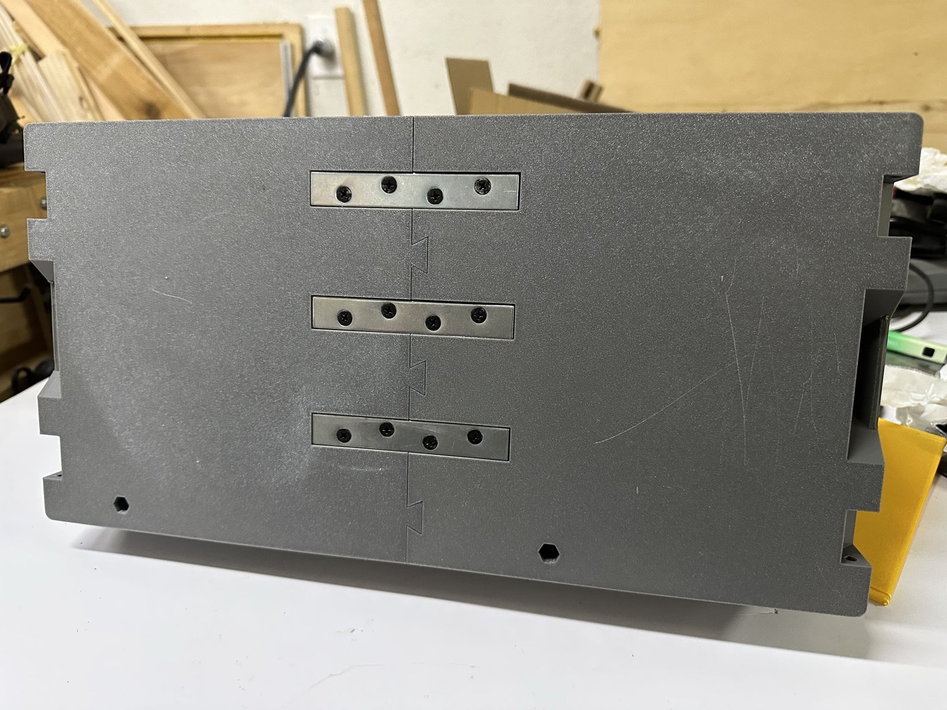
[picture p35: docs/images/photos/plates-underside.jpg]
The joined halves from below: three mending plates across the split, each with four 1/2" #8-32 flat-head screws.


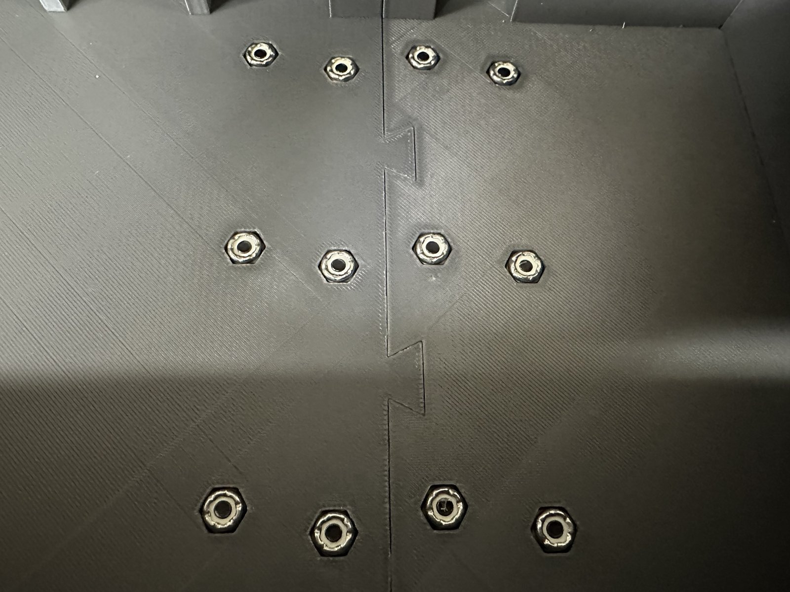
[picture p36: docs/images/photos/plate-nuts.jpg]
Inside, the screws' nylon-insert locknuts sit in their traps in the cavity floor, either side of the dovetail keys. The screws push through the traps' printed membranes; no drilling needed.


- Installing the hinges and setting the machine on its pins.
- The hinge nuts (lollipop hinges): the nut traps open on the underside. Push a nut onto the
  tip of the printed nut tool (`part = "hinge_nut_tool"`), nylon side
  first for a locknut, slide it up the trap until it seats, and hold it
  there while you start the screw from above; once the screw has caught,
  pull the tool out and finish. The tip is sized for the 1/8" bore of a
  nylon-insert locknut (`hinge_nut_tool_tip`). A standalone version for other nut sizes
  and trap depths is in `standalone/nut-tool/`.
- Printed hinges: cut the pins and pivots to the console's lengths and
  deburr them. Press a pin into each arm's front face to the bottom of its
  hole (a vise works). Slide a nut into the slot in each block's front
  face, under the arm's channel, until it lines up with the screw hole. Set
  the arm between the block's cheeks and press the pivot rod through cheek,
  arm and cheek until its ends are flush with the block's sides, with the
  arm's engraved arrow on its bottom face, pointing toward the pin (the arm
  isn't symmetrical top to bottom); the arm should swing freely. Drop the block into its recess, pin toward the bed;
  the recess's front wall closes the nut's slot. Drive the screw (#8-32 ×
  5/8", pan or socket head) up from under the base, through the round
  counterbore (its head bears on the counterbore's roof; push it through
  the printed membrane), into the block's nut. The recess walls
  keep the pivot rod from working out.
- Trim strips, with the extensions off: tap the peg inserts into the
  trims' holes, as into the lips, and press the trims into the rim cuts.
  The cord slot's trim presses into the top of the slot once the cords are
  in.
- Outlet cords through the walls: with the outlet in place, lay each cord
  down into its wall slot (with `rear`, press the controller cord on edge
  into the floor channel first, past its lips, starting at the bend), then
  press the trims in from above.
- Harness rods and carrying.
- An attached bay: inserts into its inner wall, dowels into the base's end face, then the four screws from inside the machine cavity.
- Extensions on their pegs, the corner piece's dovetails, and snapping in the lids.
