bobdrzyzgula/VSM-Base/docs/images/motors/measured/drill-ambient.jpg

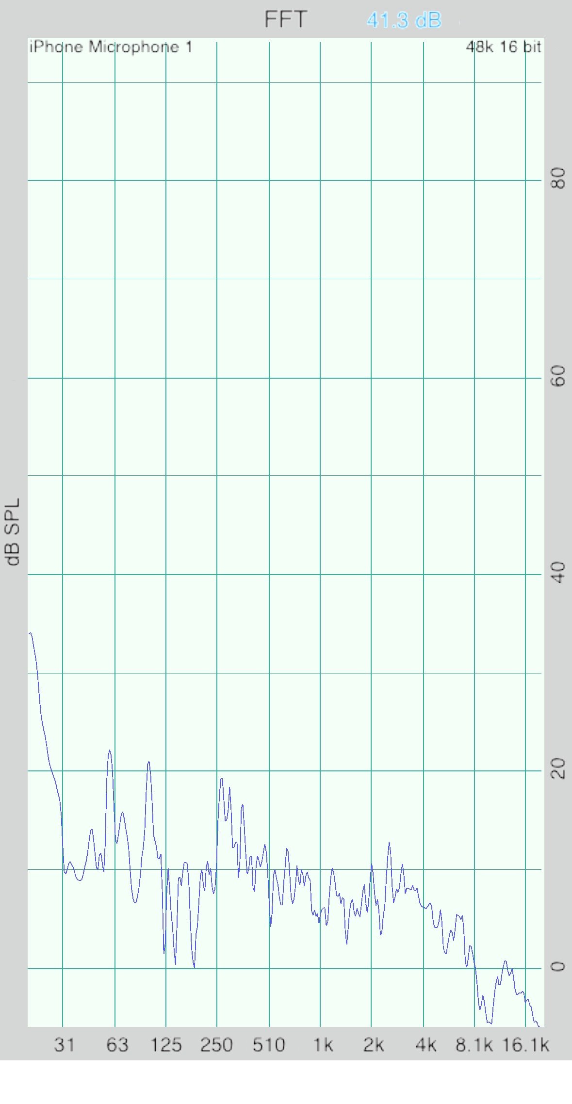
docs/images/motors/measured/drill-ambient.jpg
