bobdrzyzgula/VSM-Base/docs/images/motors/measured/drill-full.jpg

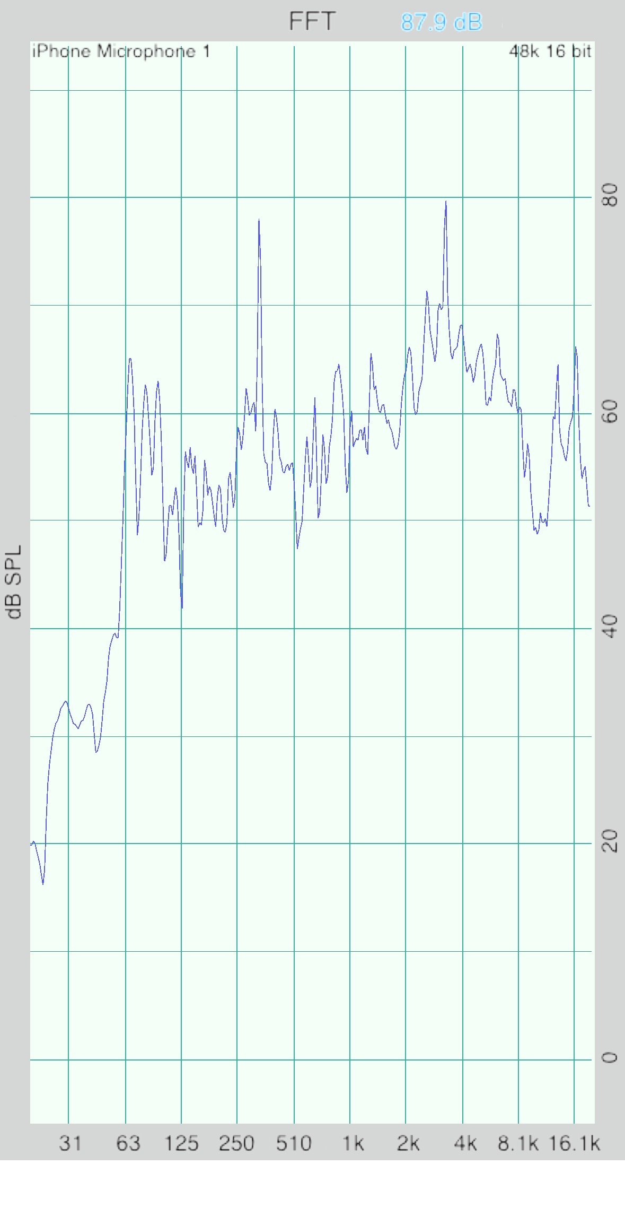
docs/images/motors/measured/drill-full.jpg
