bobdrzyzgula/VSM-Base/docs/images/motors/measured/drill-low.jpg

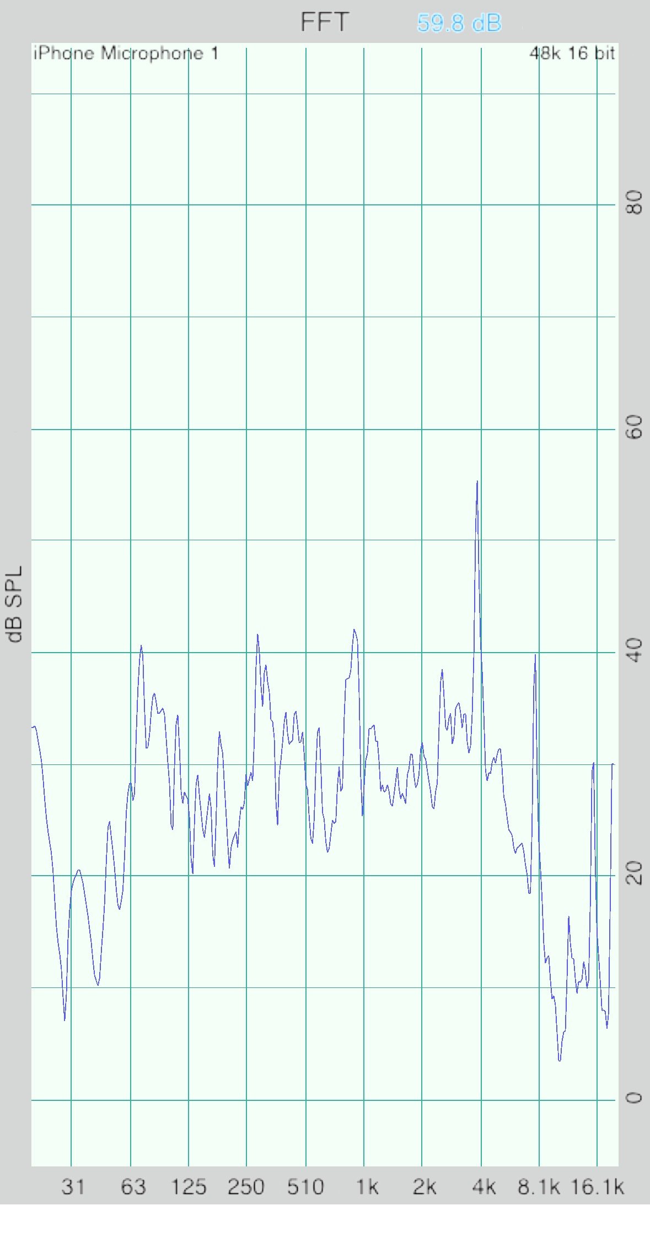
docs/images/motors/measured/drill-low.jpg
