bobdrzyzgula/VSM-Base/docs/images/motors/measured/impact-ambient.jpg

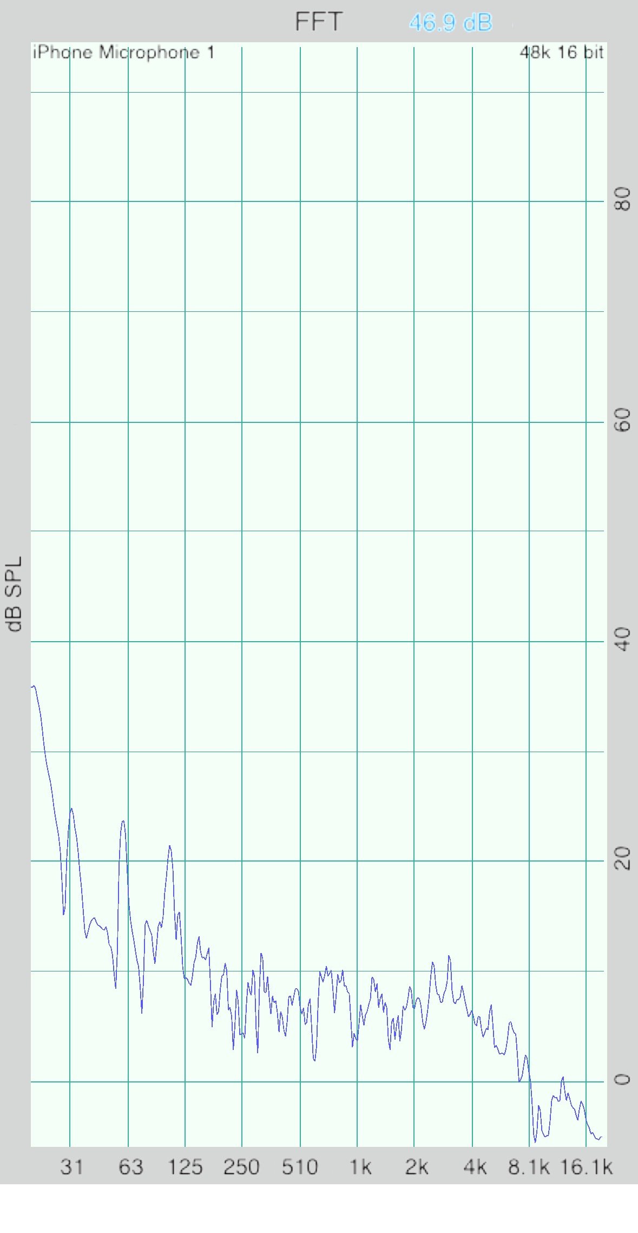
docs/images/motors/measured/impact-ambient.jpg
