bobdrzyzgula/VSM-Base/docs/images/motors/measured/impact-full.jpg

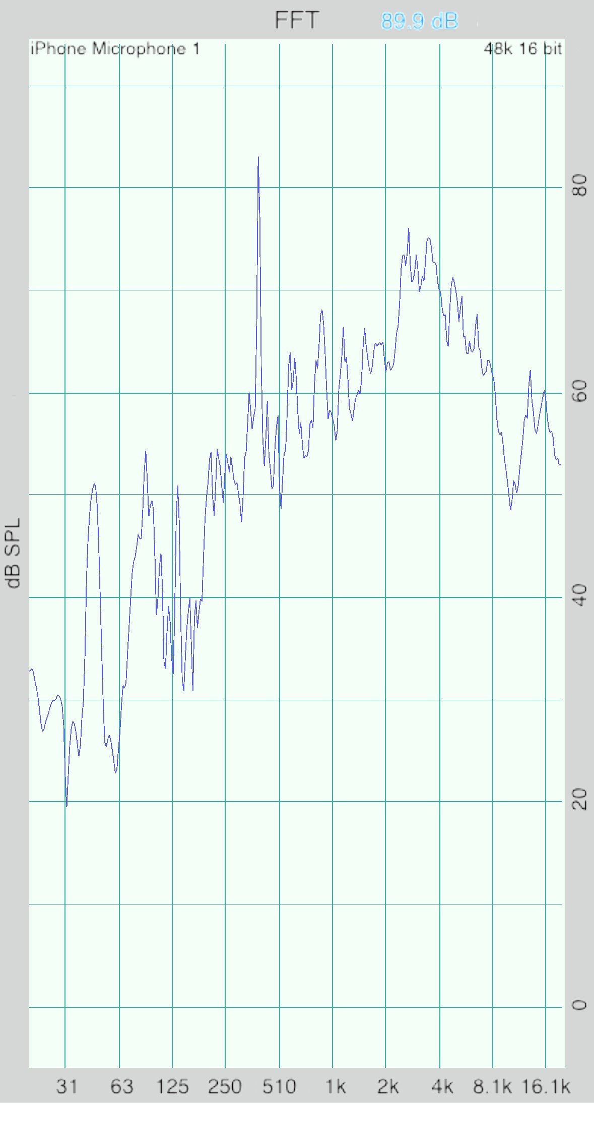
docs/images/motors/measured/impact-full.jpg
