bobdrzyzgula/VSM-Base/docs/images/motors/measured/impact-low.jpg

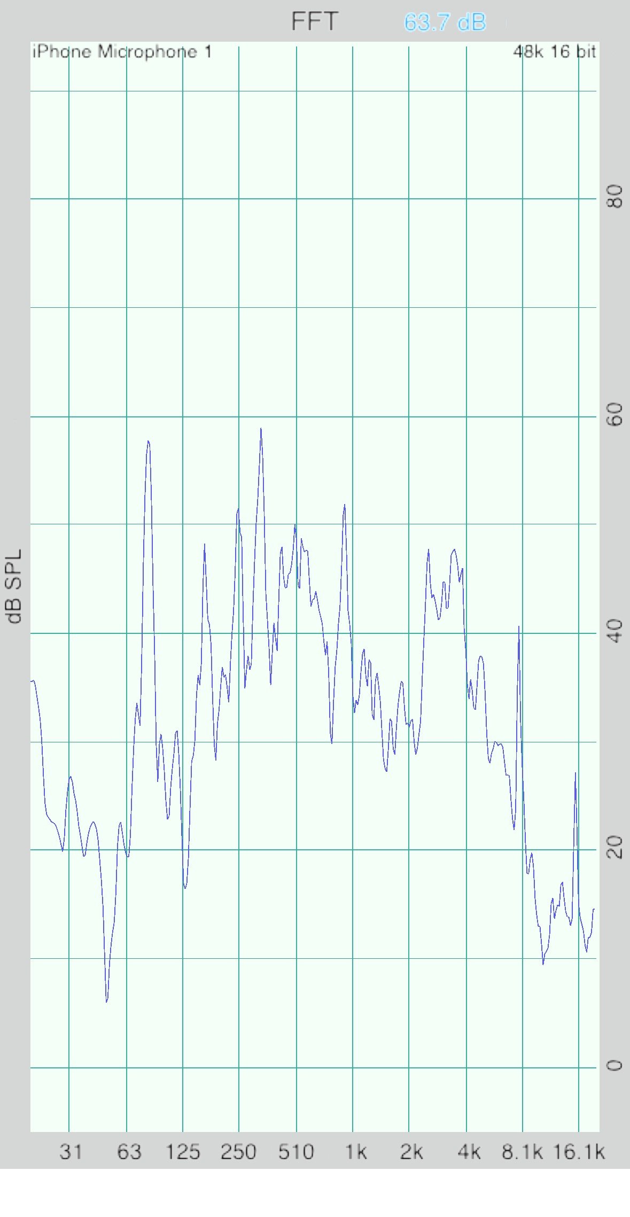
docs/images/motors/measured/impact-low.jpg
