bobdrzyzgula/VSM-Base/hardware/mcu-controller-rectified/mcu_controller_rectified.pdf

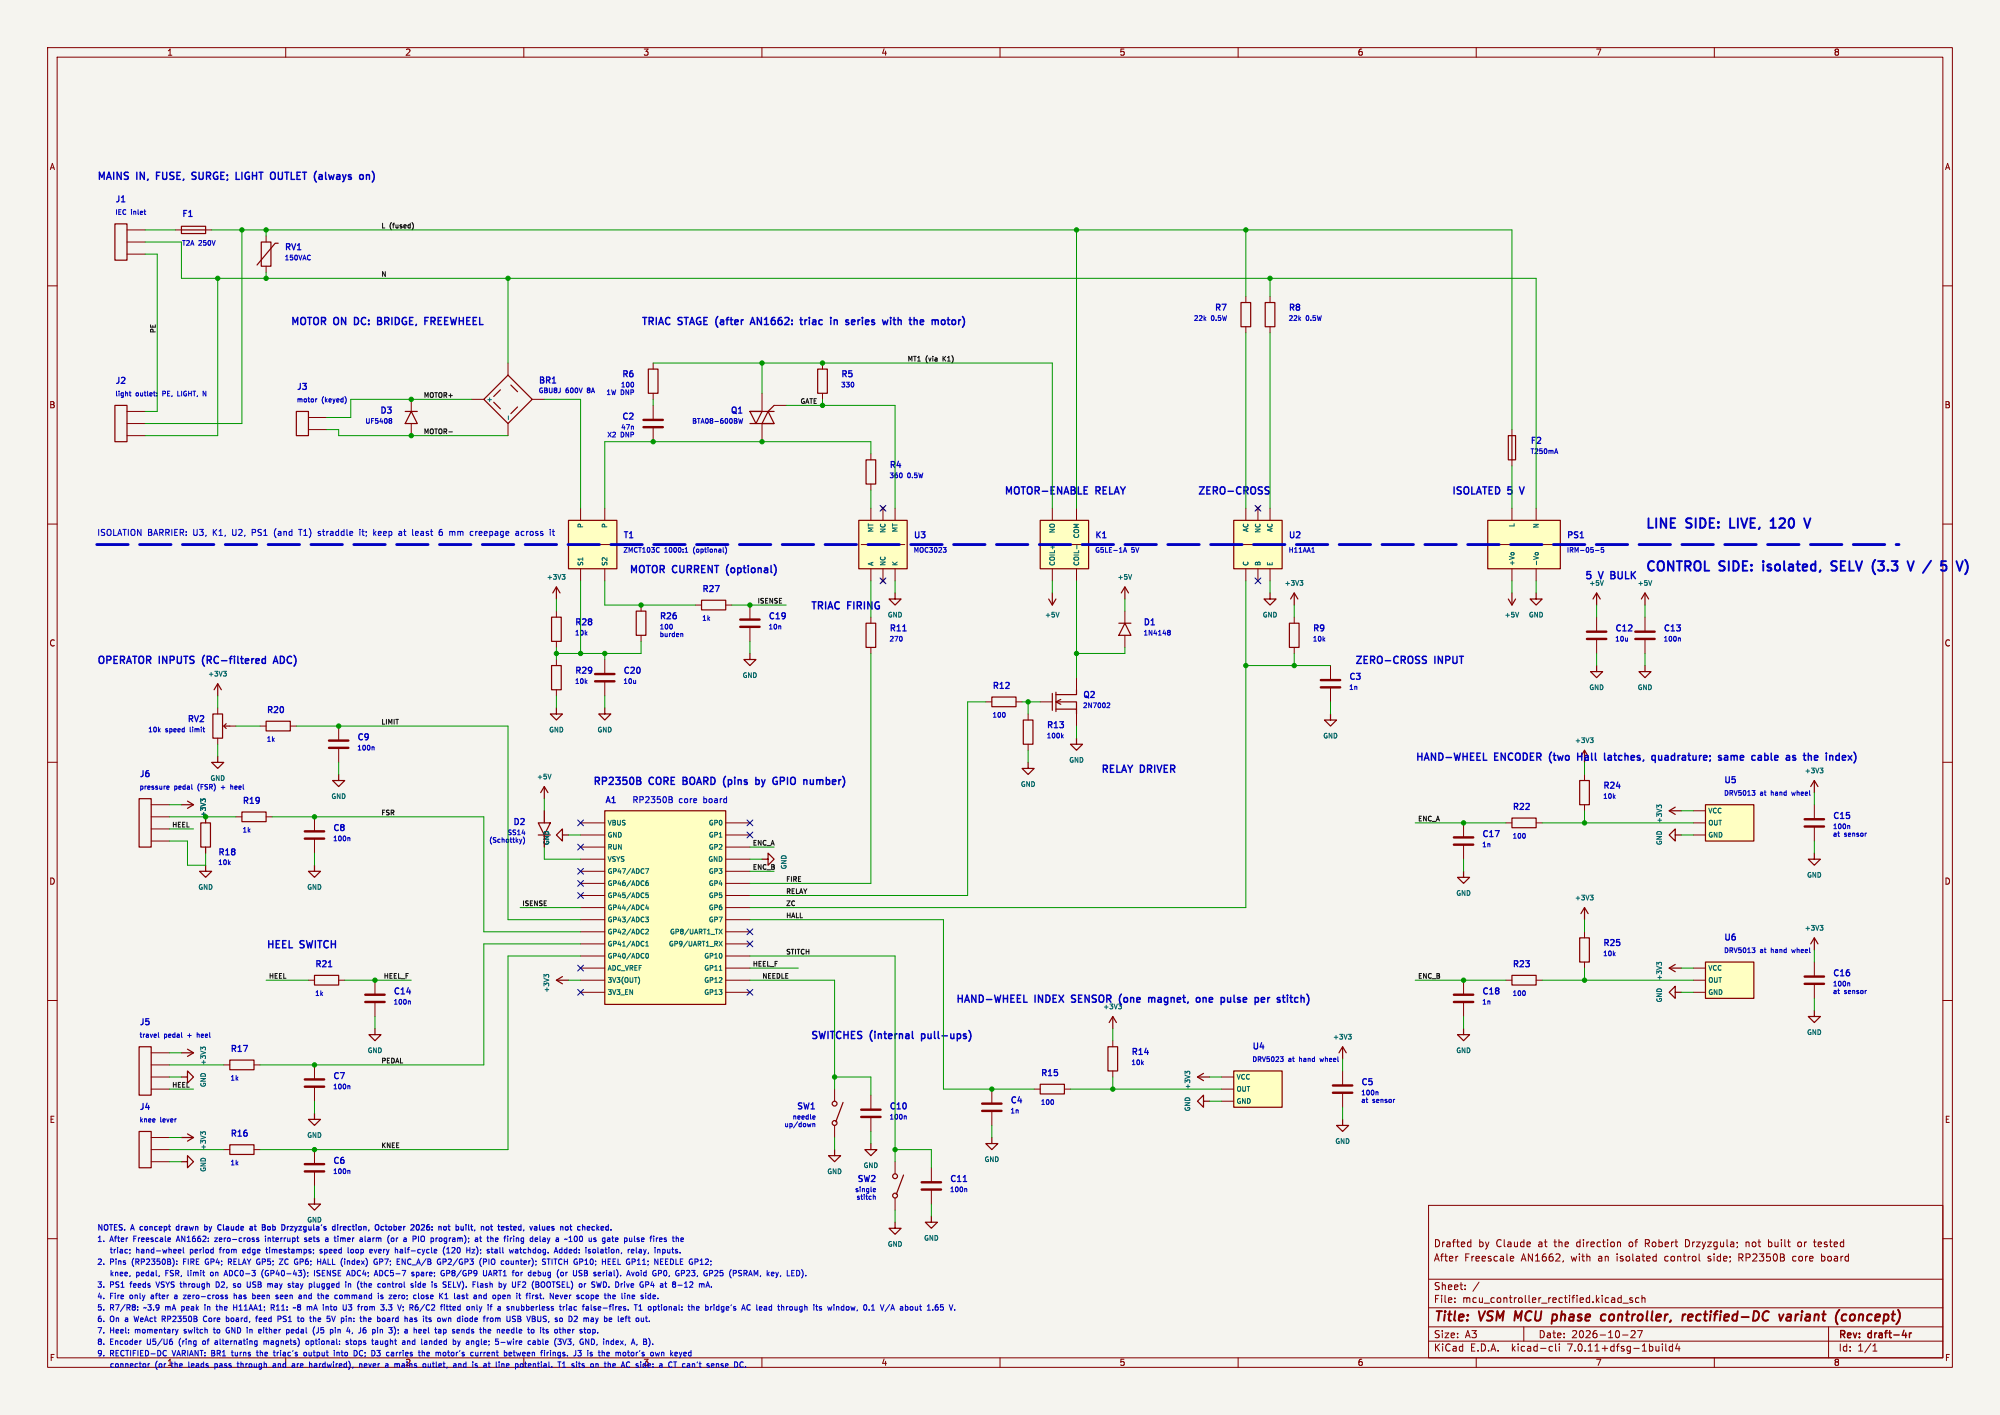
[picture p44: page 1]

(Schottky) MOTOR ON DC: BRIDGE, FREEWHEEL
HEEL_F PE

10k Q2 MAINS IN, FUSE, SURGE; LIGHT OUTLET (always on)

VCC OUT GND GND GND
