bobdrzyzgula/VSM-Base/hardware/mcu-controller-dc/mcu_controller_dc.pdf

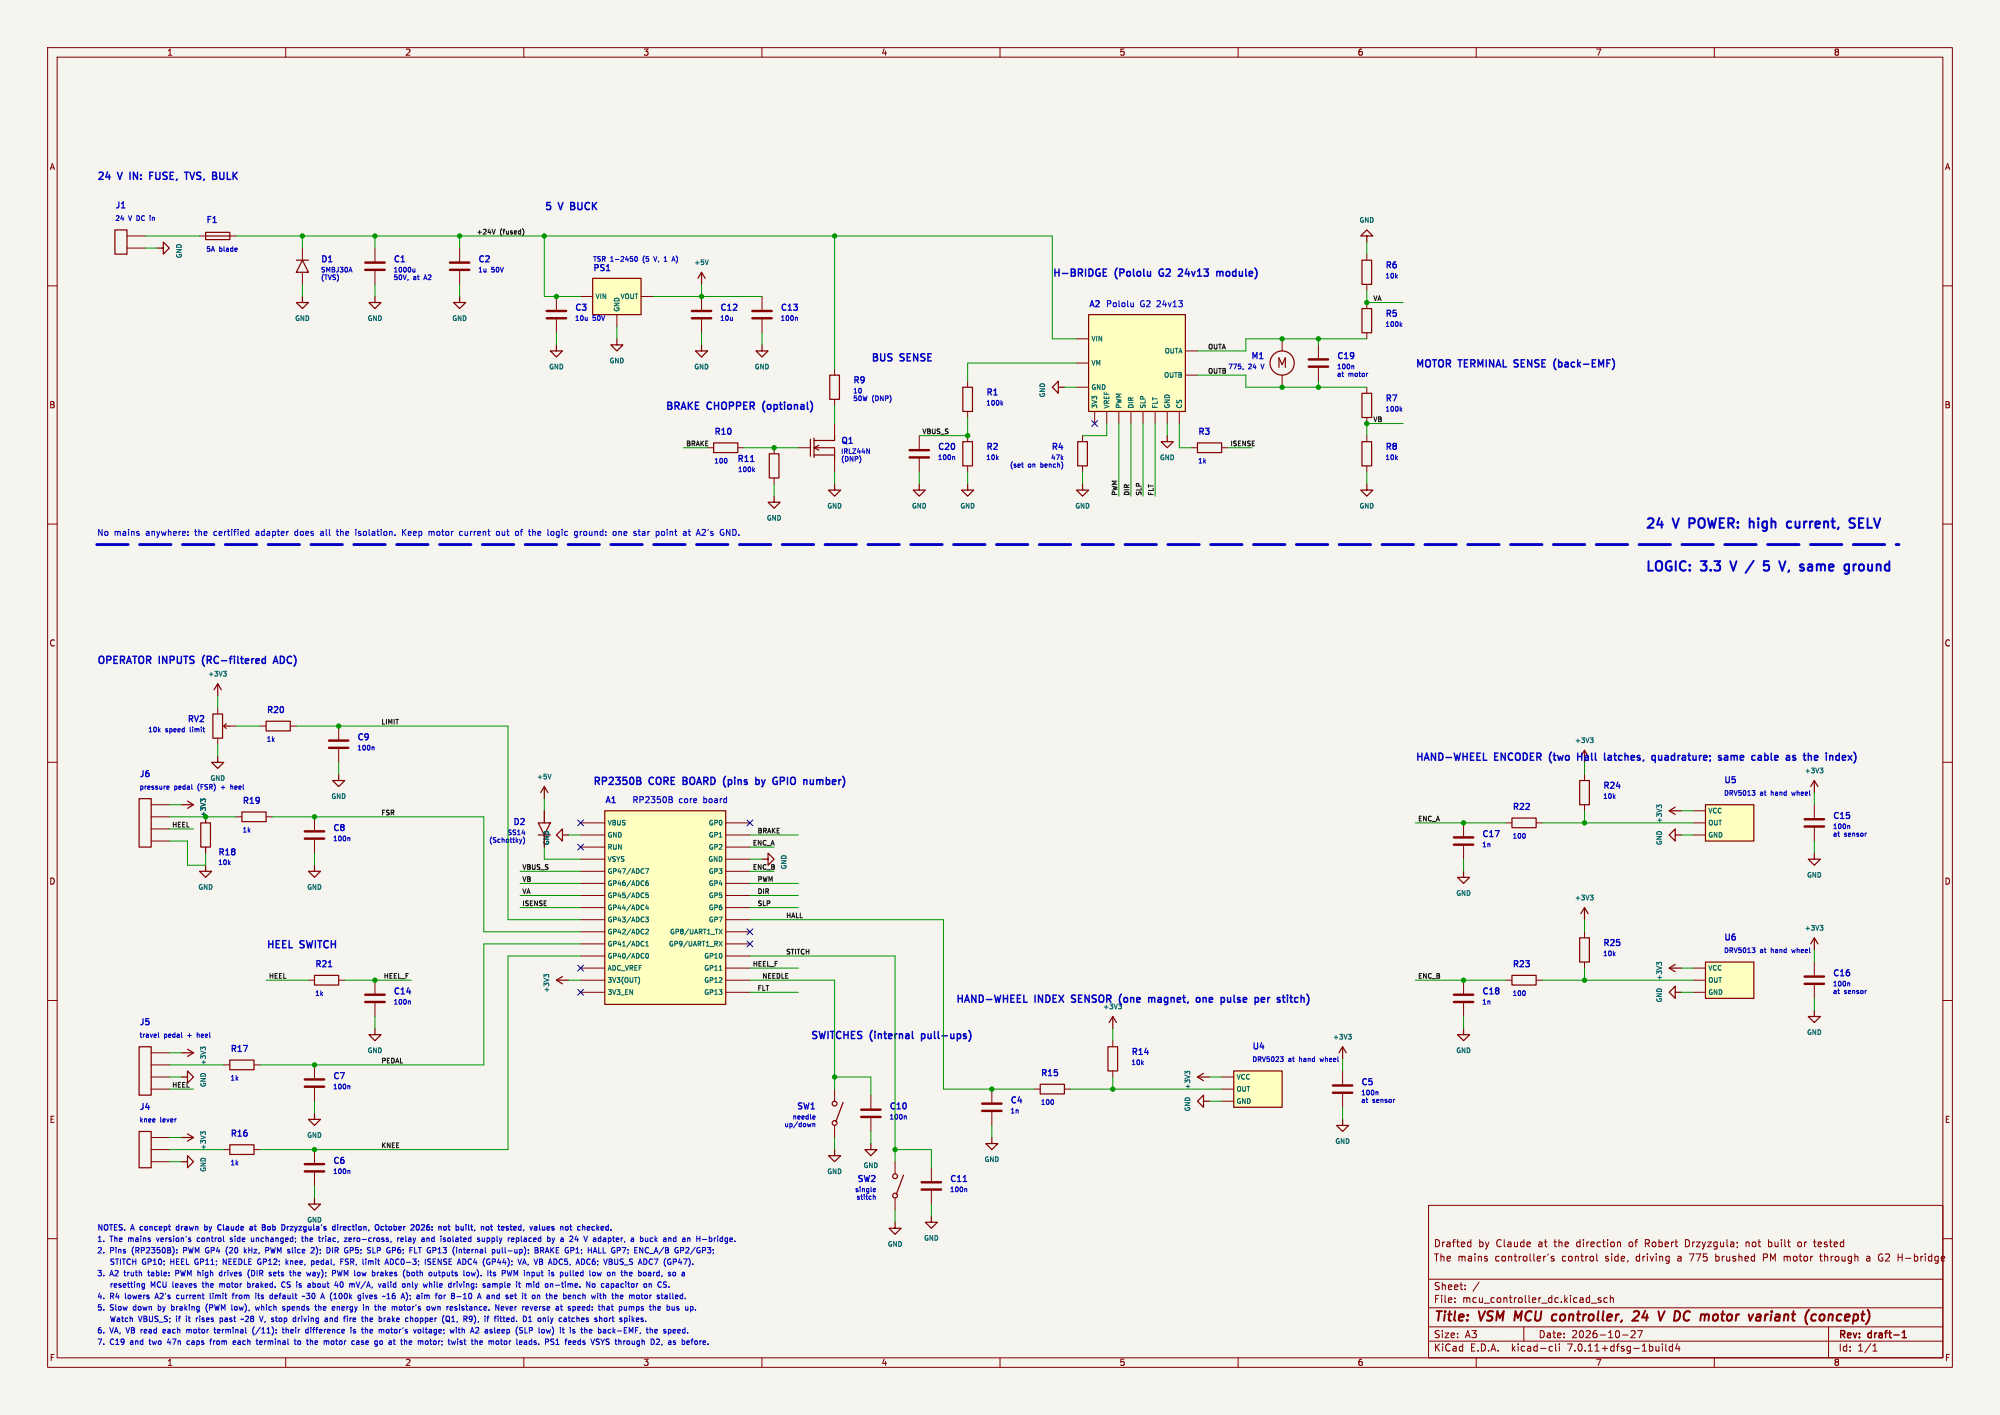
[picture p45: page 1]

24 V IN: FUSE, TVS, BULK

100k RP2350B CORE BOARD (pins by GPIO number) BRAKE CHOPPER (optional) HEEL SWITCH

24 V POWER: high current, SELV

+3V3 VCC OUT GND GND
