bobdrzyzgula/VSM-Base/hardware/mcu-controller/mcu_controller.pdf

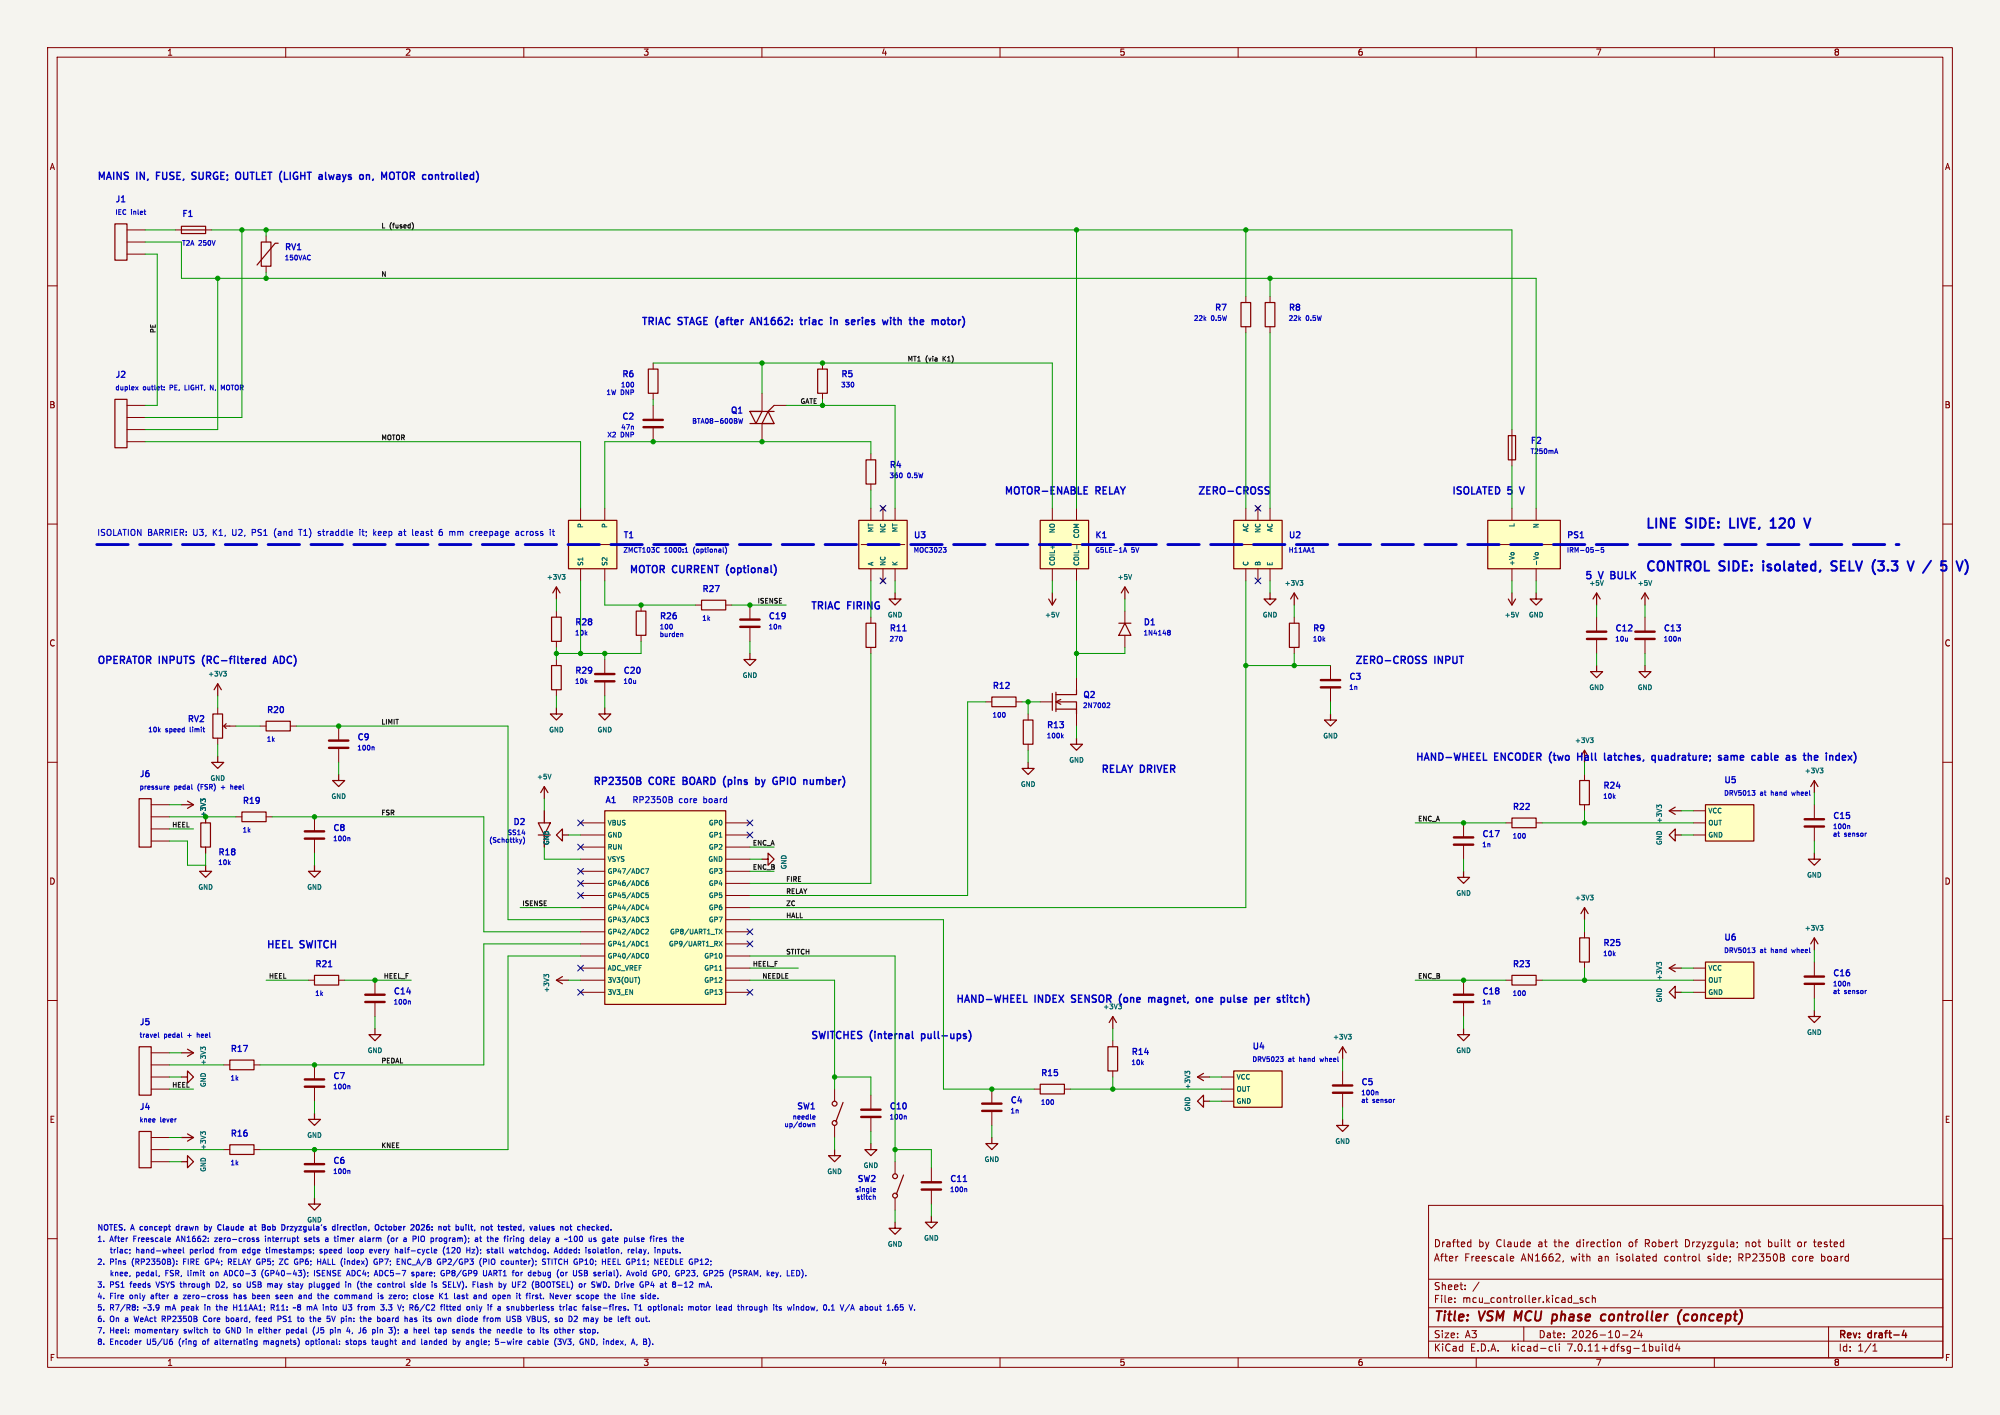
[picture p46: page 1]

ISENSE HEEL_F HEEL HEEL PE

T250mA F2 RP2350B CORE BOARD (pins by GPIO number) 10u C20

P S1S2 +3V3 GND GND COIL+ COIL- COMNO

VCC OUT GND GND
