bobdrzyzgula/VSM-Base/hardware/mcu-controller-dc/mcu_controller_dc.kicad_sch

## KiCad design hardware/mcu-controller-dc/mcu_controller_dc.kicad_sch (2026-10-27)

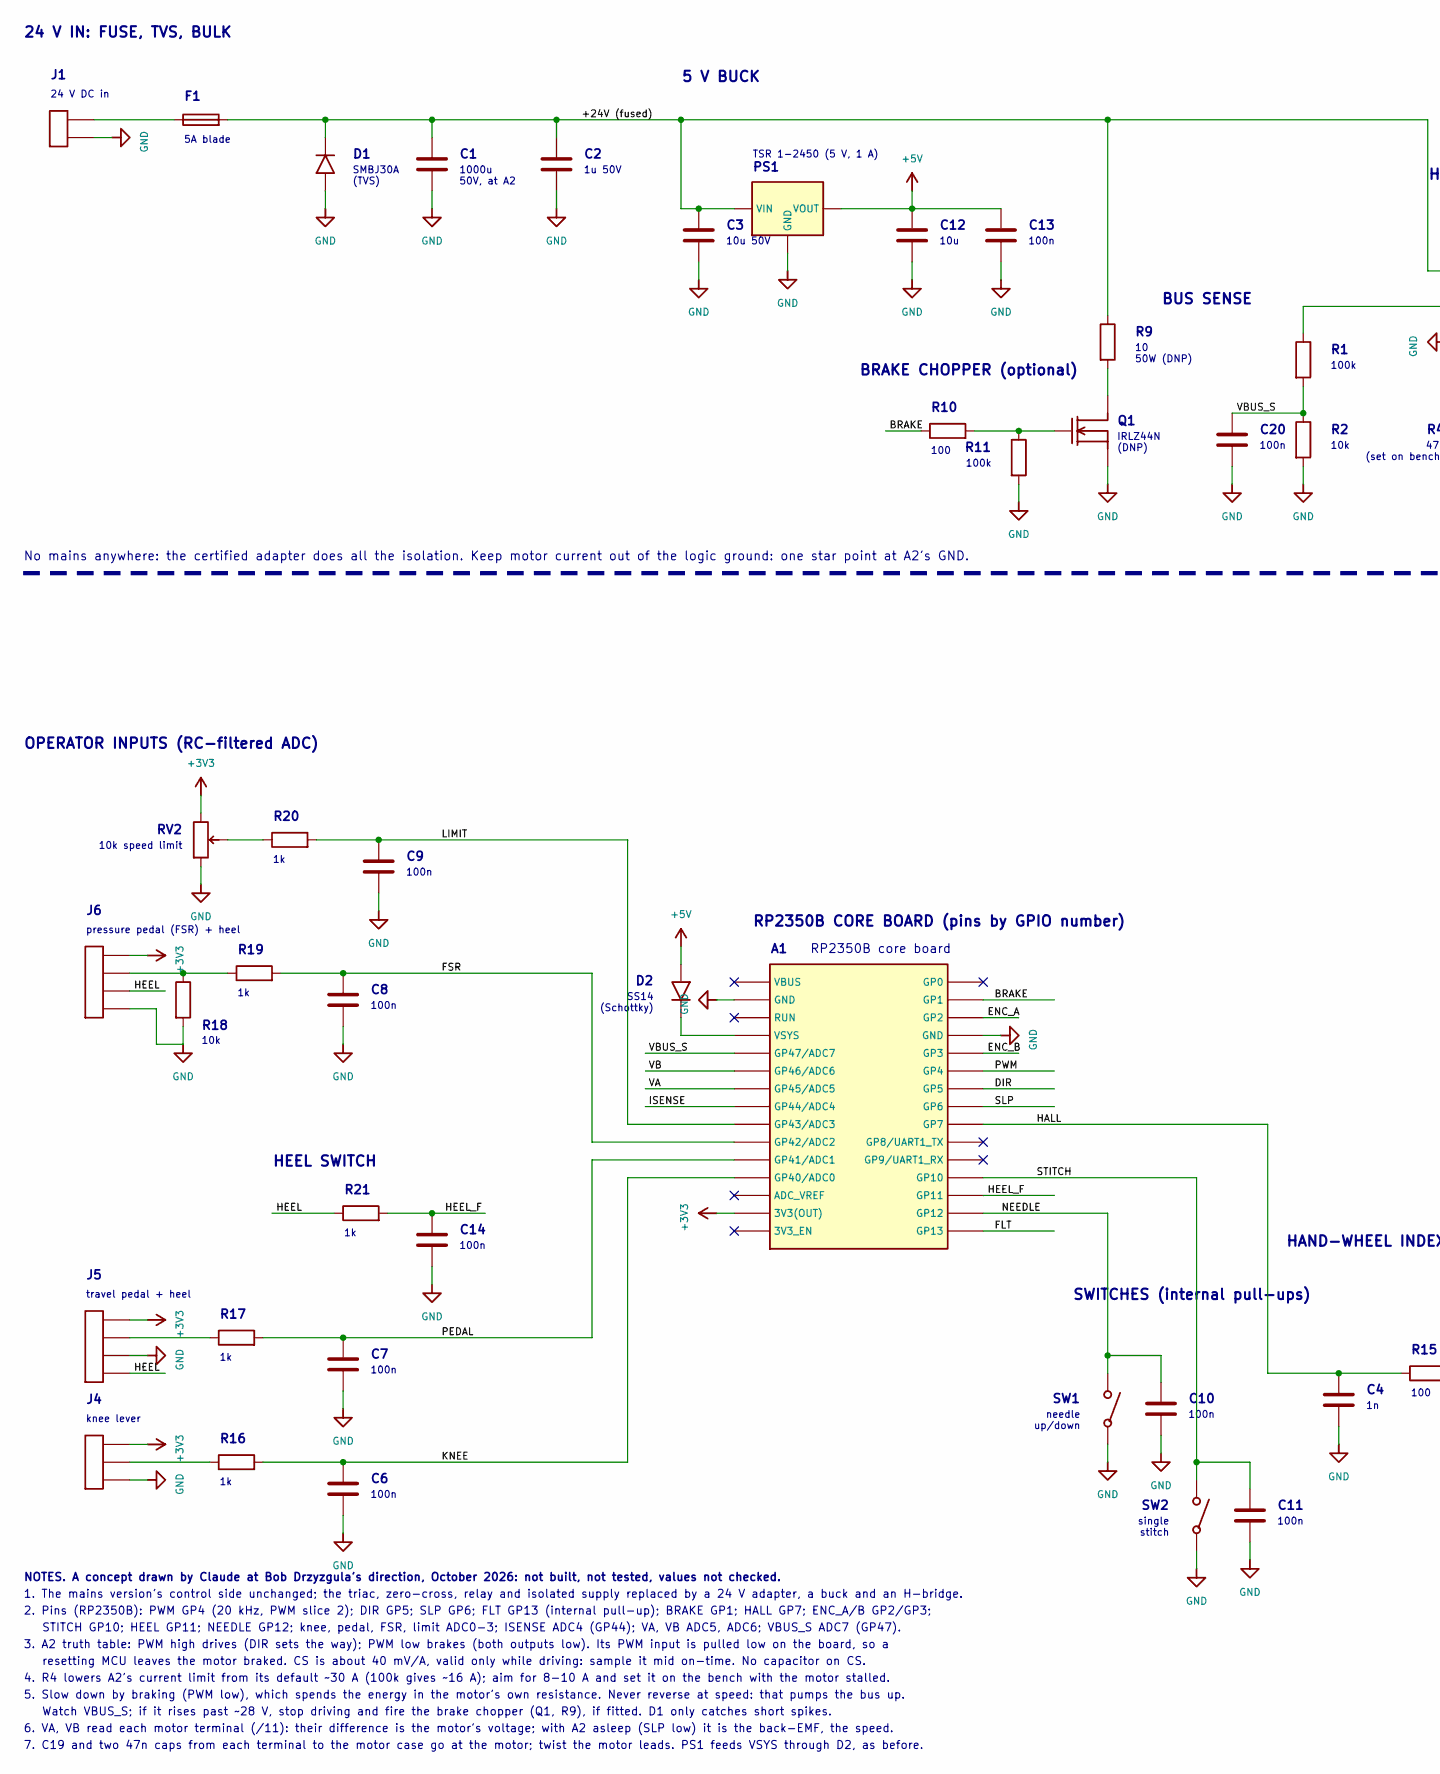
[picture p47: schematic mcu_controller_dc.kicad_sch, part in row 1, column 1]

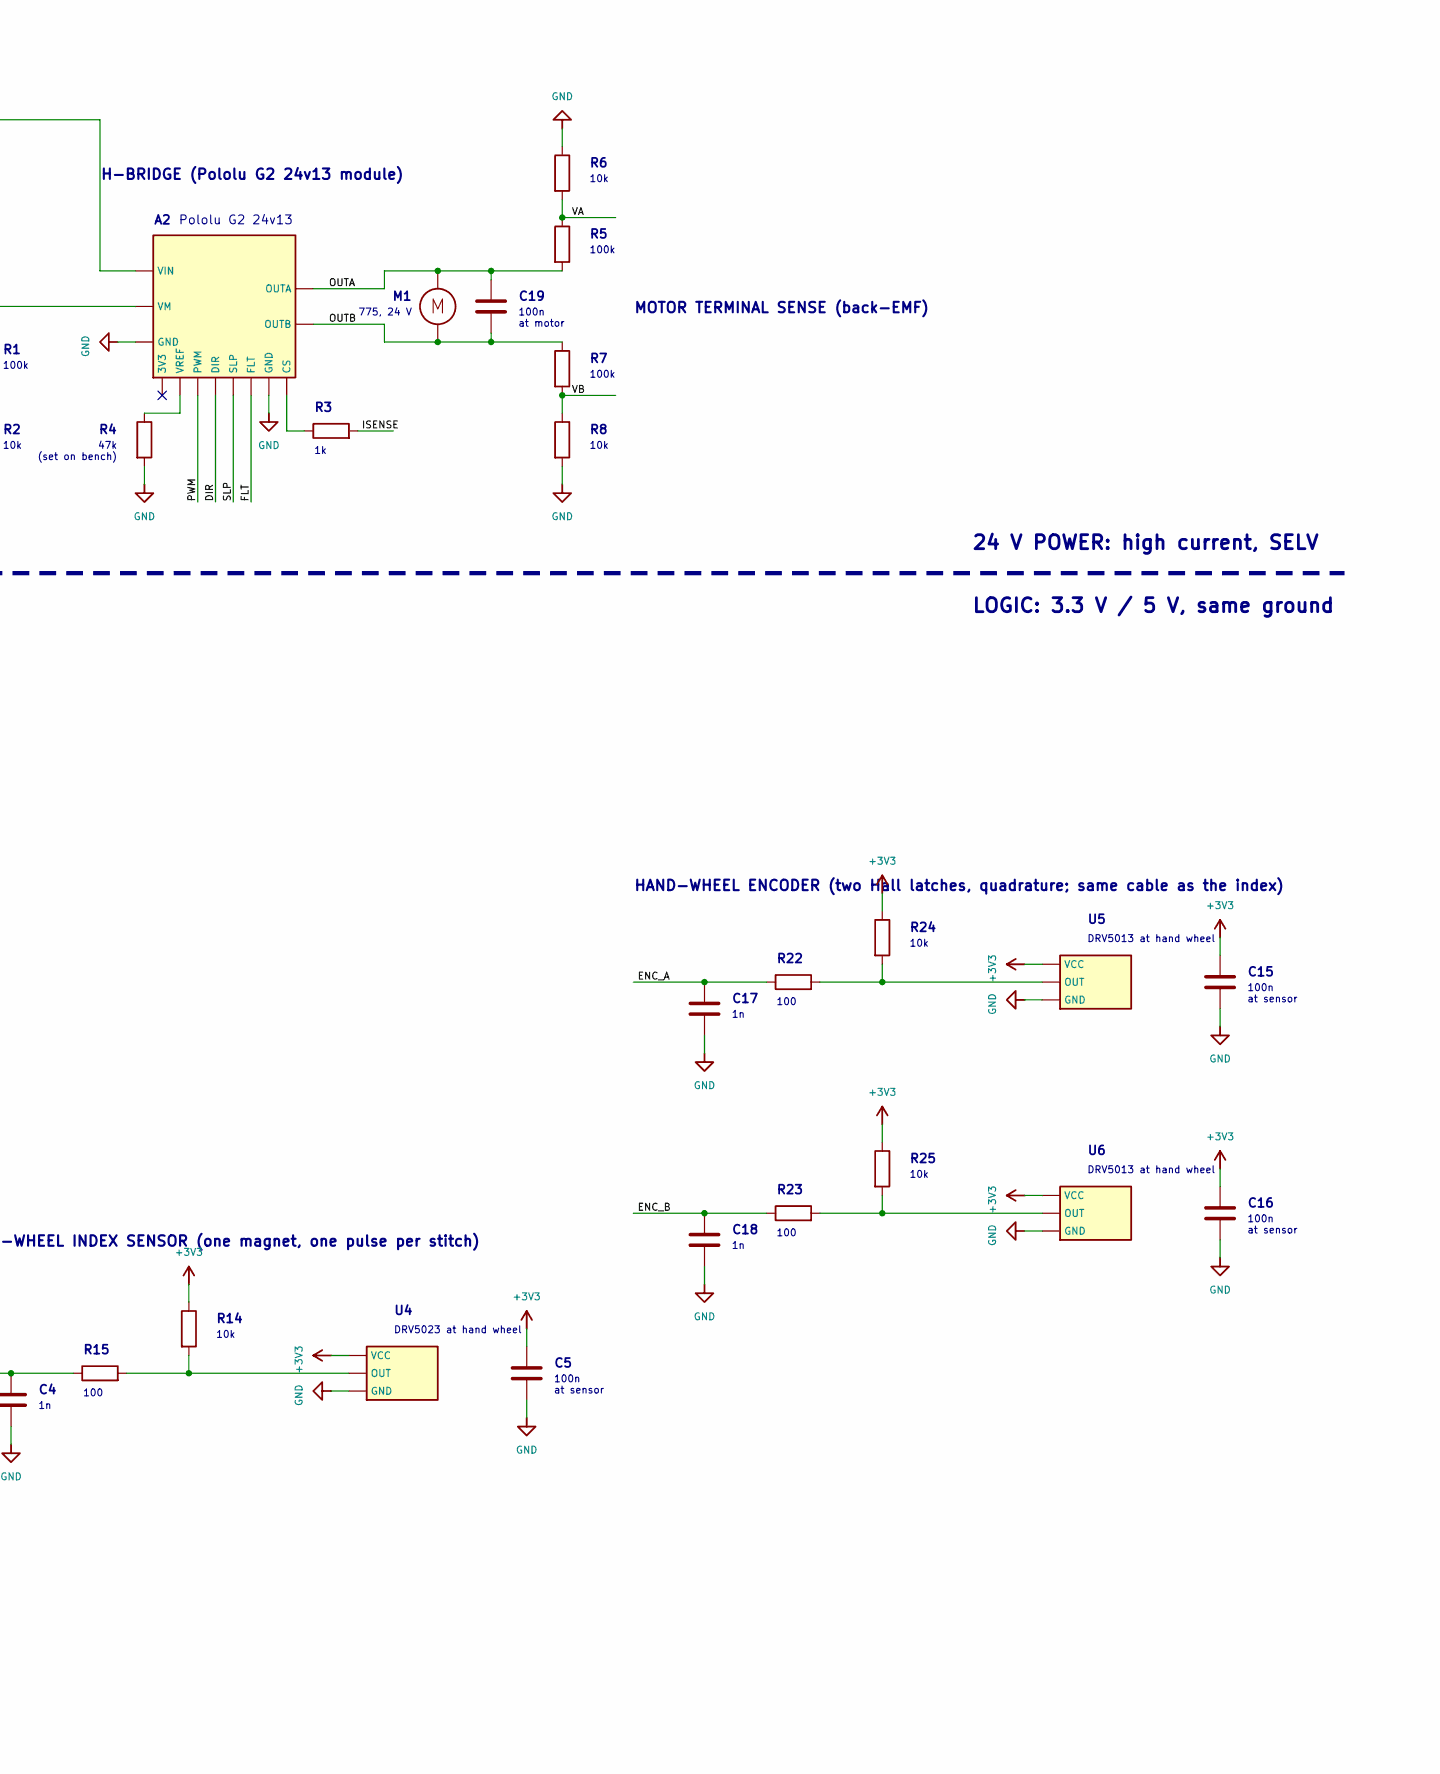
[picture p48: schematic mcu_controller_dc.kicad_sch, part in row 1, column 2]

Parts:
A1: RP2350B core board
A2: Pololu G2 24v13
C1: 1000u 50V, at A2
C2: 1u 50V
C3: 10u 50V
C4, C17, C18: 1n
C5, C15, C16: 100n at sensor
C6, C7, C8, C9, C10, C11, C13, C14, C20: 100n
C12: 10u
C19: 100n at motor
D1: SMBJ30A (TVS)
D2: SS14 (Schottky)
F1: 5A blade
J1: 24 V DC in
J4: knee lever
J5: travel pedal + heel
J6: pressure pedal (FSR) + heel
M1: 775, 24 V
PS1: TSR 1-2450 (5 V, 1 A)
Q1: IRLZ44N (DNP)
R1, R5, R7, R11: 100k
R2, R6, R8, R14, R18, R24, R25: 10k
R3, R16, R17, R19, R20, R21: 1k
R4: 47k (set on bench)
R9: 10 50W (DNP)
R10, R15, R22, R23: 100
RV2: 10k speed limit
SW1: needle up/down
SW2: single stitch
U4: DRV5023 at hand wheel
U5, U6: DRV5013 at hand wheel

Connections:
+3V3: A1.L14 (3V3(OUT)), C5.1, C15.1, C16.1, J4.1, J5.1, J6.1, R14.1, R24.1, R25.1, RV2.1, U4.1 (VCC), U5.1 (VCC), U6.1 (VCC)
+5V: C12.1, C13.1, D2.2 (A), PS1.3 (VOUT)
+24V (fused): A2.VIN, C1.1, C2.1, C3.1, D1.1 (K), F1.2, PS1.1 (VIN), R9.1
BRAKE: A1.R2 (GP1), R10.1
DIR: A1.R7 (GP5), A2.DIR
ENC_A: A1.R3 (GP2), C17.1, R22.1
ENC_B: A1.R5 (GP3), C18.1, R23.1
FLT: A1.R15 (GP13), A2.FLT
FSR: A1.L10 (GP42/ADC2), C8.1, R19.2
GND: A1.L2 (GND), A1.R4 (GND), A2.LGND (GND), A2.PGND (GND), C1.2, C2.2, C3.2, C4.2, C5.2, C6.2, C7.2, C8.2, C9.2, C10.2, C11.2, C12.2, C13.2, C14.2, C15.2, C16.2, C17.2, C18.2, C20.2, D1.2 (A), J1.2, J4.3, J5.3, J6.4, PS1.2 (GND), Q1.2 (S), R2.2, R4.2, R6.1, R8.2, R11.2, R18.2, RV2.3, SW1.2, SW2.2, U4.3 (GND), U5.3 (GND), U6.3 (GND)
HALL: A1.R9 (GP7), C4.1, R15.1
HEEL: J5.4, J6.3, R21.1
HEEL_F: A1.R13 (GP11), C14.1, R21.2
ISENSE: A1.L8 (GP44/ADC4), R3.2
KNEE: A1.L12 (GP40/ADC0), C6.1, R16.2
LIMIT: A1.L9 (GP43/ADC3), C9.1, R20.2
NEEDLE: A1.R14 (GP12), C10.1, SW1.1
unnamed: A1.L4 (VSYS), D2.1 (K)
unnamed: A2.CS, R3.1
unnamed: A2.VM, R1.1
unnamed: A2.VREF, R4.1
unnamed: F1.1, J1.1
unnamed: J4.2, R16.1
unnamed: J5.2, R17.1
unnamed: J6.2, R18.1, R19.1
unnamed: Q1.1 (G), R10.2, R11.1
unnamed: Q1.3 (D), R9.2
unnamed: R14.2, R15.2, U4.2 (OUT)
unnamed: R20.1, RV2.2 (W)
unnamed: R22.2, R24.2, U5.2 (OUT)
unnamed: R23.2, R25.2, U6.2 (OUT)
OUTA: A2.OUTA, C19.1, M1.1 (+), R5.2
OUTB: A2.OUTB, C19.2, M1.2 (-), R7.1
PEDAL: A1.L11 (GP41/ADC1), C7.1, R17.2
PWM: A1.R6 (GP4), A2.PWM
SLP: A1.R8 (GP6), A2.SLP
STITCH: A1.R12 (GP10), C11.1, SW2.1
VA: A1.L7 (GP45/ADC5), R5.1, R6.2
VB: A1.L6 (GP46/ADC6), R7.2, R8.1
VBUS_S: A1.L5 (GP47/ADC7), C20.1, R1.2, R2.1

Notes on the sheet:
RP2350B core board
SS14
(Schottky)
R15
100
R14
10k
DRV5023 at hand wheel
100n
at sensor
SW1
needle
up/down
C10
SW2
single
stitch
C11
RV2
10k speed limit
R20
pressure pedal (FSR) + heel
R18
R19
travel pedal + heel
R17
knee lever
R16
R21
C14
C17
R22
R24
DRV5013 at hand wheel
C15
C18
R23
R25
C16
24 V DC in
5A blade
SMBJ30A
(TVS)
1000u
50V, at A2
1u 50V
10u 50V
PS1
TSR 1-2450 (5 V, 1 A)
C12
10u
C13
50W (DNP)
IRLZ44N
(DNP)
R10
R11
100k
C20
Pololu G2 24v13
47k
(set on bench)
775, 24 V
C19
at motor
24 V POWER: high current, SELV
LOGIC: 3.3 V / 5 V, same ground
No mains anywhere: the certified adapter does all the isolation. Keep motor current out of the logic ground: one star point at A2's GND.
24 V IN: FUSE, TVS, BULK
5 V BUCK
BRAKE CHOPPER (optional)
BUS SENSE
H-BRIDGE (Pololu G2 24v13 module)
MOTOR TERMINAL SENSE (back-EMF)
RP2350B CORE BOARD (pins by GPIO number)
HAND-WHEEL INDEX SENSOR (one magnet, one pulse per stitch)
HAND-WHEEL ENCODER (two Hall latches, quadrature; same cable as the index)
HEEL SWITCH
SWITCHES (internal pull-ups)
OPERATOR INPUTS (RC-filtered ADC)
NOTES. A concept drawn by Claude at Bob Drzyzgula's direction, October 2026: not built, not tested, values not checked.
1. The mains version's control side unchanged; the triac, zero-cross, relay and isolated supply replaced by a 24 V adapter, a buck and an H-bridge.
2. Pins (RP2350B): PWM GP4 (20 kHz, PWM slice 2); DIR GP5; SLP GP6; FLT GP13 (internal pull-up); BRAKE GP1; HALL GP7; ENC_A/B GP2/GP3;
STITCH GP10; HEEL GP11; NEEDLE GP12; knee, pedal, FSR, limit ADC0-3; ISENSE ADC4 (GP44); VA, VB ADC5, ADC6; VBUS_S ADC7 (GP47).
3. A2 truth table: PWM high drives (DIR sets the way); PWM low brakes (both outputs low). Its PWM input is pulled low on the board, so a
resetting MCU leaves the motor braked. CS is about 40 mV/A, valid only while driving: sample it mid on-time. No capacitor on CS.
4. R4 lowers A2's current limit from its default ~30 A (100k gives ~16 A); aim for 8-10 A and set it on the bench with the motor stalled.
5. Slow down by braking (PWM low), which spends the energy in the motor's own resistance. Never reverse at speed: that pumps the bus up.
Watch VBUS_S; if it rises past ~28 V, stop driving and fire the brake chopper (Q1, R9), if fitted. D1 only catches short spikes.
6. VA, VB read each motor terminal (/11): their difference is the motor's voltage; with A2 asleep (SLP low) it is the back-EMF, the speed.
7. C19 and two 47n caps from each terminal to the motor case go at the motor; twist the motor leads. PS1 feeds VSYS through D2, as before.
