bobdrzyzgula/VSM-Base/hardware/mcu-controller-rectified/mcu_controller_rectified.kicad_sch

## KiCad design hardware/mcu-controller-rectified/mcu_controller_rectified.kicad_sch (2026-10-28)

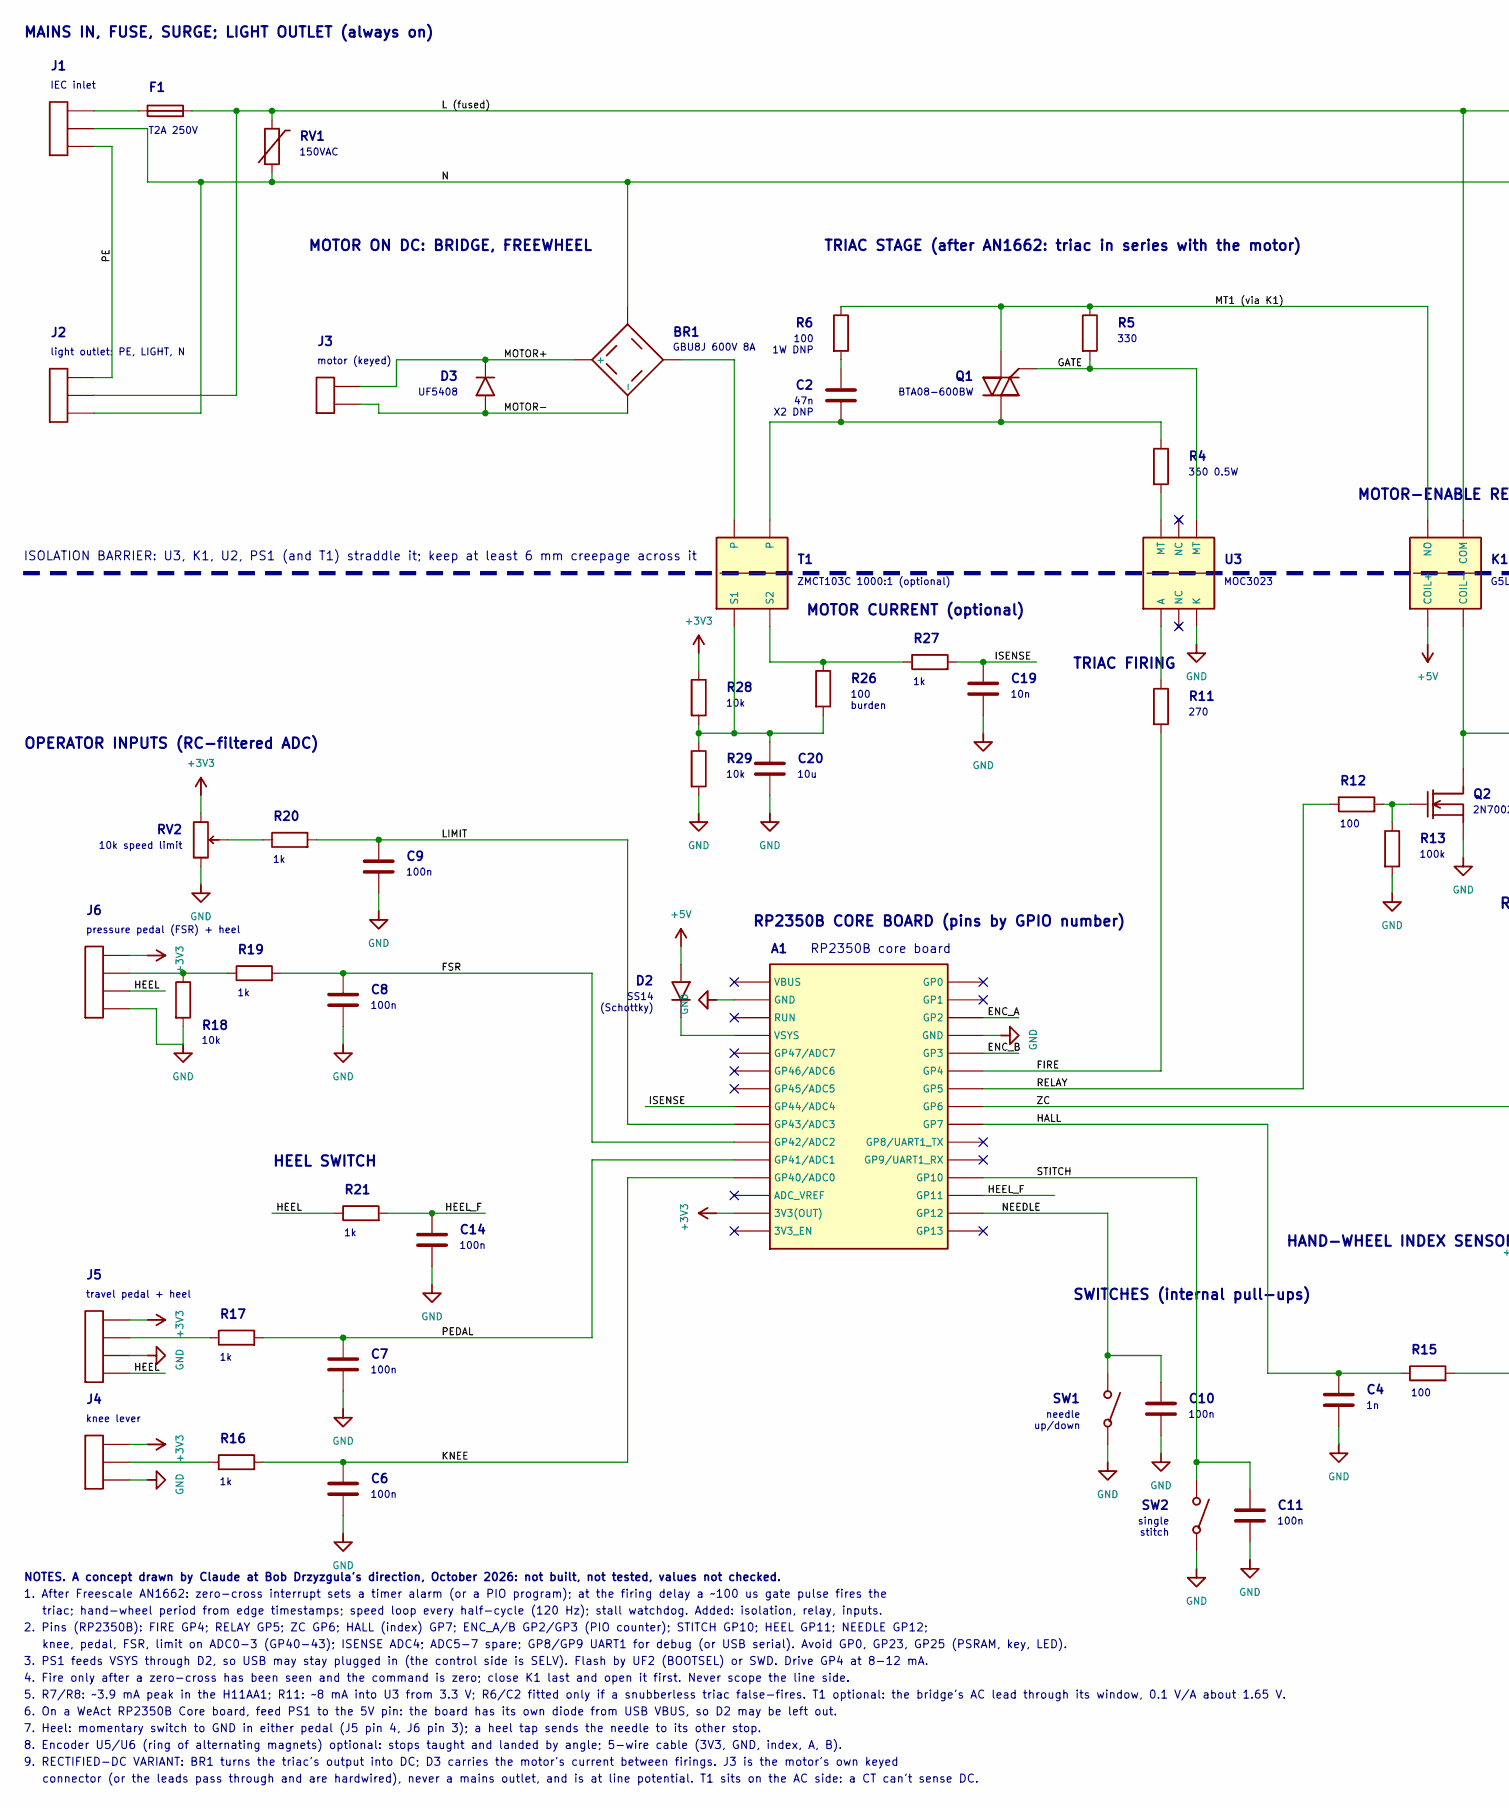
[picture p49: schematic mcu_controller_rectified.kicad_sch, part in row 1, column 1]

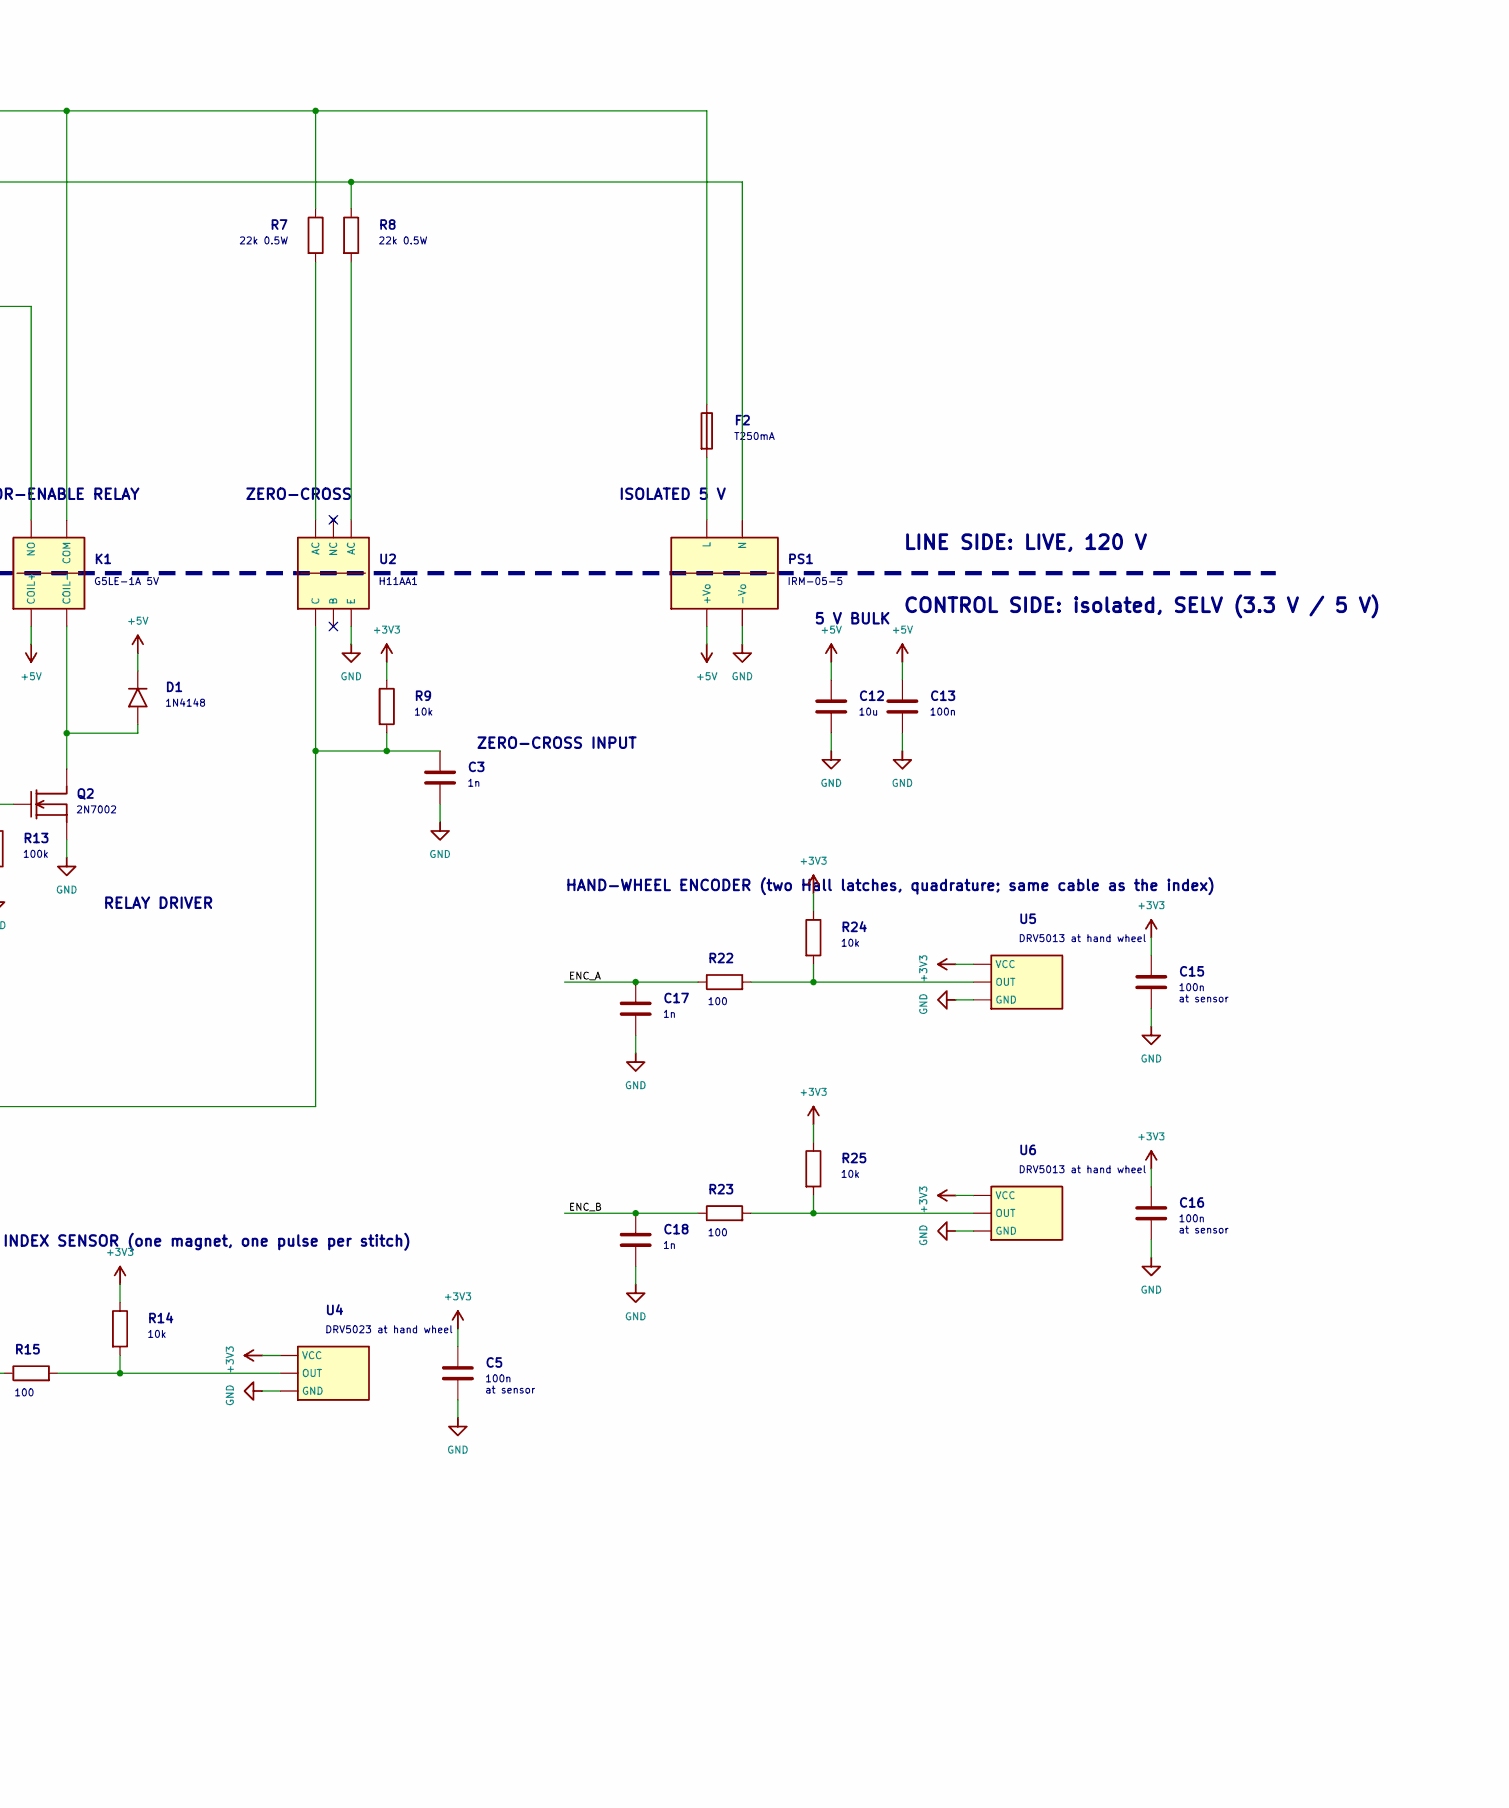
[picture p50: schematic mcu_controller_rectified.kicad_sch, part in row 1, column 2]

Parts:
A1: RP2350B core board
BR1: GBU8J 600V 8A
C2: 47n X2 DNP
C3, C4, C17, C18: 1n
C5, C15, C16: 100n at sensor
C6, C7, C8, C9, C10, C11, C13, C14: 100n
C12, C20: 10u
C19: 10n
D1: 1N4148
D2: SS14 (Schottky)
D3: UF5408
F1: T2A 250V
F2: T250mA
J1: IEC inlet
J2: light outlet: PE, LIGHT, N
J3: motor (keyed)
J4: knee lever
J5: travel pedal + heel
J6: pressure pedal (FSR) + heel
K1: G5LE-1A 5V
PS1: IRM-05-5
Q1: BTA08-600BW
Q2: 2N7002
R4: 360 0.5W
R5: 330
R6: 100 1W DNP
R7, R8: 22k 0.5W
R9, R14, R18, R24, R25, R28, R29: 10k
R11: 270
R12, R15, R22, R23: 100
R13: 100k
R16, R17, R19, R20, R21, R27: 1k
R26: 100 burden
RV1: 150VAC
RV2: 10k speed limit
SW1: needle up/down
SW2: single stitch
T1: ZMCT103C 1000:1 (optional)
U2: H11AA1
U3: MOC3023
U4: DRV5023 at hand wheel
U5, U6: DRV5013 at hand wheel

Connections:
+3V3: A1.L14 (3V3(OUT)), C5.1, C15.1, C16.1, J4.1, J5.1, J6.1, R9.1, R14.1, R24.1, R25.1, R28.1, RV2.1, U4.1 (VCC), U5.1 (VCC), U6.1 (VCC)
+5V: C12.1, C13.1, D1.1 (K), D2.2 (A), K1.1 (COIL+), PS1.3 (+Vo)
ENC_A: A1.R3 (GP2), C17.1, R22.1
ENC_B: A1.R5 (GP3), C18.1, R23.1
FIRE: A1.R6 (GP4), R11.2
FSR: A1.L10 (GP42/ADC2), C8.1, R19.2
GATE: Q1.3 (G), R5.2, U3.4 (MT)
GND: A1.L2 (GND), A1.R4 (GND), C3.2, C4.2, C5.2, C6.2, C7.2, C8.2, C9.2, C10.2, C11.2, C12.2, C13.2, C14.2, C15.2, C16.2, C17.2, C18.2, C19.2, C20.2, J4.3, J5.3, J6.4, PS1.4 (-Vo), Q2.2 (S), R13.2, R18.2, R29.2, RV2.3, SW1.2, SW2.2, U2.4 (E), U3.2 (K), U4.3 (GND), U5.3 (GND), U6.3 (GND)
HALL: A1.R9 (GP7), C4.1, R15.1
HEEL: J5.4, J6.3, R21.1
HEEL_F: A1.R13 (GP11), C14.1, R21.2
ISENSE: A1.L8 (GP44/ADC4), C19.1, R27.2
KNEE: A1.L12 (GP40/ADC0), C6.1, R16.2
L (fused): F1.2, F2.1, J2.2, K1.3 (COM), R7.1, RV1.1
LIMIT: A1.L9 (GP43/ADC3), C9.1, R20.2
MOTOR+: BR1.3 (+), D3.1 (K), J3.1
MOTOR-: BR1.4 (-), D3.2 (A), J3.2
MT1 (via K1): K1.4 (NO), Q1.1 (MT1), R5.1, R6.1
N: BR1.1, J1.2, J2.3, PS1.2 (N), R8.1, RV1.2
NEEDLE: A1.R14 (GP12), C10.1, SW1.1
unnamed: A1.L4 (VSYS), D2.1 (K)
unnamed: BR1.2, T1.1
unnamed: C2.1, R6.2
unnamed: C2.2, Q1.2 (MT2), R4.1, T1.2
unnamed: C20.1, R26.2, R28.2, R29.1, T1.3 (S1)
unnamed: D1.2 (A), K1.2 (COIL-), Q2.3 (D)
unnamed: F1.1, J1.1
unnamed: F2.2, PS1.1 (L)
unnamed: J4.2, R16.1
unnamed: J5.2, R17.1
unnamed: J6.2, R18.1, R19.1
unnamed: Q2.1 (G), R12.2, R13.1
unnamed: R4.2, U3.6 (MT)
unnamed: R7.2, U2.1 (AC)
unnamed: R8.2, U2.2 (AC)
unnamed: R11.1, U3.1 (A)
unnamed: R14.2, R15.2, U4.2 (OUT)
unnamed: R20.1, RV2.2 (W)
unnamed: R22.2, R24.2, U5.2 (OUT)
unnamed: R23.2, R25.2, U6.2 (OUT)
unnamed: R26.1, R27.1, T1.4 (S2)
PE: J1.3, J2.1
PEDAL: A1.L11 (GP41/ADC1), C7.1, R17.2
RELAY: A1.R7 (GP5), R12.1
STITCH: A1.R12 (GP10), C11.1, SW2.1
ZC: A1.R8 (GP6), C3.1, R9.2, U2.5 (C)

Notes on the sheet:
IEC inlet
T2A 250V
RV1
150VAC
light outlet: PE, LIGHT, N
motor (keyed)
BR1
GBU8J 600V 8A
UF5408
BTA08-600BW
360 0.5W
330
100
1W DNP
47n
X2 DNP
22k 0.5W
T250mA
MOC3023
G5LE-1A 5V
H11AA1
PS1
IRM-05-5
ZMCT103C 1000:1 (optional)
R11
270
2N7002
1N4148
R12
R13
100k
10k
C12
10u
C13
100n
RP2350B core board
SS14
(Schottky)
R15
R14
DRV5023 at hand wheel
at sensor
R26
burden
R27
C19
10n
R28
R29
C20
SW1
needle
up/down
C10
SW2
single
stitch
C11
RV2
10k speed limit
R20
pressure pedal (FSR) + heel
R18
R19
travel pedal + heel
R17
knee lever
R16
R21
C14
C17
R22
R24
DRV5013 at hand wheel
C15
C18
R23
R25
C16
LINE SIDE: LIVE, 120 V
CONTROL SIDE: isolated, SELV (3.3 V / 5 V)
ISOLATION BARRIER: U3, K1, U2, PS1 (and T1) straddle it; keep at least 6 mm creepage across it
MAINS IN, FUSE, SURGE; LIGHT OUTLET (always on)
MOTOR ON DC: BRIDGE, FREEWHEEL
TRIAC STAGE (after AN1662: triac in series with the motor)
MOTOR-ENABLE RELAY
ZERO-CROSS
ISOLATED 5 V
RELAY DRIVER
ZERO-CROSS INPUT
TRIAC FIRING
5 V BULK
MOTOR CURRENT (optional)
RP2350B CORE BOARD (pins by GPIO number)
HAND-WHEEL INDEX SENSOR (one magnet, one pulse per stitch)
HAND-WHEEL ENCODER (two Hall latches, quadrature; same cable as the index)
HEEL SWITCH
SWITCHES (internal pull-ups)
OPERATOR INPUTS (RC-filtered ADC)
NOTES. A concept drawn by Claude at Bob Drzyzgula's direction, October 2026: not built, not tested, values not checked.
1. After Freescale AN1662: zero-cross interrupt sets a timer alarm (or a PIO program); at the firing delay a ~100 us gate pulse fires the
triac; hand-wheel period from edge timestamps; speed loop every half-cycle (120 Hz); stall watchdog. Added: isolation, relay, inputs.
2. Pins (RP2350B): FIRE GP4; RELAY GP5; ZC GP6; HALL (index) GP7; ENC_A/B GP2/GP3 (PIO counter); STITCH GP10; HEEL GP11; NEEDLE GP12;
knee, pedal, FSR, limit on ADC0-3 (GP40-43); ISENSE ADC4; ADC5-7 spare; GP8/GP9 UART1 for debug (or USB serial). Avoid GP0, GP23, GP25 (PSRAM, key, LED).
3. PS1 feeds VSYS through D2, so USB may stay plugged in (the control side is SELV). Flash by UF2 (BOOTSEL) or SWD. Drive GP4 at 8-12 mA.
4. Fire only after a zero-cross has been seen and the command is zero; close K1 last and open it first. Never scope the line side.
5. R7/R8: ~3.9 mA peak in the H11AA1; R11: ~8 mA into U3 from 3.3 V; R6/C2 fitted only if a snubberless triac false-fires. T1 optional: the bridge's AC lead through its window, 0.1 V/A about 1.65 V.
6. On a WeAct RP2350B Core board, feed PS1 to the 5V pin: the board has its own diode from USB VBUS, so D2 may be left out.
7. Heel: momentary switch to GND in either pedal (J5 pin 4, J6 pin 3); a heel tap sends the needle to its other stop.
8. Encoder U5/U6 (ring of alternating magnets) optional: stops taught and landed by angle; 5-wire cable (3V3, GND, index, A, B).
9. RECTIFIED-DC VARIANT: BR1 turns the triac's output into DC; D3 carries the motor's current between firings. J3 is the motor's own keyed
connector (or the leads pass through and are hardwired), never a mains outlet, and is at line potential. T1 sits on the AC side: a CT can't sense DC.
