bobdrzyzgula/VSM-Base/hardware/triac-board/KB3151C.kicad_sch

## KiCad design hardware/triac-board/KB3151C.kicad_sch (2026-10-19)

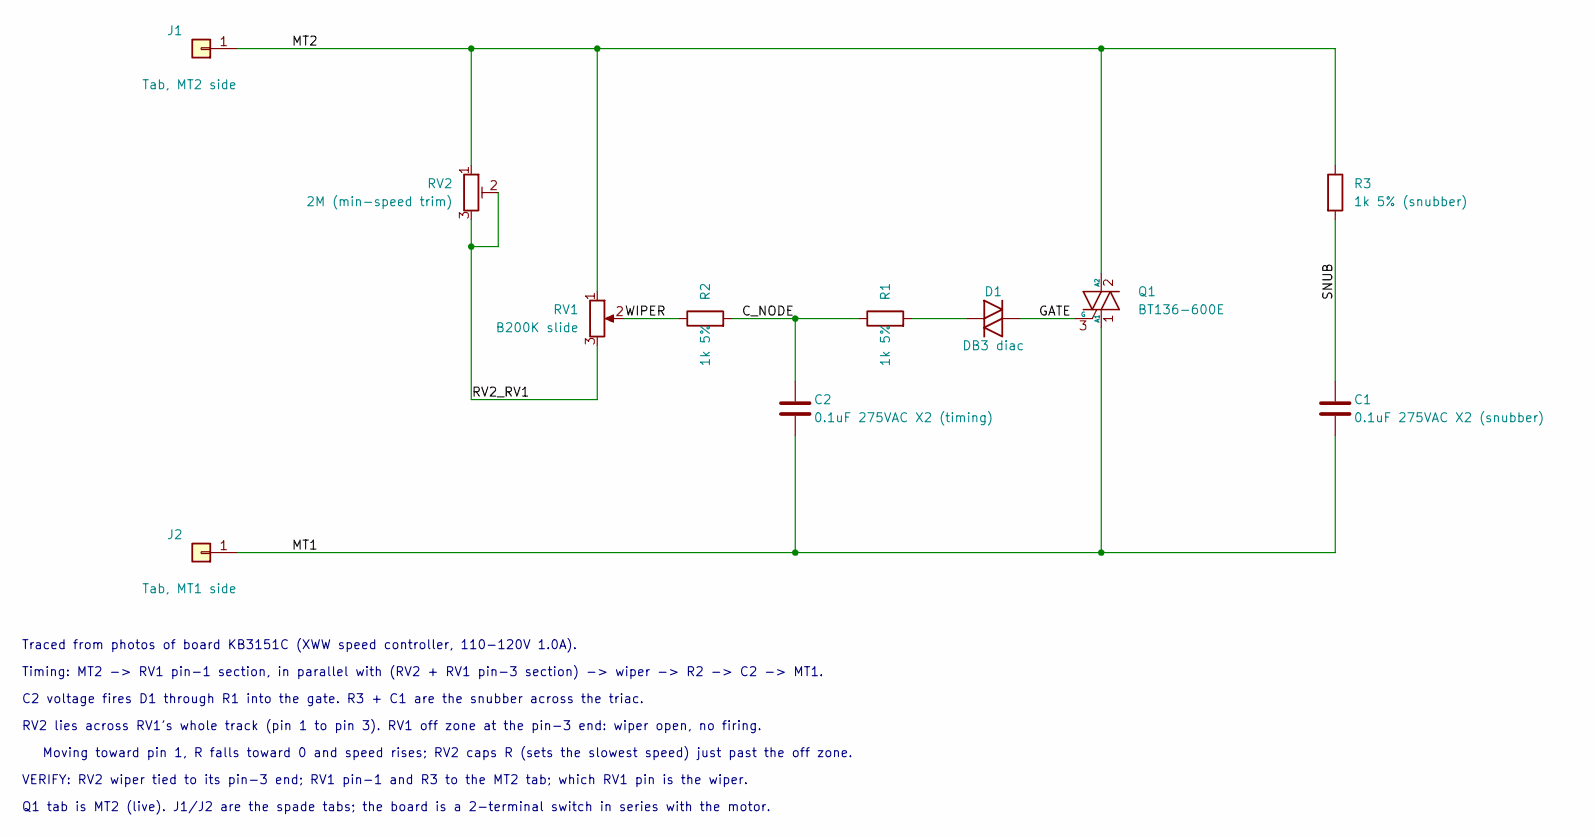
[picture p51: schematic KB3151C.kicad_sch]

Parts:
C1: 0.1uF 275VAC X2 (snubber)
C2: 0.1uF 275VAC X2 (timing)
D1: DB3 diac; D_DO-35_SOD27_P7.62mm_Horizontal
J1: Tab, MT2 side
J2: Tab, MT1 side
Q1: BT136-600E; TO-220-3_Vertical
R1, R2: 1k 5%; R_Axial_DIN0207_L6.3mm_D2.5mm_P10.16mm_Horizontal
R3: 1k 5% (snubber); R_Axial_DIN0207_L6.3mm_D2.5mm_P10.16mm_Horizontal
RV1: B200K slide
RV2: 2M (min-speed trim); Potentiometer_Piher_PT-10-H01_Horizontal

Connections:
C_NODE: C2.1, R1.1, R2.2
GATE: D1.2 (A), Q1.3 (G)
MT1: C1.2, C2.2, J2.1, Q1.1 (A1)
MT2: J1.1, Q1.2 (A2), R3.1, RV1.1, RV2.1
unnamed: D1.1 (K), R1.2
RV2_RV1: RV1.3, RV2.2, RV2.3
SNUB: C1.1, R3.2
WIPER: R2.1, RV1.2

Notes on the sheet:
Traced from photos of board KB3151C (XWW speed controller, 110-120V 1.0A).
Timing: MT2 -> RV1 pin-1 section, in parallel with (RV2 + RV1 pin-3 section) -> wiper -> R2 -> C2 -> MT1.
C2 voltage fires D1 through R1 into the gate. R3 + C1 are the snubber across the triac.
RV2 lies across RV1's whole track (pin 1 to pin 3). RV1 off zone at the pin-3 end: wiper open, no firing.
Moving toward pin 1, R falls toward 0 and speed rises; RV2 caps R (sets the slowest speed) just past the off zone.
VERIFY: RV2 wiper tied to its pin-3 end; RV1 pin-1 and R3 to the MT2 tab; which RV1 pin is the wiper.
Q1 tab is MT2 (live). J1/J2 are the spade tabs; the board is a 2-terminal switch in series with the motor.
