bobdrzyzgula/VSM-Base/(commit log)

2026-10-17 VSM Base v23: parametric hinged base for vintage flatbed sewing machines
    Model (scad/vsm_base.scad), README, MIT license, User's Guide sources and
    PDF, parameter reference, build tools and images.
    Claude-Session: https://claude.ai/code/session_01D8rC2JDyb9T3n3ujD2pgX4
    [vsm_base.scad]
2026-10-17 VSM Base v24: organizer inserts
    Bobbin trays for the corner bay (a second stack goes in the freestanding
    corner box); notion trays for the back or left bay in 30-10 mm and custom
    heights, plain or compartmented; a spool tray. Merged from the inserts
    kit, with the kit's corner box dropped in favor of v19's, Customizer
    ranges on the new settings, the bed check using printer_margin, and a
    missing-bay message that names make_*_box.
    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
    [vsm_base.scad]
2026-10-17 VSM Base v25: extended back lip, outlet labels, split test
    - The back lip runs on past a short back extension, over the base's back
    rim, to reach the last back peg hole: same thickness, free end rounded
    in plan, free top edges rounded, square on the seat line, a plan fillet
    into the body's right wall. Never past the base's right end; the fit
    check and the print plates use the longer footprint.
    - LIGHT and MOTOR recessed into the outlet compartment floor by their
    receptacles (LIGHT at the back by default).
    - Part split_test: the front of the split joint, serrations and first
    dovetail, with 30 mm wall stubs (split_test_h; 0 = full height).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
    [vsm_base.scad]
2026-10-17 Guide as release documents: HTML build, release workflow
    - make html: the guide as one self-contained HTML page (images embedded,
    contents column on wide screens, light and dark), with its stylesheet.
    - make docs builds the PDF and HTML into build/ (ignored); VERSION labels
    the title page.
    - The generated PDF is no longer kept in the repository. A version tag
    (v*) builds both documents and attaches them, with the model, to a
    GitHub release; a manual run builds them as a workflow artifact.
    - README points to the releases and the Markdown chapters.
    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
2026-10-17 Release workflow: current checkout and upload-artifact actions
    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
2026-10-18 VSM Base v26: knee controller (draft)
    compartment_option = "knee": a knee bar turns an 8 mm shaft running front
    to back in the right bay, in two flanged bronze bushings (front wall and a
    new bulkhead). A gear sector on the shaft drives a pinion on a Bourns
    91A1A-B28-A25L pot that replaces the donor board's slide pot; the pinion
    is generated by rolling it against the sector (undercut, backlash). A
    blade on the sector holds an Omron SS-5GL off switch open at rest, on
    adjusting slots. Hard stops are a pin in the front face running in an arc
    slot in the hub, so the knee's force bypasses the shaft and gears.
    Board posts (screw boss, peg, rest post), printed board cover, mains
    cord slot with clam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
    [vsm_base.scad]
2026-10-18 VSM Base v27: knee controller power options, board fixes
    - knee_power: "cordset" (default) takes a standard pedal controller
    cordset: its molded entry through a 13.9 x 8.5 mm hole in a 4.4 mm wall
    pocketed into the right end wall above the handhold, with the dimple for
    its steel clip; "iec" a fused Schurter KE C14 inlet on its side in a
    2 mm panel above the board cover, with three Wago 221-413 connectors in
    a cradle under the bed beside the pass-through, and an earth post for a
    spring strip on the shaft's end; "bare" the v26 cord slot and clamp.
    - Board posts corrected for handedness and set from the measured board
    (screw 49.6 along, 12.5 across); board turned end for end by de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
    [vsm_base.scad]
2026-10-18 VSM Base v28: knee return spring and switch actuating point
    - Return spring chosen: McMaster 9271K585 (left-hand, knee pushing right)
    or 9271K651 (right-hand, pushing left); its torque at rest and at the
    stop, the knee force, and its wound-up inside diameter in the console,
    with warnings. The sector's leg hole sized from its wire.
    - Switch actuating point from Omron's drawing: 14.5 mm from the lever's
    pivot end, 5.3 mm from its free end.
    - Guide: the spring and its wind direction, the switch's actuating point.
    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
    [vsm_base.scad]
2026-10-18 Docs: the motor speed-control paper, as Markdown source
    - docs/motor-control/: "Speed Control of Universal Motors in Sewing
    Machines", rebuilt from the October 2026 PDF as Markdown sections with
    typeset equations and links, and a new closing section on the two
    controller designs for the base: the knee controller around a
    repurposed pedal triac board (as built in the model), and the MCU phase
    controller in design.
    - The speed-versus-load chart regenerated from the paper's model as SVG
    (tools/make_speed_chart.py, run by make images).
    - make docs builds the paper as PDF and HTML beside the guide (HTML math
    as MathML); the release workflow attaches both.
    - README and the guide's kn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
2026-10-19 v29: knee controller reworked to the measured Singer feel
    About 1 lb at rest rising 1.5 lb/in, an inch of dead travel before the
    motor starts, full speed at 2" and a hard stop at 2.25". The return
    spring is now a compression spring in a housing on the front face, pushed
    by a crank on the knee hub, with steel M4 screw stops for rest and full
    travel, so the knee's force stays out of the shaft, set screws and gears.
    Two-stage gearing (about 11.75:1, linear in resistance as a placeholder)
    through an idler on a stub pin; the switch lies under the shaft, worked by
    a cam on the sector. New parts knee_idler, knee_spring_housing and
    knee_spring_cap; the stop pin and torsion spring are gone. Guide cha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
    [vsm_base.scad]
2026-10-19 Triac board schematic: KiCad source and a figure in the paper
    The KB3151C donor board, traced from photos, as a KiCad 7 schematic in
    hardware/triac-board/. Its notes corrected: RV2 lies across RV1's whole
    track (not in series at its pin-3 end), as the netlist shows. The paper's
    section on the repurposed pedal board gets the schematic as a figure,
    exported and cropped by tools/export_schematic.sh, which make images runs.
    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
    [KB3151C.kicad_sch]
2026-10-19 Paper: schematic figure cropped to the circuit, notes in the caption
    The tab labels on the sheet sit closer to their connectors so the figure
    can be cropped to the circuit alone; the notes stay on the KiCad sheet and
    are carried in the figure's caption.
    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
    [KB3151C.kicad_sch]
2026-10-19 README and guide: say up front what has been tested
    Only the default build (Singer 99K, split, storage compartment, all three
    extensions and lids) and the insert test parts and first bobbin trays have
    been printed and used; everything else is marked untested.
    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
2026-10-19 Guide: photo of the full bobbin stack; status updated
    All five bobbin trays are printed and in use.
    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
2026-10-19 Standalone bobbin box, a self-contained model of the corner box and trays
    standalone/bobbin-box/ holds bobbin_box.scad, a README and a render. The
    guide and README mention it, and list it among the untested builds.
    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
    [bobbin_box.scad]
2026-10-19 VSM Base v30: organizer trays from the first prints
    Compartment trays default to a 2" target cell (2 x 4 in the back or left
    bay). Small gussets at the foot of the long walls of every notion tray and
    the spool tray's curbs, where a thin wall meets the floor at one layer
    line; on the spool tray they sit in the gaps between spools and are
    checked clear of them. The spool tray's curb is 14 mm (was 10) to stiffen
    its floor. Guide note and status updated.
    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
    [vsm_base.scad]
2026-10-19 Motor test rig: models and guide, from the controller work
    hardware/motor-rig/ holds the rig's OpenSCAD files (layout, drilling
    template, cradle, Prony brake and modules), its guide, a layout preview and
    the 1:1 template. It shares the triac board's schematic in
    hardware/triac-board/ rather than carrying a copy, and STLs are left to be
    exported. Cross-linked from the README, the triac board's README and the
    paper; listed as untested.
    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
    [motor_cradle.scad, motor_rig.scad, prony_brake.scad]
2026-10-20 Release workflow: attach the standalone bobbin box; alpha note
    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
2026-10-20 VSM Base v31: the small compartment as an attached bay
    compartment_mount = "attached" makes the compartment its own part,
    right_bay, screwed to the base's right end: four M5 socket-head screws from
    inside the machine cavity into heat-set inserts in the bay's inner wall,
    and two 3/16" dowels, with the bay's top flush with the base's. The bay
    carries its own handhold and harness rods; the base keeps a handhold, rods
    and its right-rim peg holes. Storage only for now (asserted); lid defaults
    to none (attached_lid_type). Part attach_test for the joint. Console lines
    for the joint, with a check against right-edge casting reliefs; rod counts
    follow the number of ends. Built-in bases are unchanged.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
    [vsm_base.scad]
2026-10-20 VSM Base v32: hinge nut tool; status from the hinge and peg tests
    Part hinge_nut_tool: a handle and a round shaft that passes the hex nut
    trap, with a tapered tip for the nut's bore (1/8" for a nylon-insert
    locknut, hinge_nut_tool_tip), to hold a nut at its seat from below while
    the screw is started from above. Guide assembly note. Status: the lollipop
    hinges mounted with #8-32 screws and locknuts, the printed extension pegs,
    and the mending plates' fit are tested.
    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
    [vsm_base.scad]
2026-10-20 VSM Base v33: hinge_type none
    A base for a machine to sit in, without hinges: no hinge recesses, nut
    traps, checks, hardware or hinge test parts (hinge coupon, hinge block, nut
    tool); the back-wall tunnels run the whole back wall. The back rim keeps the
    lollipop hinge's width unless back_rim_width is set, so extensions are the
    same either way. A console note on carrying and reaching the cavity; guide
    notes in Measuring and Configuring; listed as untested.
    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
    [vsm_base.scad]
2026-10-20 Standalone nut tool, configurable by nut size, shaft and length
    standalone/nut-tool/ holds nut_tool.scad (self-contained, no libraries),
    a README and a render. Presets for #4-40 to 1/4-20 and M3 to M6, or custom
    across-flats and tip; shaft diameter and length, tip length and taper,
    handle, and a count. Linked from the README and the guide's assembly note.
    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
    [nut_tool.scad]
2026-10-20 VSM Base v34: printed hinge
    hinge_type "printed": a printed arm carries a steel pin into the bed's
    hinge hole and turns on a steel pivot rod pressed into a printed block's
    cheeks; the block sits in a square recess in the back rim on the hinge
    screw and nut trap. The pivot is set at the bed hole's height from the
    measurements. A stop face on the block's back wall holds the machine at
    ph_stop_angle (60 by default) when tilted back. New parts printed_hinges
    (two arms and two blocks, in print orientation), printed_hinge_test (pin
    and pivot press-fit series and the running fit) and printed_hinge_view;
    the hinges show in the assembly, the hinge coupon follows the hinge type,
    and the back extension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
    [vsm_base.scad]
2026-10-20 VSM Base v35: Kenmore 158.14001; flush beds, feet, recessed lips, cord slot
    Printed hinge: the stop is now a tail on the arm behind the pivot that
    lands in a pocket in the block, so nothing stands above the arm; the
    block is held by a screw driven up through the base's trap into a nut
    pressed into its underside; the arm and cheeks are cut flush with the
    rim where ph_min_cover (2.5 mm) allows. Pin diameter and engagement come
    from the machine profile (ph_pin_d, ph_pin_engage = 0).
    Machine profiles gain hinge_pin_d_mm, hinge_pin_engage_mm, bed_flush,
    foot_height_mm and cord_slot (and Custom equivalents). A flush bed's top
    sits level with the rim; a machine on its feet sets the floor from them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
    [vsm_base.scad]
2026-10-20 VSM Base v36: foot-locating rig
    Parts foot_rig_left and foot_rig_right: a thin box rig_height (80 mm)
    tall that fits round the bed of the profile in use, with a floor rim
    under the bed's edges and an open bottom, to stand the machine on inked
    paper and find its feet. Six marking holes 5 mm in from the bed's edges,
    screw holes for a board, splice tabs bolted with M3, and a cord notch
    where the profile has a cord slot. Guide: measuring chapter.
    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
    [vsm_base.scad]
2026-10-20 VSM Base v37: floor bars across the foot rig
    Floor bars rig_bar_in (100 mm) in from each end of the bed, with a
    stiffening rib, to keep each half of the foot-locating rig square; the
    split bar stays optional. From Bob's first print, which warped.
    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
    [vsm_base.scad]
2026-10-20 VSM Base v38: foot rig breakaway tie and mouse ears
    A tie across each half's open end at the split, joined to the floor rims
    by thin necks so it snaps off before the halves are bolted together, and
    mouse ears at each half's corners, both against warping on the printer.
    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
    [vsm_base.scad]
2026-10-20 VSM Base v39: profile found by the start of its name
    The Customizer menu shows "Kenmore 158", and a profile is found by its
    full name or the start of it, since the Customizer may rewrite numbers in
    menu entries ("Kenmore 158.14001" fell back to the Custom settings in
    the GUI). The not-found warning lists the profiles. Foot rig ears off by
    default, for slicers that grow brims round them.
    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
    [vsm_base.scad]
2026-10-20 VSM Base v40: Kenmore profile named 158-14001
    The Customizer's menu reads a decimal number in an entry as a number and
    prints it to six figures (158.14001 became 158.14), so the profile is
    named with a dash; names with a dash survive as a single word. Profiles
    are still found by the start of the name.
    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
    [vsm_base.scad]
2026-10-20 VSM Base v41: printed-hinge coupon as deep as the base's trap
    The hinge coupon for the printed hinge is now as deep as the base's screw
    trap, so the console's screw (1/2" #8-32) serves in it as in the base,
    its head under the coupon, instead of bottoming in the block's blind
    hole. Console wording for the screw's length fixed.
    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
    [vsm_base.scad]
2026-10-20 Guide: note on infill near the hinges
    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
2026-10-21 VSM Base v42: Customizer presets for each machine profile
    scad/vsm_base.json holds a preset per profile, "<profile> (as Custom)",
    setting machine = Custom and every Custom machine setting from that
    profile, to start a Custom machine from a known one. Built by
    tools/make_presets.py (make presets), which keeps presets saved in the
    Customizer. The console prints profile values to 8 decimals so the
    presets build the same base as their profiles. Guide: configuring note.
    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
    [vsm_base.scad]
2026-10-21 VSM Base v43: plates in the all view never overlap; header version
    In part all, each plate is laid out as wide as the bed or its widest part,
    so a base printed whole (split = false) no longer runs into the next
    plate (it overlapped the corner piece). The header names the model VSM
    Base and gives the current version again (it had stopped at 33).
    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
    [vsm_base.scad]
2026-10-21 VSM Base v44: part tools
    A render option for the things printed to help build or measure, apart
    from test_parts (pieces of the base for trying fits): the hinge nut tool,
    the printed hinge's rod-fit test, and the foot rig's two halves, in a
    row. Guide: test-parts chapter.
    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
    [vsm_base.scad]
2026-10-21 Docs: development builds carry the model's version
    The guide's and the paper's title pages say "Development Build vNN",
    NN read from the model's header, when built without VERSION; release
    builds still say "Version X". Model header to v45 (no model changes).
    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
    [vsm_base.scad]
2026-10-21 Docs: mending plate screws tested; plate photos
    The plates, their 1/2" #8-32 flat-head screws and nylon-insert locknuts
    are tested (the screws push through the traps' membranes). Two of Bob's
    photos in the assembly chapter; README hardware lists locknuts.
    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
2026-10-21 Guide: tape over the plate nuts before turning the base over
    From Bob's assembly of the plates.
    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
2026-10-21 VSM Base v46: printed hinge nut in a slot from the block's front
    The nut slides into a slot from the block's front face with 2.5 mm of
    plastic under it, so the screw from below clamps the block; in the open
    pocket underneath it was drawn out, clamping nothing. The recess's front
    wall closes the slot. Screw now #8-32 x 5/8". From Bob's review of the
    printed parts. Guide: configuring and assembly.
    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
    [vsm_base.scad]
2026-10-21 VSM Base v47: rod-fit test marked with a plus; step a setting
    A plus instead of a dash over the sixth (running-fit) hole, which reads as
    the loose end rather than a minus. The step between the five press-fit
    holes is ph_test_step (0.1 mm; finer for a second bar). Guide: test-parts
    chapter explains the sixth hole. From Bob's use of the part.
    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
    [vsm_base.scad]
2026-10-21 VSM Base v48: arrow on the printed hinge arm's bottom face
    The arm isn't symmetrical top to bottom; an arrow engraved in its bottom
    face points to the pin. Guide: assembly. From Bob's assembly.
    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
    [vsm_base.scad]
2026-10-21 VSM Base v49: printed hinge stops at 100 degrees, like a lollipop
    From Bob's measurements of a 99K on lollipop hinges: the knuckle stops it
    at about 100 degrees, servicing wants about 90, the balance point is about
    55, and the base tips up beyond. The stop moves from 60 to 100 degrees;
    since the base tips first, the stop's load stays a few N.m. Block size
    unchanged; sweep clear of the base. Guide: the stop paragraph, and the
    hinge picture at 100 degrees.
    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
    [vsm_base.scad]
2026-10-21 VSM Base v50: tilt prop
    Part tilt_prop, also in tools: a stand on the table behind the base whose
    cradle (1" radius, 1.5" wide on the 99K) catches the machine's arm
    tipped back to 90 degrees, 6" above the table, for servicing with both
    hands; the weight goes into the table rather than tipping the base.
    Profile key tilt_prop_mm (and custom_tilt_prop_mm), overridable by
    tilt_prop_h and tilt_prop_r. Measurements from Bob. Guide: configuring
    and test parts; presets rebuilt.
    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
    [vsm_base.scad]
2026-10-21 VSM Base v51: tilt prop opened into two legs
    A gabled window through the prop's post, leaving two tapered legs front
    and back joined at the foot and the cradle; prints without a bridge, and
    with less than half the plastic. Bob's suggestion.
    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
    [vsm_base.scad]
2026-10-21 VSM Base v52: tilt prop with a flat top
    For machines without a round arm, a profile cradle radius of 0, or
    tilt_prop_top = "flat", gives the prop a flat, level top (tilt_prop_flat
    deep); tilt_prop_top = "cradle" forces the cradle. Bob's suggestion.
    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
    [vsm_base.scad]
2026-10-21 VSM Base v53: outlet cords out through the walls
    outlet_cord_exit: lid (as before), front_rear (power cord out the back
    wall, controller cord out the front), or rear (both out the back, the
    controller cord in a floor channel from in front of the outlet round a
    180-degree bend and back along the divider, with retention lips on
    alternate sides). Wall slots from the top down to the cords; part
    outlet_trims fills each above its cord, flush with rim and lid ledge,
    with an eased opening. Lid slots off with wall exits; the back-wall
    tunnel stops short of the slots; labels move beside the channel. Default
    and lid-exit builds unchanged. Guide: configuring, printing, assembly.
    Design from Bob.
    Co-Aut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
    [vsm_base.scad]
2026-10-21 VSM Base v54: outlet cords leave 1/8" up from its back; labels fit
    From Bob's outlet: the cords leave its ends at the centre, 1/8" up from
    its back (the end-wall side), so the cord's centre is taken 4.7 mm in
    from the back; slots beside the end wall sit flush with it. The channel's
    bend is as wide as the room in front of the outlet allows (27 mm on the
    99K), the run back placed where it falls. Label widths measured (bold
    capitals about one letter height each); beside the channel the labels
    shrink to fit. Lid-exit outlet build unchanged.
    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
    [vsm_base.scad]
2026-10-21 VSM Base v55: printed hinge rods from stock dowel pins
    ph_pin_len: a stock pin's length; it goes into the bed's hole by what is
    left past the arm. ph_pivot_len: a stock pivot's length; the block's
    cheeks follow. Profile key hinge_hole_depth_mm (Kenmore 22, measured by
    Bob; 99K not measured) bounds the pin; the console gives the lengths that
    fit (Kenmore 30.5-43 mm; a 6 x 40 mm pin goes 17.5 mm in) and warns
    outside them. Sweep clear of the base; 99K base unchanged. Guide:
    configuring and measuring.
    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
    [vsm_base.scad]
2026-10-21 VSM Base v56: compartment_test part
    The base's right end, from 3 mm left of the divider (so both ends of the
    pass-through and their knock-out walls) to the end wall with its handhold
    and harness rods, for building and trying a built-in compartment by
    itself; warns with an attached bay (print right_bay). Guide: test parts.
    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
    [vsm_base.scad]
2026-10-21 Standalone tilt prop
    standalone/tilt-prop/: the tilt prop as a self-contained model with no
    machine settings: height; a cradle (radius, width) or a flat top (width x
    length); a slope about the width axis; a foot sized so a load on the top
    can lean a further stability_angle (15 degrees) before tipping it. Two
    tapered legs with a gabled opening; prints without supports. README with
    a render; linked from the main README and the guide. The release
    workflow attaches the standalone nut tool and tilt prop with the bobbin
    box.
    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
    [tilt_prop.scad]
2026-10-22 v57: separate arm pin press fit; gabled, eased hinge nut slot
    ph_pin_press sets the arm's pin-hole fit apart from ph_press (now the
    block's pivot holes only); the fit-test bar steps each around its own
    setting. The block's nut slot ceiling is raised 0.4 mm and chamfered at
    45 degrees as far as the block allows (about 1.9 mm, leaving a 5 mm
    bridge instead of 9), and its mouth is eased.
    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
    [vsm_base.scad]
2026-10-22 v58: round head counterbore under the printed hinge
    With the nut now in the block, the screw comes up from under the base;
    its way in is a round counterbore for a pan or socket head (ph_head_d,
    9.5 mm for #8) instead of a hex trap. The hinge coupon follows, with no
    membrane on its bottom. The lollipop hinge keeps its nut trap.
    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
    [vsm_base.scad]
2026-10-22 v59: Singer 99K hinge holes are 22 mm deep
    Measured; the printed hinge's pin lengths are now bounded on the 99K too
    (30.5 to 43 mm).
    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
    [vsm_base.scad]
2026-10-22 Guide: correct the 1/4 x 1 1/2 inch pin's reach
    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
2026-10-22 v60: corner piece bins for larger extensions
    Left extension width and back extension depth are now at least 100 mm.
    The corner's bobbin bin keeps the size a 100 mm corner gives, in the
    inner corner; extra width or depth becomes open bins to its left and
    behind it, with 2.5 mm dividers under the one lid (corner_layout: 2x2,
    long left, long back; strips under ext_bin_min stay solid). The bins are
    listed in compartments. corner_bay_square is retired.
    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
    [vsm_base.scad]
2026-10-22 v61: bins in all extensions, double-bin sizing, finger notches
    The left and back extensions keep the bay a 100 mm piece gives; their
    extra width or depth becomes an outer bin, whole or split in two along
    its length (left_ext_layout, back_ext_layout: 1+1, 1+2). left_ext_double
    and back_ext_double size the width or depth so the outer bins match the
    inner ones in the corner and its neighbour; the larger need wins and the
    other piece's bin is walled to size. Dividers under a single lid get a
    U-shaped finger notch at the middle (ext_divider_notch).
    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
    [vsm_base.scad]
2026-10-22 v62: per-bay extension lids
    back_lids, left_lids, corner_lids = per bay: each bay gets its own lid
    rabbet, the bays spaced for a ledge either side of an ext_frame rib, and
    the dividers taper at 45 degrees under the ledges to ext_divider at the
    floor. The inner bay's lid keeps its piece's settings; the outer bins'
    lids share bin_lid_type and bin_lid_hinge, sized finger holes; bins under
    bin_lid_min get no lid, and hinged bin lids too small to hinge become
    lift-out. New part bin_lids; the lids go on the print plates. Custom
    profile defaults now match the 99K's hinge hole depth and tilt prop.
    Claude-Session: https://claude.ai/code/session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
    [vsm_base.scad]
2026-10-22 v63: extensions_view part; guide renders of larger extensions
    New view part extensions_view (the extension pieces in place, lids lifted
    by explode). Two renders in the guide: larger extensions with one lid
    each and finger-notched dividers, and with a lid per bay.
    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
    [vsm_base.scad]
2026-10-22 v64: printed hinges in the exploded view, with a guide render
    The exploded view takes each printed hinge apart over its recess: block
    lifted, arm above, pin drawn out of the arm's front, pivot rod out to the
    side. New render printed-hinge-exploded in the configuring chapter.
    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
    [vsm_base.scad]
2026-10-22 Build the motor test rig's guide as a PDF
    make pdf now also builds build/vsm-motor-rig.pdf from
    hardware/motor-rig/RIG_GUIDE.md, labelled like the other two documents.
    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
2026-10-22 Release: attach the motor test rig's guide
    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
2026-10-22 Draft MCU phase-controller schematic
    hardware/mcu-controller/: a KiCad 7 schematic of the feedback controller
    in the motor-control paper, after Freescale AN1662 with an isolated
    control side: IEC inlet, fuse, MOV, motor-enable relay, snubberless triac
    fired by a MOC3023, H11AA1 zero-cross, isolated 5 V module, NUCLEO-G431KB,
    hand-wheel Hall sensor, knee/pedal/FSR/limit inputs and two switches.
    Generated by tools/make_mcu_schematic.py (self-contained symbols, label
    connections); README with pin use, firmware outline and cautions.
    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
    [mcu_controller.kicad_sch]
2026-10-22 MCU controller concept: wired schematic, and its write-up in the paper
    The schematic is redrawn with wires: the isolation barrier runs across
    the sheet, the line side above it with L and N rails, the four parts
    that span it (MOC3023, relay, H11AA1, 5 V module) on it, and the control
    side below, with the Nucleo's signals wired to their blocks. Power rails
    use ports. The generator now places and wires parts, splits wires and
    adds junctions; tools/check_mcu_netlist.py confirms KiCad's netlist
    matches the intended one. Pins re-assigned for a clean layout (RELAY D4,
    ZC D5, NEEDLE D11).
    The motor-control paper's section 11 gains 'A first concept circuit',
    with the disclaimer that it is a concept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
    [mcu_controller.kicad_sch]
2026-10-23 v65: standard base depths and extension height
    base_depth: 200, 230 or 250 mm (auto, the smallest that fits), the spare
    in the back rim. No-hinge builds start from a 12 mm back rim
    (back_rim_thin). Extensions stand at ext_height (88.225 mm, the 99K's bed
    top) with the same bays: a lower bed raises the base by thickening its
    floor (the Kenmore by 3.9 mm); a higher one stands the extensions on
    podiums (new parts back_podium, left_podium, corner_podium) at least
    podium_min thick, pinned with rod. Back pegs standard at X 16 and 160,
    clear of hinges and splits on both machines. back_rim_width,
    ext_standard and back_ext_length override, with console notes.
    The default 99K base is now 230 mm deep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
    [vsm_base.scad]
2026-10-23 v66: suggest stock dowel pins for the harness rods and podiums
    The console's harness-rod line now names the longest stock 3/16" dowel
    pin that fits (2 5/8" on the 99K, 3" on the Kenmore) ahead of cut rod;
    podium pins are 3/16" x 3/8" dowels. README and guide follow.
    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
    [vsm_base.scad]
2026-10-23 v67: balance the split so both halves are the same length
    The split moves left of the middle by half the dovetail keys' depth
    (split_balance, on by default), so the halves, the left one's keys
    included, come out the same length: the Kenmore's (attached bay) are
    231.5 x 250 mm, the longer one 4 mm shorter than before. Default 99K base
    volume 3723458.54 mm^3.
    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
    [vsm_base.scad]
2026-10-23 v68: Singer 99K hinge holes are 9/32"
    Measured on the machine (the earlier 1/4" came from cabinet lollipop
    hinges). The printed hinge's pin, its press-fit hole and the arm follow;
    the arm now stands 2.1 mm proud of the rim. Guide and README updated.
    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
    [vsm_base.scad]
2026-10-23 v69: barrel hinge
    hinge_type = barrel: the vintage portable-case barrel hinge, measured by
    Bob Drzyzgula (barrel 15.2 x 17.5 mm, arm pivoting 14.3 mm up and 4.5 mm
    forward, 6.85 mm pin reaching 30 mm from the axis, about 65 degrees of
    tilt, its own slotted screw and washer). The barrel is set so the pin
    meets the bed's hole; the arm's swing is swept and cut away, the back lip
    is notched, and the screw comes up into the barrel through a counterbore
    from below. Hinge coupon, assembly view, console report and warnings
    (pin reach against hole depth, screw head too low, pin vs hole size).
    Claude-Session: https://claude.ai/code/session_01D8r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
    [vsm_base.scad]
2026-10-23 v70: barrel hinge tapped depth 6 mm, washer 13.7 mm (measured)
    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
    [vsm_base.scad]
2026-10-23 MCU controller concept: retarget to the RP2350B
    The schematic's controller block becomes a generic RP2350B core board,
    drawn by GPIO number: FIRE GP4, RELAY GP5, ZC GP6, HALL GP7, STITCH GP10,
    NEEDLE GP12, the four analog inputs on ADC0-3 (GP40-43), ADC4-7 spare.
    5 V enters VSYS through a Schottky (D2), so USB can stay connected.
    Netlist checked against KiCad's. The paper's section 11, the README and
    the drawing's notes follow: Pico SDK in C with no RTOS, timer alarm or
    PIO for the gate pulse, edge timestamps for the hand wheel, UF2 flashing.
    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
    [mcu_controller.kicad_sch]
2026-10-23 Motor rig: part = all
    motor_rig.scad gains an 'all' part: every printed part, the motor cradle
    and the prony brake's jaws included, laid out in rows in print
    orientation. The dispatch becomes a print_part() module, and
    prony_brake.scad's print plate becomes a print_plate() module the rig can
    call. RIG_GUIDE mentions it.
    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
    [motor_rig.scad, prony_brake.scad]
2026-10-23 Rig guide: notes on filament choices
    Which rig parts see the most heat (the brake jaws, then the motor
    cradle), which carry mains, and what filaments suit them: PETG as the
    default, ASA or PC for the brake jaws on long heavy runs, PLA only for
    the cool, unloaded parts.
    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
2026-10-24 MCU controller: notes for the WeAct RP2350B Core board
    From the board's schematic: GP0 links to an optional PSRAM's chip select,
    GP23 is a button and GP25 the LED, and USB VBUS reaches the 5V rail
    through a diode, so the supply module can feed the 5V pin directly and
    D2 can be left out. The debug UART moves to GP8/GP9 (UART1), clear of
    GP0. Drawing notes, README and paper section 11 updated.
    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
    [mcu_controller.kicad_sch]
2026-10-24 MCU controller README: link WeAct's RP2350B board repository
    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
2026-10-24 hardware/PARTS.md: electronic parts across the three projects
    The electronics-catalog parts for the knee controller, the motor test
    rig and the MCU controller concept (and the base's outlet), with the
    specification that matters for substitution, quantity, where used, and
    a sourcing class (any / check / distributor for mains-safety parts).
    Bench equipment listed separately; a substitution log at the end.
    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
2026-10-24 Motor rig: print fixes from the first plates
    Lids and the triac cover are turned over for printing, not mirrored, so
    their lettering reads correctly. The cover's label moves off the vents,
    onto the plain part of the roof in two lines. The jack panel's middle rib
    moves into the gap between two holes. The IEC box prints roof-down, with
    full-height counterbored ears so nothing overhangs; only the inlet
    opening's top edge may want support. The KB3151C's tabs are .125"
    (3.2 mm) FASTON, recorded in the rig guide and the parts list.
    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
    [motor_rig.scad]
2026-10-24 MCU concept: heel tap and taught needle stops
    From Danielle's reading of the paper: what a sewist asks of a pedal (full
    power from the first movement, no heat at rest, stopping the needle up or
    down where it is wanted, and the heel tap).
    Schematic draft-4: a heel switch in either pedal (J5 and J6 now 4-pin),
    filtered to GP11; an optional hand-wheel encoder, two DRV5013 latches in
    quadrature over a ring of alternating magnets, on GP2/GP3 for a PIO
    counter, beside the DRV5023 index. Heel and encoder lines join by net
    labels; the generator now unions same-name labels, and its netlist still
    matches KiCad's. Knee group moved up 2.54 mm and the notes tightened to
    fit the sheet; the figure's crop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
    [mcu_controller.kicad_sch]
2026-10-24 Paper: fitting the encoder; directions under consideration
    Fitting the encoder: the two likely places, on the arm shaft under a
    removable top (a snap-on printed ring locked by its own set screw, room for
    many magnets, stops survive bobbin winding) and on the hand wheel where the
    arm is sealed (the 99K's sloped back face, sensor up past the belt; every
    wheel differs, the gap moves, and the stop-motion clamp means setting top
    dead center again after each bobbin); the index, and a missing-magnet
    fallback.
    Directions, recorded as ideas: a pedal-first controller without feedback,
    as a feedback-free MCU mode with mains kept in the base; load compensation
    without a machine sensor (IR compensation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
2026-10-24 MCU concept: optional motor-current transformer (T1)
    A ZMCT103C-class 1000:1 current transformer straddling the barrier, the
    motor's hot lead through its window, for sensorless IR compensation. On
    the control side: a 100 ohm burden (about 0.1 V per amp), a 1.65 V bias
    from a 10k/10k divider with 10 uF, and a 1k/10n filter into ADC4 (GP44),
    joined by the ISENSE label. Netlist still matches KiCad's. README, paper
    (barrier parts, pin table, load-compensation note) and parts list
    updated.
    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
    [mcu_controller.kicad_sch]
2026-10-25 Paper: optical encoder alternative for small shafts
    Slotted photo-IC interrupters over a printed slotted ring where a magnet
    ring can't be made large enough; the small circuit changes (logic
    outputs, LED current from 5 V); and the fitting made cleanable, so
    wiping the encoder joins regular oiling and cleaning. Reflective sensing
    noted as the more fragile choice.
    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
2026-10-25 Optical shaft encoder: a concept model (hardware/encoder/)
    A split, clip-on slotted ring (40 mm, 36 open-ended slots) for the
    Kenmore 158's 11 mm shaft, read by two photo-IC forks 4.25 pitches apart
    (quadrature, 144 counts a turn); a single magnet and Hall switch for the
    index, which also lets the firmware check the count each turn; a printed
    bracket with fork pockets, a Hall finger, and one anchor screw in a
    vertical slot for adjustment. README with renders and the open questions.
    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
    [optical_encoder_concept.scad]
2026-10-26 MCU controller: header soldering stand for the WeAct RP2350B board
    From a separate thread: an OpenSCAD jig that holds generic 0.1" headers
    square while they're soldered, in body-bottom and body-top (pocketed)
    variants, with pin and part data extracted from WeAct's STEP model and
    the script that extracts it. STLs are built from the model, as elsewhere
    in the repository. Linked from the controller README and the to-do list.
    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
    [rp2350b_data.scad, rp2350b_header_stand.scad]
2026-10-26 Move the RP2350B header stand out to Header-Soldering-Jigs
    The stand is now maintained, with KiCad footprints and symbols for the
    WeAct RP2350B and Pico 2 boards, in its own repository of bench
    fixtures. Remove the copy here and link to it from the controller README
    and the to-do list.
    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
    [rp2350b_data.scad, rp2350b_header_stand.scad]
2026-10-26 Encoder: a printed slide gauge for the shaft's height above the casting floor
    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
    [shaft_height_gauge.scad]
2026-10-27 Encoder: Kenmore 158 measurements (shaft 12.25 mm, 20 mm above the floor)
    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
    [optical_encoder_concept.scad]
2026-10-27 Encoder: snap-on test collars for finding the ring's bore on the shaft
    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
    [shaft_fit_collars.scad]
2026-10-27 Encoder: ring bore 12.25 mm, from the test collars on the Kenmore 158
    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
    [optical_encoder_concept.scad]
2026-10-27 Encoder ring: real clamp-screw seats, flush magnet, flat printing
    The head counterbores and nut traps had been placed from the hub's top,
    above the curved surface at the screws, so they cut nothing; they now
    seat 1 mm in from the surface there, 11.65 mm apart, for M2 x 14 socket
    cap screws and M2 nuts, with the nut traps sized to the nut (4.0 mm
    across flats) and turned flats-along-the-shaft. The index magnet now
    sits flush in the disc's +X face with a short boss behind it, so each
    half prints flat (bore vertical, as the fit collars did) without
    supports; ring_half_bottom added. Hall switch moved to 1 mm from the
    face, and the bracket's clearance cut shortened to match.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
    [optical_encoder_concept.scad]
2026-10-27 Standalone: shaft height gauge and shaft fit collars
    Both were made for fitting the optical encoder to the Kenmore 158 and are
    useful well beyond it, so each now has its own folder under standalone/
    with a README (use, printing, settings, first results) and a picture. The
    encoder README points to them, the main README lists them, and the
    release workflow attaches both models.
    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
    [optical_encoder_concept.scad, shaft_fit_collars.scad, shaft_height_gauge.scad]
2026-10-27 Move the motor test rig to standalone/motor-rig
    Nothing in it depends on the main model. Paths updated in the Makefile
    (the rig guide's PDF still builds), the README, the triac board's README,
    the parts list and the motor-control paper; the guide's link to the
    triac schematic now reaches across to hardware/. A short README.md
    points to RIG_GUIDE.md, and releases now attach the rig's three models
    alongside its PDF.
    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
    [motor_cradle.scad, motor_rig.scad, prony_brake.scad]
2026-10-27 Encoder ring: heat-set inserts in the bottom half, and a cradle to press them
    M2 x 4 x 3.5 inserts go into the bottom half from its split face, on the
    bench, replacing the nut traps (still available with clamp_fastener =
    "nut"). The hub grows to 25 mm and the screws move out to 3 mm from the
    bore, leaving about 1.4 mm of wall to the bore and 1.8 mm outside. The
    screw hole runs on through below the insert, so M2 x 11 to x 16 all fit.
    New part insert_cradle holds the bottom half split face up and level,
    supported under the hub at the inserts. README gains assembly steps.
    Claude-Session: https://claude.ai/code/session_01D8rC2JDyb9T3n3ujD2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
    [optical_encoder_concept.scad]
2026-10-27 Encoder: print the ring halves with fine layers (0.12 mm)
    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
    [optical_encoder_concept.scad]
2026-10-27 Add a companion paper: Inside the Motor
    Construction, waveforms and DC alternatives for sewing-machine drives, as
    a companion to the speed-control paper (docs/motor-construction/):
    - the universal motor in iron and copper, and how each part makes up R, L,
    K and the back-EMF; why it runs slower on AC; nameplate ranges;
    - the universal motor on the wire: straight on the line, behind a
    rheostat, and chopped by a triac at 45, 90 and 120 degrees, showing how
    the inductance stretches and smooths the current;
    - wound-field DC, brushed permanent-magnet and brushless motors treated
    in parallel: construction, equations, control (SCR drives, chopper,
    H-bridge, six-step, FOC) and waveforms (P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
2026-10-27 Encoder insert cradle: seat on the hub, flush top, anti-roll ribs
    The first cradle's disc pocket had 0.4 mm clearance and the hub's 0.3, so
    the half bottomed on its teeth and sat 0.4 mm below the top, and rolled in
    its round pocket when one insert was pressed. The hub pocket now bottoms
    first (0.1 mm), the top is set down to match, and ribs in three slots stop
    the roll.
    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
    [optical_encoder_concept.scad]
2026-10-27 Encoder: show the insert cradle's settings in the customizer
    They were declared after the first module, where the customizer doesn't
    look; now in their own [Insert cradle] section with the other parameters.
    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
    [optical_encoder_concept.scad]
2026-10-27 Inside the Motor §3: how a triac switches
    Explain latching and holding current, why a triac gives only leading-edge
    phase control, and why trailing-edge control (MOSFET/IGBT) suits a motor
    badly.
    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
2026-10-27 Inside the Motor §2: one constant here, two later
    Explain K_e and K_t as the two jobs of k·Phi, why they are equal in SI,
    and that the series motor's K·i is both at once; point §4 back to it.
    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
2026-10-27 Inside the Motor §5: hearing the switching frequency
    The cordless drill's whine at the edge of the trigger as a real-world
    example of PWM singing: where it comes from, why it is loudest before the
    rotor turns, other battery tools versus corded triac tools, and how to
    measure it.
    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
2026-10-27 Inside the Motor §5: measured spectra of two cordless tools
    Bob's phone-FFT screenshots of a DeWalt drill and impact driver (room
    alone, trigger just in, trigger fully in), kept in
    docs/images/motors/measured/ and replotted by tools/make_tool_spectra.py.
    The drill switches at about 3.85 kHz (harmonics at 7.7 and 15.4 kHz,
    dropping to about 3.3 kHz at full trigger); the impact driver shows 7.7
    and 15.4 kHz and a speed line rising from 320 to 380 Hz.
    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
2026-10-27 Inside the Motor §5: name the measured tools
    DeWalt DCD780 drill driver and DCF885 impact driver, both brushed (from
    Bob's nameplates); the drill's speed switch is a gear selector (its
    manual). Drop the brushless explanation for the impact driver's 7.7 kHz
    line, and tie the 320-380 Hz line to motor speed against the nameplate
    rpm.
    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
2026-10-27 Inside the Motor: new §7 on induction motors
    Construction (squirrel cage), the rotating field and synchronous speed,
    slip and the torque curve (new figure, Kloss approximation, with V/f
    curves at 60/40/20 Hz), single-phase starting, the industrial clutch
    motor, and the variable-frequency drive. Adds an induction column to the
    comparison table and a point to the summary; later chapters renumbered
    (comparison §8, DC for vintage §9, sources §10).
    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
    [make_motor_waveforms.py]
2026-10-27 Inside the Motor sources: note the standard texts
    Say that the motor construction and theory are standard textbook material,
    and name the two standard references (Hughes and Drury; Fitzgerald,
    Kingsley and Umans).
    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
2026-10-27 MCU controller: DC-motor variant concept (775 on a G2 H-bridge)
    hardware/mcu-controller-dc/: the mains controller's control side unchanged,
    with the triac, zero-cross, relay and isolated supply replaced by a 24 V
    adapter input (fuse, TVS, bulk), a 5 V buck, a Pololu G2 24v13 H-bridge,
    current, bus and motor-terminal sensing, and an optional brake chopper.
    Generated by tools/make_dc_schematic.py; KiCad's netlist matches the
    intended one. Described in the motor-control paper (§11, A DC-motor
    variant) and pointed to from Inside the Motor §9; figure exported by
    tools/export_schematic.sh; TODO gains the bench step.
    Claude-Session: https:/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
    [mcu_controller_dc.kicad_sch]
2026-10-28 MCU controller: rectified-DC variant (triac, bridge, freewheel diode)
    hardware/mcu-controller-rectified/: the mains concept with a bridge
    rectifier (BR1) and freewheeling diode (D3) between the triac and the
    motor, which moves to its own keyed connector (J3); the outlet keeps only
    the light; the current transformer sits in the bridge's AC lead.
    Generated by tools/make_rectified_schematic.py; KiCad's netlist matches.
    New simulated figure (universal-bridge.svg): at 120 deg the current no
    longer reaches zero and the speed rises from ~970 to ~1690 rpm; at 135 deg
    it still runs (~390 rpm). Described in the motor-control paper (§11, A
    rectified-DC variant); TODO gains the rig comparison.
    Co-Auth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
    [mcu_controller_rectified.kicad_sch]
2026-10-28 Encoder insert cradle: one thin rib with a lead-in
    The ribs at +/-2 slots met their slots at 20 degrees to the drop and broke
    teeth on Bob's print. Keep only the rib straight below the bore (it alone
    stops the roll), thin it to 0.6 mm and point its inner end (key_lead).
    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
    [optical_encoder_concept.scad]
2026-10-28 Shaft height gauge: print the slider upright, with tree supports
    Bob found the upside-down orientation leaves the friction tongue floating
    for most of its height; upright with tree supports under the arm (and
    support interface material) printed perfectly. The slider part now comes
    out upright, and the README and file header say so.
    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
    [shaft_height_gauge.scad]
2026-10-28 Encoder: replace the bracket with a saddle on the casting floor
    The 158 has about 20 mm under the shaft and the ring's teeth come within
    ~6 mm of the floor, so nothing can hang below it. The new saddle part sits
    on the floor: its top an arc 1 mm outside the tooth tips, the forks in
    pockets with their bodies sunk in, a finger for the Hall switch, and lead
    channels in the underside. Set by eye with the ring turning, then glued at
    its edges (or taped: mount_gap). Height from axis_h (26.1 mm); ribs and
    the spring cut out with keepouts once measured. Views regenerated.
    Claude-Session: https://claude.ai/code/session_01D8rC2JDyb9T3n3ujD2pgX4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
    [optical_encoder_concept.scad]
2026-10-28 Floor span gauge: a small sliding gauge for the bay between floor ribs
    standalone/floor-span-gauge/: a 3.5 mm-tall channel body (the back jaw)
    and a sprung slider (the front jaw) carrying raised mm and inch scales,
    28-46 mm, lettering turned to read with the body on the left; jaws
    chamfered for a rib-foot fillet. Two-colour by filament change or a
    separate slider_marks part. For the Kenmore 158's bay under the shaft;
    linked from the READMEs and TODO, attached to releases.
    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
    [floor_span_gauge.scad]
2026-10-28 Floor span gauge: scale lines and lettering wide enough to slice
    Bob's first print sliced the scale to blobs: 0.3 mm ticks and bold text
    whose strokes were about 0.3 mm are under a 0.4 mm nozzle's line. Lines
    are now line_w (0.5 mm) and lettering is offset to match; inch labels in
    decimals, since fraction glyphs are finer still; text 2.2 mm, slider 14 mm
    wide; unit labels moved clear of the numbers.
    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
    [floor_span_gauge.scad]
2026-10-28 Floor span gauge: colour-tag the slider for a two-colour 3MF
    Bob's change: the slider part's bar and scale carry colours, so exported
    as 3MF they open in Bambu Studio or Orca as a two-colour part. README and
    file header describe it.
    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
    [floor_span_gauge.scad]
2026-10-28 Floor span gauge: printed
    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
2026-10-28 Floor span gauge README: don't guess the filament
    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
2026-10-28 README: Inside the Motor and the rig guide; what make images needs
    List the companion paper and the rig guide under Documentation and
    Credits, and spell out make images' extra requirements: OpenSCAD with
    BOSL2, KiCad 7+ (kicad-cli), and Python with matplotlib, NumPy and Pillow.
    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
2026-10-30 v71: a ruler and logos on the front face (Danielle's idea)
    ruler = true puts one to three stacked scales (inch, cm or custom; inch
    below cm by default, from 5 mm up, 8 mm each) across the base's flat front
    face, on the base and a built-in compartment only. Each scale has its own
    divisions and longer-tick interval; units numbered over their long ticks,
    the scale's name over the first half unit; lines at least ruler_line_w,
    lettering thickened to match. A ruler low enough to meet the harness rods'
    holes stops just clear of them (the console says so and gives the
    ruler_bottom that clears them). logo_left / logo_right place SVG logos in
    the face's upper corners, stretched to logo_size. face_reli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
    [vsm_base.scad]
2026-11-02 Bobbin box v3: SVG images on any of the six faces
    Raised, engraved or inlaid; raised and inlaid images are color-tagged,
    each face its own random color and the body another, for a 3MF export.
    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
    [bobbin_box.scad]
2026-11-02 v72: inlaid ruler and logos; each mark color-tagged
    face_relief gains inlaid (engraved and filled flush). Raised and inlaid
    marks get random color tags, the ruler, each logo and the base each its
    own, as separate objects split with the base, so a 3MF export carries
    each as a colored part. face_color_seed replaces face_relief_color.
    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
    [vsm_base.scad]
2026-11-02 Motor-control paper: the minimal triac circuit, the snubber, and RV2
    Section 5: a minimal triac phase-control circuit and simulated waveforms,
    how the timing network and diac set the firing angle, the capacitor's
    memory behind snap-on, and the snubber: commutation and static dV/dt,
    snubberless triacs, and why to fit one anyway. Section 11.1: the KB3151C
    timing network's parallel resistance with RV2, worked through and
    simulated across RV2's range, and what a sewist notices. Figures from
    tools/make_triac_figures.py.
    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
2026-11-02 v73: logo places on the back and bottom, for maker's marks
    Two SVGs near the back face's lower corners (clear of the harness rods'
    holes, following face_relief) and two on the bottom, centered on each
    half of the base whether or not it is split (engraved or inlaid, by
    bottom_relief). Each is color-tagged when raised or inlaid; eight colors
    in all.
    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
    [vsm_base.scad]
2026-11-02 v74: lollipop hinge stand-in in the assembly and exploded views
    A simple stand-in sized from the recess settings and the profile's pin:
    the flanged disc, a square stub, the round pin, and the screw. The
    exploded view lifts lollipop and barrel hinges out of their recesses.
    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
    [vsm_base.scad]
2026-11-02 Guide renders: assembly and exploded views with the lollipop hinges
    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
2026-11-02 Foot-rig target sheet: a full-size printed grid to go under the rig
    tools/make_foot_rig_sheet.py reads the rig's dimensions from the model for
    a profile and draws a 1:1 PDF: a blue millimeter grid with coordinates,
    the rig's outline, marking-hole crosshairs and screw holes, corner markers
    for photographs, and scale bars to check the print.
    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
2026-11-03 Inside a Switching Circuit: a second companion paper
    The triac and donor-board material added to the speed-control paper moves
    into its own paper, docs/switching/: the thyristor and its two-transistor
    model, the triac and diac, a phase-control pedal part by part, the
    snubber, the KB3151C and its RV2 trimmer worked through, and transistor
    switches (MOSFETs, IGBTs, leading and trailing edge). The speed-control
    paper's section 5 and 11.1 return to their short form, with pointers.
    New figures: the SCR's layers as two transistors, and leading versus
    trailing edge. Built by make docs and attached to releases.
    Claude-Session: https://claude.a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
    [make_triac_figures.py]
2026-11-04 Inside a Switching Circuit: the triac's and diac's structure
    Section 3 gains a cross-section of the triac (its two SCRs folded into
    one chip, with N2, N3 and N4 emitters and shorted emitters), how each of
    the four quadrants fires through that structure, and the diac's three
    layers with its current-voltage curve and the physics of its negative
    resistance. Section 2 adds why the gains rise with current and what the
    layers' doping sets. The quadrant table's signs are now words: a leading
    + in a cell became a numbered list in the PDF.
    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
    [make_triac_figures.py]
2026-11-08 Note the Sewing Notions copies of the bobbin box and tilt prop
    The standalone bobbin box and tilt prop are now also kept in the Sewing
    Notions repository. Each .scad header and README points to the other
    copy, and a new CLAUDE.md tells Claude to ask Bob, whenever either copy
    changes, whether to make the same change in the other. The models are
    otherwise unchanged.
    Claude-Session: https://claude.ai/code/session_01UJ98TmUVQRnANvrxYahN4H
    [bobbin_box.scad, tilt_prop.scad]
2026-11-09 Tilt prop: printed in PLA and in use on a Singer 99
    The standalone tilt prop, printed in basic PLA at the default settings,
    holds a Singer 99 tipped back, including one fitted with the chromed
    light, without much deflection. The same status note goes into the copy
    in Sewing-Notions.
    Claude-Session: https://claude.ai/code/session_01UJ98TkFdiY4JRQbpPmSdxK
